wandrewkeech/SnakeOil-XY/README.md

Banner-logo

<a href="https://discord.gg/WZVP2HuAag" style="height: 40px !important;">Join us on Discord</a>

<a href='https://www.amazon.jp/hz/wishlist/ls/2AHXTCG01RYAZ?ref_=wl_share' target='_blank'>Buy Me a spool at amazon Japan</a>

# SnakeOil XY

Fully open source configurable high speed CoreXY 3D printer. Inspired by [HevORT](https://miragec79.github.io/HevORT/), [Voron](https://vorondesign.com/), [Annex Engineering](https://github.com/Annex-Engineering) and [EVA2](https://main.eva-3d.page/) design.

- Does not require any custom-machined parts or custom-cut panels.
- CoreXY, IDEX, and Extended-CoreXY kinematics.
- Designed to last, parts under stress are embedded with long bolts to handle the load.
- And our industry-leading SnakeOil technology :3 

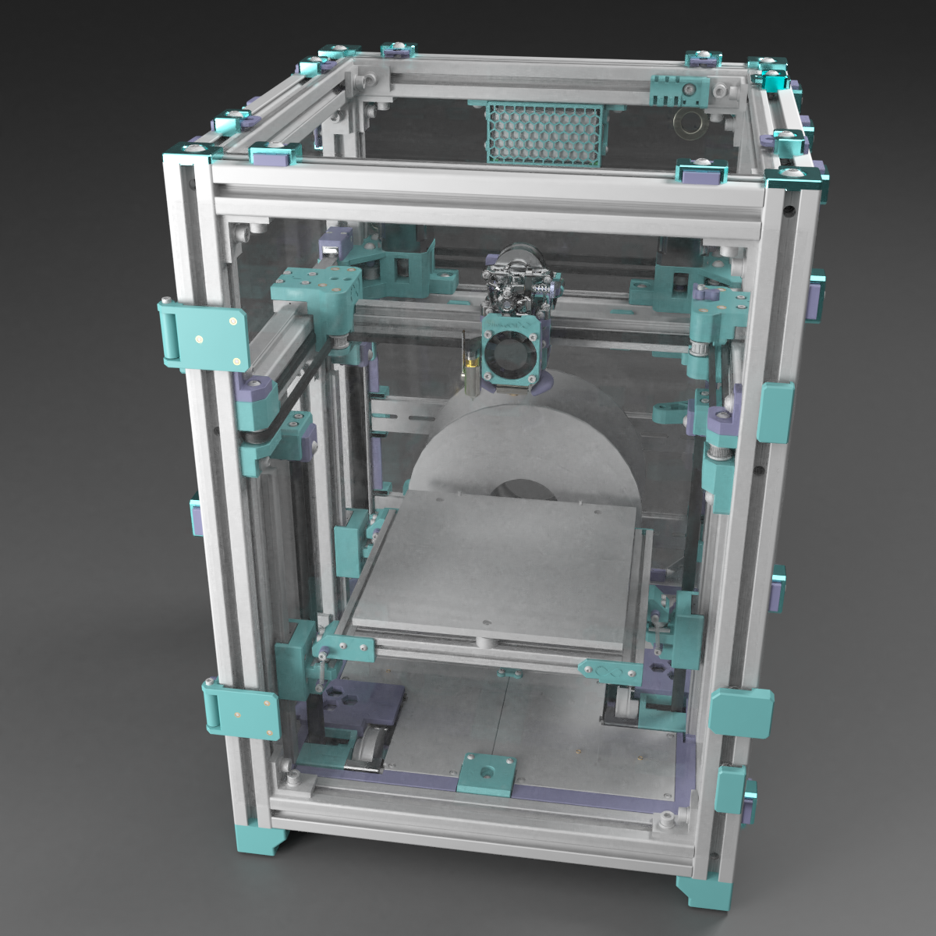
[picture p1: Doc/img/angle-render.png]
Render-angle


## Beta 3 release (2023-01-28)

- Add [IDEX variant](./BETA3_IDEX_Release_STL)(by Charles)
- Add [4PR variant](./BETA3_4PR_Release_STL) with new [Extended CoreXY kinematic](https://github.com/SnakeOilXY/klipper-extended-corexy-kinematic)
- Add klicky probe support(by Charles)
- New bed coupling kinematic using silicon spacers
- Add side-blower aux fan module
- Add EBB can toolhead board support
- Remove outdated components
- Merge toolhead design(1515 and 2020 gantry now use the same toolhead front/back/bottom design) and some small improvements on geometry

## Features

<table>
    <thead>
        <tr>
            <th>Feature</th>
            <th>Credit/Inspiration by/Description</th>
        </tr>
    </thead>
    <tbody>
        <tr>
            <td>Selectable kinematic : CoreXY, Hibryd-CoreXY </td>
            <td>Added on beta3 release</td>
        </tr>
        <tr>
            <td>Selectable single or dual toolhead </td>
            <td>Added on beta3 release</td>
        </tr>
        <tr>
            <td>3 Point auto bed tramming</td>
            <td>HevORT, Wobble ring</td>
        </tr>
        <tr>
            <td>Belted Z</td>
            <td>Lulz bot, Voron</td>
        </tr>
        <tr>
            <td>Din mounter</td>
            <td>Voron</td>
        </tr>
        <tr>
            <td>Cross belt corexy belt path</td>
            <td>HevORT</td>
        </tr>
        <tr>
            <td>Eva compatible toolhead</td>
            <td>EVA</td>
        </tr>
        <tr>
            <td>Filament spoll in side chamber</td>
            <td>-</td>
        </tr>
        <tr>
            <td>Quick release panels</td>
            <td>Added on beta2 release</td>
        </tr>
        <tr>
            <td>Built-in chamber air filter</td>
            <td>Added on beta1 release</td>
        </tr>
        <tr>
            <td>Auto build sheet detect and profile loader</td>
            <td>Work in progress</td>
        </tr>
        <tr>
            <td>AIO filament runout + jam detector + width sensor</td>
            <td>Work in progress</td>
        </tr>
        <tr>
            <td>Modular sensor add-on system</td>
            <td>Work in progress</td>
        </tr>
        <tr>
            <td>Probe(bed mesh) on print area only</td>
            <td>Added on beta2 using klipper macro</td>
        </tr>
        <tr>
            <td>Screwless belt mounter</td>
            <td>VzBot</td>
        </tr>
        <tr>
            <td>Bed fan</td>
            <td>Qholia</td>
        </tr>
    </tbody>
</table>

## Input shaper test result (beta2 1515 gantry with Sherpa mini extruder)

Shaper

## Layer pitch measure (beta2 1515 gantry with Sherpa mini extruder)

- Measure result provided by [株式会社グーテンベルク](https://gutenberg.co.jp/)
- PLA, 0.4mm nozzle, sliced with Cura 4.12.1 using "CoreXY FAST" profile.

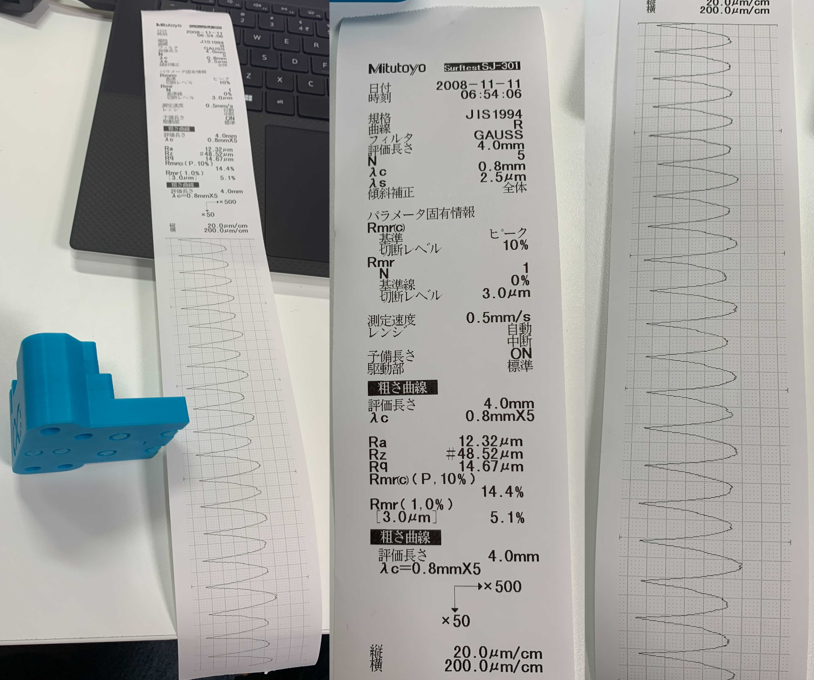
[picture p2: Doc/img/layer-measure.png]
Shaper


## Demo videos

<table>
    <thead>
        <tr>
            <th></th>
            <th align="center">Bed coupling</th>
            <th align="center">SpeedBoatRace</th>
            <th align="center">Slow benchy</th>
        </tr>
    </thead>
    <tbody>
        <tr>
            <td>Video</td>
            <td align="center"><a href="https://youtu.be/pQPhEykthEg" rel="nofollow">
            Bed coupling</a></td>
            <td align="center"><a href="https://youtu.be/tPoP6zmxsCY" rel="nofollow">
            Speed benchy</a></td>
            <td align="center"><a href="https://youtu.be/kLawpgAUUPE" rel="nofollow">
            Speed benchy</a></td>
        </tr>
        <tr>
            <td>Hardware version</td>
            <td align="center">beta1</td>
            <td align="center">beta2</td>
            <td align="center">beta2</td>
        </tr>
    </tbody>
</table>

## BOM

## **_SnakeOil-XY currently has 2 versions_**

<code>Both machines are practicaly identical, only difference is the build volume. </code>

### 180x180x180mm build volume (Standard)

- [180<sup>3</sup>mm BOM](./Doc/BOM/bom-180.md)

### 250x240x230mm build volume (Large)

- [250<sup>3</sup>mm BOM](./Doc/BOM/bom-250.md)

## Manual

[>>> Click here <<<](./Doc/Manual/README.md)

## Firmware

[>>> Click here <<<](./Firmware/README.md)

## Copyright Notice

- [Sherpa mini extruder](https://github.com/Annex-Engineering/Sherpa_Mini-Extruder) is an original work of [Annex Engineering](https://github.com/Annex-Engineering), modified parts using their source code/design files are re-released under [ANNEX Engineering License](https://github.com/Annex-Engineering/ANNEX-Engineering-License-Agreement/blob/main/LICENSE.md).
- [EVA2](https://github.com/EVA-3D/eva-main) is an original work of [EVA-3D](https://github.com/EVA-3D), modified parts using their source code/design files are re-released under [GNU General Public License v3.0](https://github.com/EVA-3D/eva-main/blob/main/LICENSE)
- This printer design(SnakeOil XY), it's document and software are released under [GNU General Public License v3.0](https://github.com/ChipCE/SnakeOil-XY/blob/master/LICENSE)
