wandrewkeech/SnakeOil-XY/BETA3_4PR_Release_STL/README.md

# BETA3 Release - 4PR variant

4PR(four paws runner) is an upgrade can add ontop of standard SnakeOilXY machines. This upgrade use our new kinematic called [Extended-corexy](https://github.com/SnakeOilXY/klipper-extended-corexy-kinematic).

## BOM

<table>
    <thead>
        <tr>
            <th>Item</th>
            <th>Quantity</th>
            <th>Description</th>
            <th>default link/affiliate link</th>
            <th>non-affiliate link</th>
        </tr>
    </thead>
    <tbody>
        <tr>
            <td>M3x4-HeatSet</td>
            <td>12</td>
            <td>M3 X D4.2 X L4.0</td>
            <td><a href="https://s.click.aliexpress.com/e/_Ad1n92" rel="nofollow">Aliexpress</a></td>
            <td><a href="https://www.Aliexpress.com/item/1005002526998853.html" rel="nofollow">Aliexpress</a></td>
        </tr>
        <tr>
            <td>M4 hex nut</td>
            <td>2</td>
            <td></td>
            <td></td>
            <td></td>
        </tr>
        <tr>
            <td>Socket head M3x10</td>
            <td>8</td>
            <td>button head also works</td>
            <td>-</td>
            <td>-</td>
        </tr>
        <tr>
            <td>Socket head M3x25</td>
            <td>4</td>
            <td>button head also works</td>
            <td>-</td>
            <td>-</td>
        </tr>
        <tr>
            <td>Button head M3x12</td>
            <td>8</td>
            <td>-</td>
            <td>-</td>
            <td>-</td>
        </tr>
        <tr>
            <td>Button head M3x30</td>
            <td>8</td>
            <td>-</td>
            <td>-</td>
            <td>-</td>
        </tr>
        <tr>
            <td>Button head M5x25</td>
            <td>4</td>
            <td>-</td>
            <td>-</td>
            <td>-</td>
        </tr>
        <tr>
            <td>Button head M6x14</td>
            <td>6</td>
            <td>-</td>
            <td>-</td>
            <td>-</td>
        </tr>
        <tr>
            <td>Grub screw M5x20</td>
            <td>2</td>
            <td>-</td>
            <td>-</td>
            <td>-</td>
        </tr>
        <tr>
            <td>Nema 17 motor</td>
            <td>2</td>
            <td>Use the same type as AB motors.max length 48mm</td>
            <td>-</td>
            <td>-</td>
        </tr>
        <tr>
            <td>20T 6mm Pulley (5mm bore)</td>
            <td>2</td>
            <td>-</td>
            <td>-</td>
            <td><a href="https://www.Aliexpress.com/item/33023279793.html" rel="nofollow">Aliexpress</a></td>
        </tr>
        <tr>
            <td>20T 6mm Smooth Idler (5mm bore)</td>
            <td>2</td>
            <td>-</td>
            <td>-</td>
            <td><a href="https://www.Aliexpress.com/item/33023133633.html" rel="nofollow">Aliexpress</a></td>
        </tr>
        <tr>
            <td>20T 6mm Tooth Idler (5mm bore)</td>
            <td>4</td>
            <td>-</td>
            <td>-</td>
            <td><a href="https://www.Aliexpress.com/item/33023133633.html" rel="nofollow">Aliexpress</a></td>
        </tr>
        <tr>
            <td>MR115 bearing</td>
            <td>2</td>
            <td>-</td>
            <td>-</td>
            <td>-</td>
        </tr>
    </tbody>
</table>

## Other info

- comming soon
