wandrewkeech/SnakeOil-XY/Mods/LCD_12864_RepRapDiscount/README.md

# RepRapDiscount Full Graphic Smart Controller (128x64 ST7920)

This type of LCD screen is often used in older Chinese 3D printers. This model would be useful for those who cannibalize old printers to build SnakeOil-XY. Silkscreen reads like: "RepRapDiscount Full Graphic Smart Controller www.bigtree-tech.com".

LCD controller: ST7920

[printer.cfg sample](sample-printer-cfg.cfg) - you can replace the latter part with the pin arrangement of your MCU.
