wandrewkeech/SnakeOil-XY/Mods/Nevermore_Filter/IDEX/README.md

# Nevermore mount for SnakeOil-XY IDEX **(UNTESTED)**

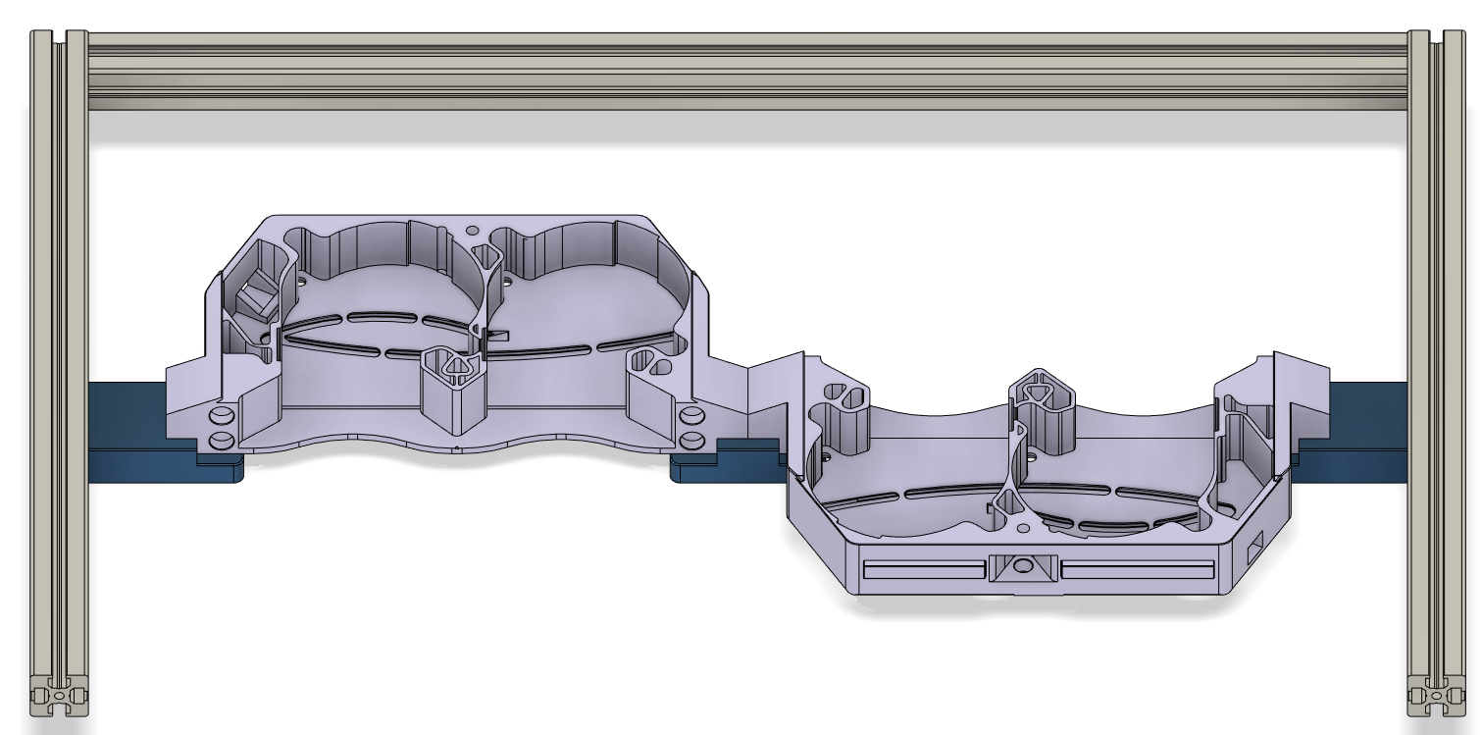
[picture p7: Doc/img/nevermore-idex.png]
nevermore-idex
