wandrewkeech/SnakeOil-XY/BETA3_IDEX_Release_STL/STLs/E-axis/README.md

# Toolhead, hotend and EVA2

Check [EVA compatible document for more info](https://github.com/SnakeOilXY/SnakeOil-XY/blob/master/Doc/Manual/eva2.md)
