wandrewkeech/SnakeOil-XY/BETA3_Standard_Release_STL/STLs/Add-on/AUX-fan/image.png

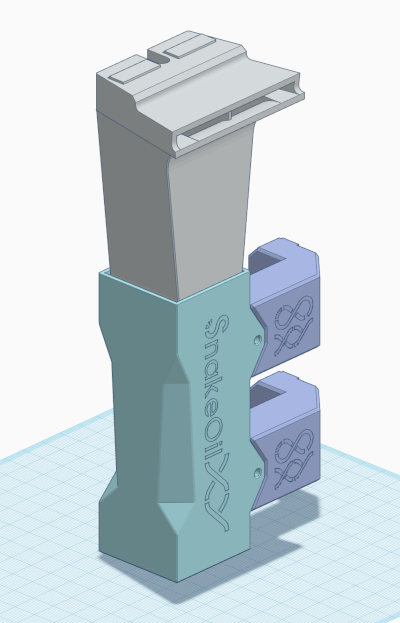
BETA3_Standard_Release_STL/STLs/Add-on/AUX-fan/image.png
