wandrewkeech/SnakeOil-XY/CAD/Render/v1-180_render.png

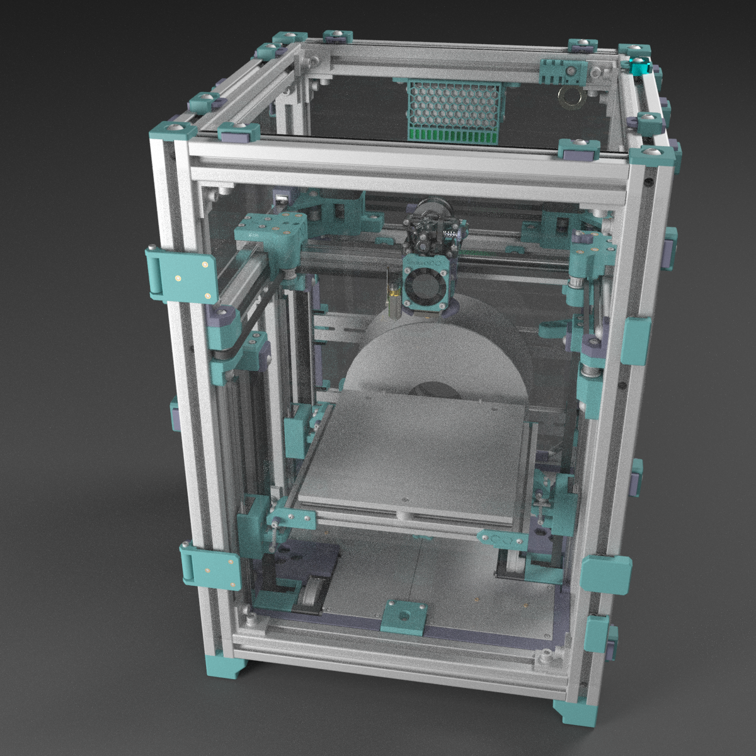
CAD/Render/v1-180_render.png
