wandrewkeech/SnakeOil-XY/Doc/img/all-bracket.png

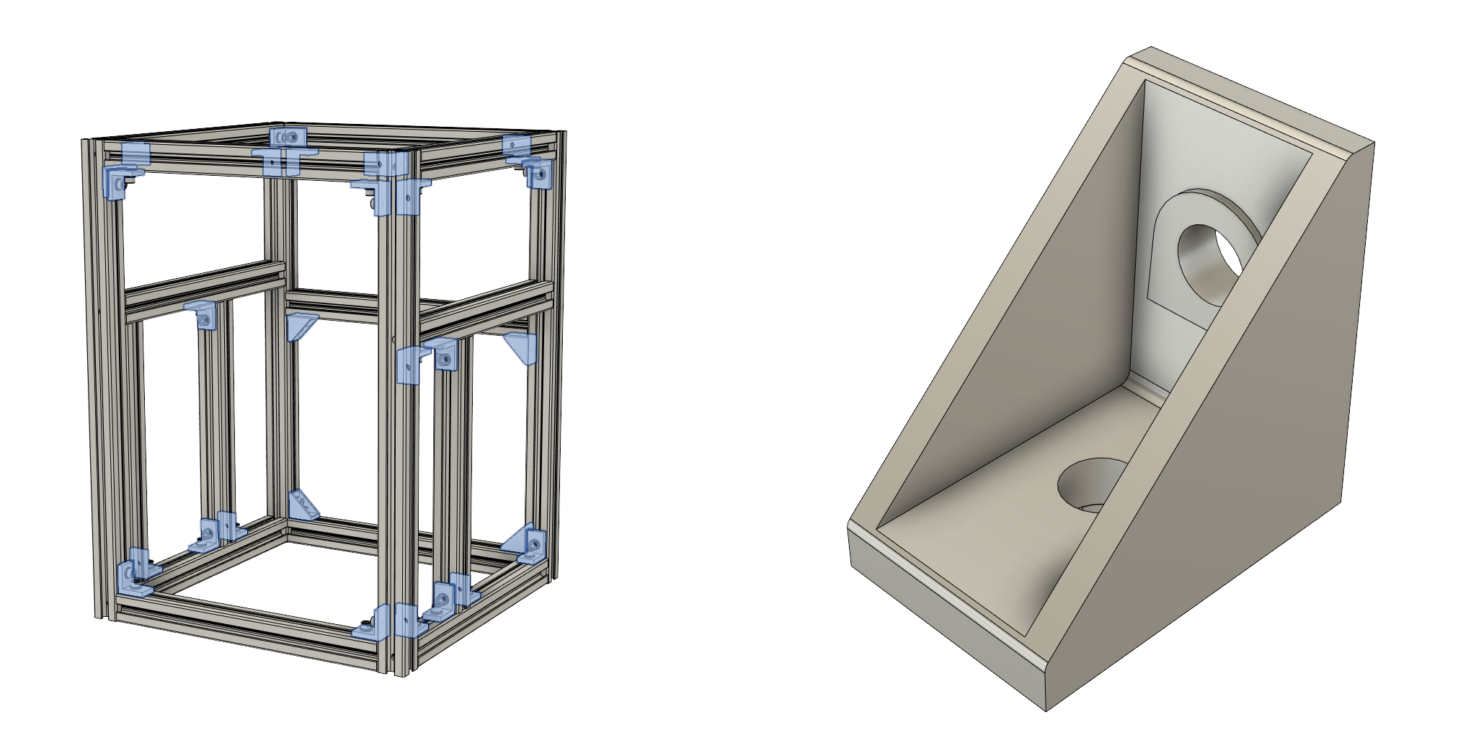
Doc/img/all-bracket.png
