wandrewkeech/SnakeOil-XY/Doc/img/close-render.png

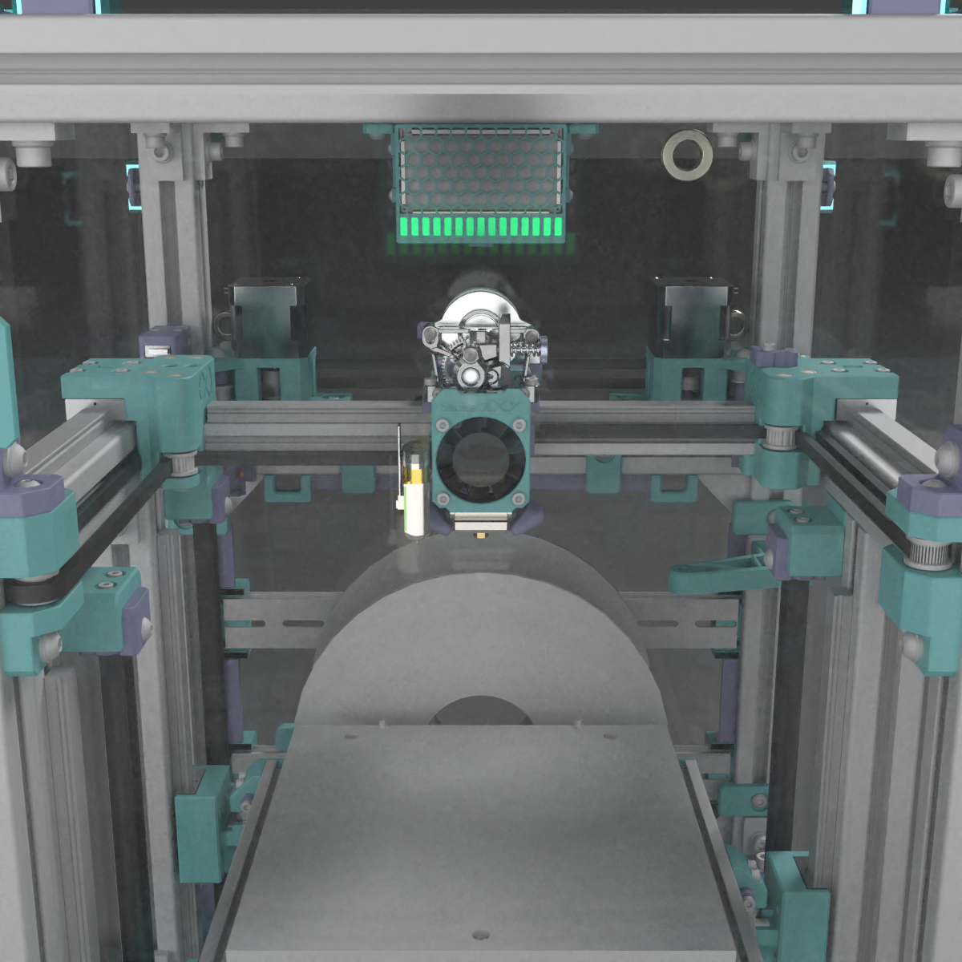
Doc/img/close-render.png
