wandrewkeech/SnakeOil-XY/Doc/img/front-render.png

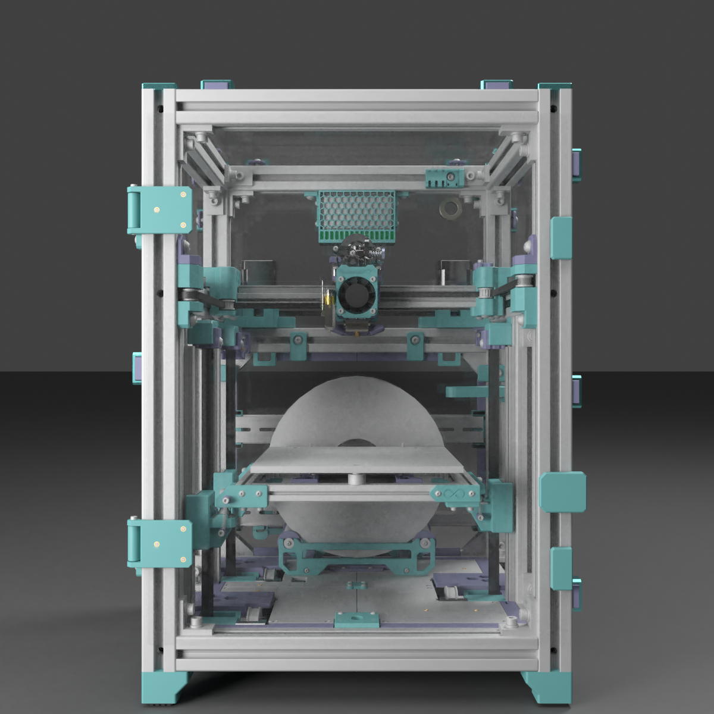
Doc/img/front-render.png
