wandrewkeech/SnakeOil-XY/Doc/img/normal-bracket.png

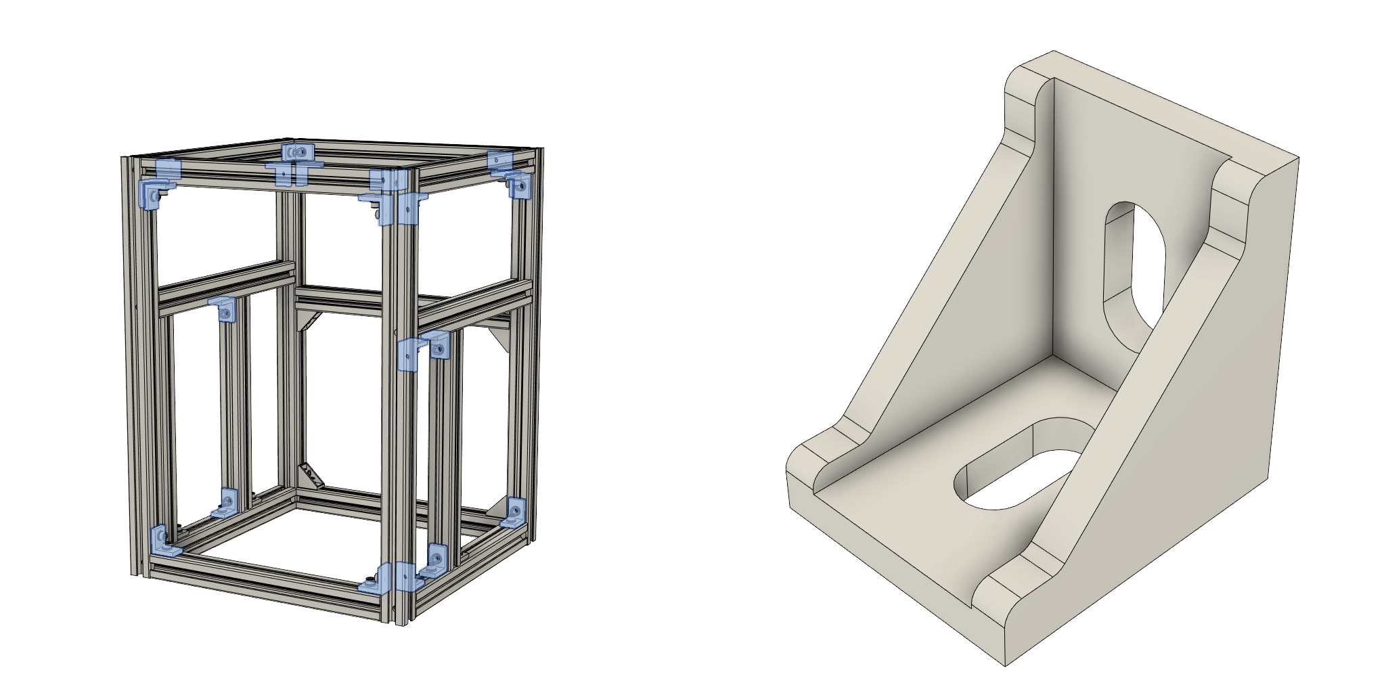
Doc/img/normal-bracket.png
