wandrewkeech/SnakeOil-XY/Slicer/Prusa/180_bed_texture.png

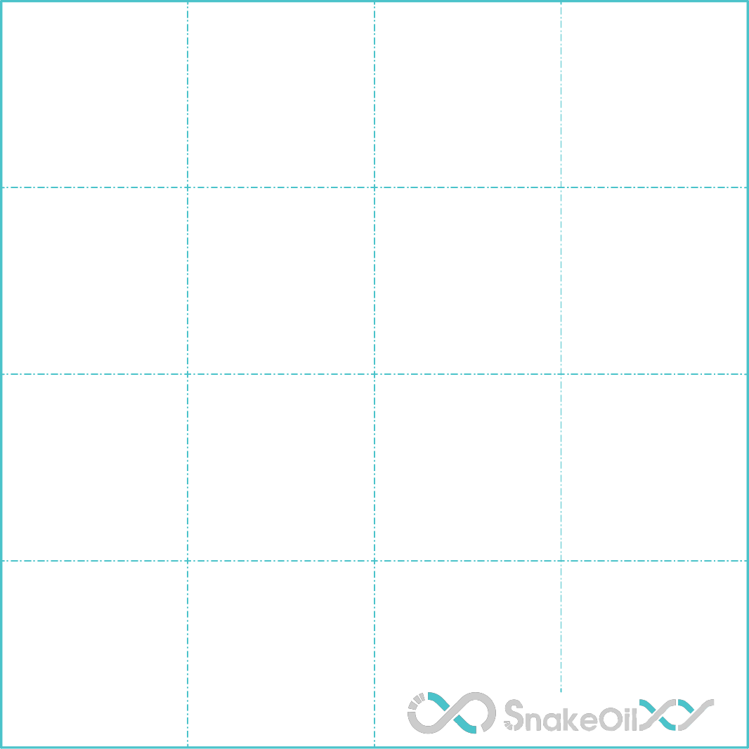
Slicer/Prusa/180_bed_texture.png
