wandrewkeech/SnakeOil-XY/Slicer/Prusa/250_bed_texture.png

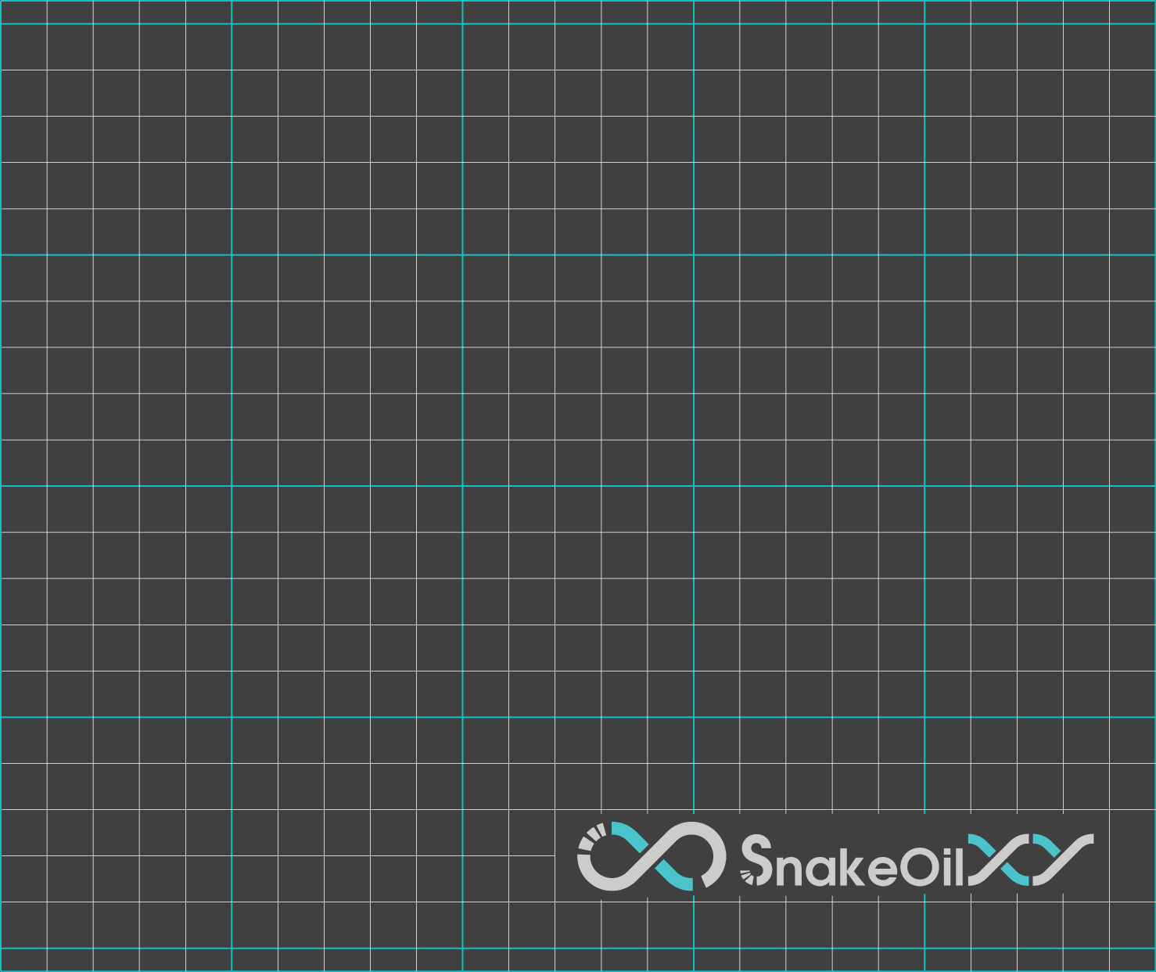
Slicer/Prusa/250_bed_texture.png
