wandrewkeech/SnakeOil-XY/Doc/BOM/bom-180.md

# BOM

<code>Status : work in progress</code>  
<code>Last updated : 2022-02-17</code>

<code> Fell free to [contact me](https://discord.gg/WZVP2HuAag) if you spot mistake or have question.</code>

## Read this first

## Table of contents

- [Kit](#0Kit)
- [Frame](#1Frame)
- [Fasteners](#2Fasteners)
- [Motion](#3Motion)
- [Electronics](#4Electronics)
- [Panels](#5Panels)
- [Other](#6Other)
- [Alternative bed coupling options](#7Alternative-bed-coupling-options)
- [Z counter weight](#8Z-counter-weight)

# 0.Kit

Some parts listed on the BOM can be purchased in kit format from below vendors

- [kb-3d.com store](https://kb-3d.com/store/81-snakeoilxy)
- [Mellow motion kit](https://s.click.aliexpress.com/e/_DDaa32j)

# 1.Frame

- [Main Frame](#main-frame)
- [Bed](#bed)
- [Gantry](#gantry)

## Main Frame

<table>
    <thead>
        <tr>
            <th>Item</th>
            <th>Quantity</th>
            <th>Misumi code</th>
        </tr>
    </thead>
	  <tbody>
        <tr>
            <td>3030 Extrusion 280mm</td>
            <td>3</td>
            <td>HFS6-3030-280</td>
        </tr>
        <tr>
            <td>3030 Extrusion 500mm</td>
            <td>4</td>
            <td>HFS6-3030-500</td>
        </tr>
        <tr>
            <td>3030 Extrusion 310mm</td>
            <td>11</td>
            <td>HFS6-3030-310</td>
        </tr>
        <tr>
            <td>3030, 30mm long, 20mm thick corner bracket<br>
            <a href="./corner-brackets.md" rel="nofollow">Check this if you don't have access to misumi brackets</a></td>
            <td>29</td>
            <td>HBLFSN6</td>
        </tr>
    </tbody>
</table>

<code>3030 extrusions are 8mm slot type, 2020 extrusions are 6mm slot type, 1515 extrusions are 3.4mm slot type
</code>

## Bed

### 1515 profile (recommended)

Instead of 1515 profile you can use [MakerBeamXL](https://www.makerbeam.com/makerbeamxl/), you just need to print a different version of the mountings.

<table>
    <thead>
        <tr>
            <th>Item</th>
            <th>Quantity</th>
            <th>Misumi code</th>
        </tr>
    </thead>
	  <tbody>
        <tr>
            <td>1515 Extrusion 190mm</td>
            <td>2</td>
            <td>HFS3-1515-190</td>
        </tr>
        <tr>
            <td>1515 Extrusion 185mm</td>
            <td>2</td>
            <td>HFS3-1515-185</td>
        </tr>
        <tr>
            <td>1515 Corner bracket</td>
            <td>4</td>
            <td>HBLTBS3</td>
        </tr>
    </tbody>
</table>

### 2020 profile

<table>
    <thead>
        <tr>
            <th>Item</th>
            <th>Quantity</th>
            <th>Misumi code</th>
        </tr>
    </thead>
	  <tbody>
        <tr>
            <td>2020 Extrusion 190mm</td>
            <td>2</td>
            <td>HFS5-2020-190</td>
        </tr>
        <tr>
            <td>2020 Extrusion 150mm</td>
            <td>2</td>
            <td>HFS5-2020-150</td>
        </tr>
        <tr>
            <td>2020 Corner bracket</td>
            <td>4</td>
            <td>HBLSS5</td>
        </tr>
    </tbody>
</table>

## Gantry

### 1515 profile (recommended)

Instead of 1515 profile you can use [MakerBeamXL](https://www.makerbeam.com/makerbeamxl/), you just need to print a different version of the mountings.

<table>
    <thead>
        <tr>
            <th>Item</th>
            <th>Quantity</th>
            <th>Misumi code</th>
        </tr>
    </thead>
	  <tbody>
        <tr>
            <td>1515 Extrusion 290mm</td>
            <td>1</td>
            <td>HFS3-1515-290</td>
        </tr>
    </tbody>
</table>

### 2020 profile

<table>
    <thead>
        <tr>
            <th>Item</th>
            <th>Quantity</th>
            <th>Misumi code</th>
        </tr>
    </thead>
	  <tbody>
        <tr>
            <td>2020 Extrusion 290mm</td>
            <td>1</td>
            <td>HFS5-2020-290</td>
        </tr>
    </tbody>
</table>

# 2.Fasteners

## Nuts and bolt

<table>
    <thead>
        <tr>
            <th>Item</th>
            <th>Quantity</th>
            <th>Description</th>
            <th>default link/affiliate link</th>
            <th>non-affiliate link</th>
        </tr>
    </thead>
    <tbody>
        <tr>
            <td>2020 M3 T-nut</td>
            <td>20</td>
            <td>for 2020 bed frame and gantry</td>
            <td><a href="https://s.click.aliexpress.com/e/_ASabWc" rel="nofollow">Aliexpress</a></td>
            <td><a href="https://www.aliexpress.com/item/4000293743251.html" rel="nofollow">Aliexpress</a></td>
        </tr>
        <tr>
            <td>2020 M5 T-nut</td>
            <td>15</td>
            <td> for 2020 bed frame and gantry</td>
            <td><a href="https://s.click.aliexpress.com/e/_ASabWc" rel="nofollow">Aliexpress</a></td>
            <td><a href="https://www.aliexpress.com/item/4000293743251.html" rel="nofollow">Aliexpress</a></td>
        </tr>
        <tr>
            <td>Square nut M3(hex nut also works)</td>
            <td>30</td>
            <td> for 1515 bed frame and gantry</td>
            <td></td>
            <td></td>
        </tr>
        <tr>
            <td>3030 M3 T-nut</td>
            <td>60</td>
            <td></td>
            <td><a href="https://s.click.aliexpress.com/e/_ASabWc" rel="nofollow">Aliexpress</a></td>
            <td><a href="https://www.aliexpress.com/item/4000293743251.html" rel="nofollow">Aliexpress</a></td>
        </tr>
        <tr>
            <td>3030 M5 T-nut</td>
            <td>10</td>
            <td></td>
            <td><a href="https://s.click.aliexpress.com/e/_ASabWc" rel="nofollow">Aliexpress</a></td>
            <td><a href="https://www.aliexpress.com/item/4000293743251.html" rel="nofollow">Aliexpress</a></td>
        </tr>
        <tr>
            <td>3030 M6 rotate T-nut</td>
            <td>101</td>
            <td></td>
            <td><a href="https://s.click.aliexpress.com/e/_ASabWc" rel="nofollow">Aliexpress</a></td>
            <td><a href="https://www.aliexpress.com/item/4000293743251.html" rel="nofollow">Aliexpress</a></td>
        </tr>
        <tr>
            <td>3030 M6 T-nut for frame bracket</td>
            <td>58</td>
            <td></td>
            <td><a href="https://s.click.aliexpress.com/e/_9vYq7gC" rel="nofollow">Aliexpress</a></td>
            <td><a href="https://www.aliexpress.com/item/33023772052.html" rel="nofollow">Aliexpress</a></td>
        </tr>
    </tbody>
</table>

<table>
    <thead>
        <tr>
            <th>Item</th>
            <th>Quantity</th>
            <th>Description</th>
            <th>default link/affiliate link</th>
            <th>non-affiliate link</th>
        </tr>
    </thead>
    <tbody>
        <tr>
            <td>M3x3-HeatSet</td>
            <td>50</td>
            <td>M3 X D4.2 X L3.0</td>
            <td><a href="https://s.click.aliexpress.com/e/_Ad1n92" rel="nofollow">Aliexpress</a></td>
            <td><a href="https://www.Aliexpress.com/item/1005002526998853.html" rel="nofollow">Aliexpress</a></td>
        </tr>
        <tr>
            <td>M3x4-HeatSet</td>
            <td>150</td>
            <td>M3 X D4.2 X L4.0</td>
            <td><a href="https://s.click.aliexpress.com/e/_Ad1n92" rel="nofollow">Aliexpress</a></td>
            <td><a href="https://www.Aliexpress.com/item/1005002526998853.html" rel="nofollow">Aliexpress</a></td>
        </tr>
        <tr>
            <td>M3x5x4-HeatSet</td>
            <td>5</td>
            <td>M3 X D5.0 X L4.0 (for sherpa mini)</td>
            <td><a href="https://s.click.aliexpress.com/e/_AcLT3I" rel="nofollow">Aliexpress</a></td>
            <td><a href="https://www.aliexpress.com/item/4000232858343.html" rel="nofollow">Aliexpress</a></td>
        </tr>
        <tr>
            <td>M4-HeatSet</td>
            <td>3</td>
            <td>M4 X D6.0 X L4.0 (for threaded ball bed coupler)</td>
            <td><a href="https://s.click.aliexpress.com/e/_A9WsSs" rel="nofollow">Aliexpress</a></td>
            <td><a href="https://www.Aliexpress.com/item/4000232925592.html" rel="nofollow">Aliexpress</a></td>
        </tr>
        <tr>
            <td>M5-HeatSet</td>
            <td>10</td>
            <td>M5 X D7.0 X L7.0</td>
            <td><a href="https://s.click.aliexpress.com/e/_AZBpZE" rel="nofollow">Aliexpress</a></td>
            <td><a href="https://www.aliexpress.com/item/4000232990523.html" rel="nofollow">Aliexpress</a></td>
        </tr>
    </tbody>
</table>

<table>
    <thead>
        <tr>
            <td>Item</td>
            <td>Quantity</td>
            <td>Description</td>
            <td>Norm</td>
        </tr>
    </thead>
    <tbody>
        <tr>
            <td>Button head M3x6</td>
            <td>75</td>
            <td></td>
            <td>ISO 7380 / DIN 7380</td>
        </tr>
        <tr>
            <td>Button head M3x8</td>
            <td>3</td>
            <td></td>
            <td>ISO 7380 / DIN 7380</td>
        </tr>
        <tr>
            <td>Button head M3x10</td>
            <td>14</td>
            <td></td>
            <td>ISO 7380 / DIN 7380</td>
        </tr>
        <tr>
            <td>Button head M3x12</td>
            <td>10</td>
            <td></td>
            <td>ISO 7380 / DIN 7380</td>
        </tr>
        <tr>
            <td>Button head M3x16</td>
            <td>5</td>
            <td></td>
            <td>ISO 7380 / DIN 7380</td>
        </tr>
        <tr>
            <td>Button head M3x20</td>
            <td>1</td>
            <td></td>
            <td>ISO 7380 / DIN 7380</td>
        </tr>
        <tr>
            <td>Button head M3x30</td>
            <td>4</td>
            <td></td>
            <td>ISO 7380 / DIN 7380</td>
        </tr>
        <tr>
            <td>Button head M3x35</td>
            <td>2</td>
            <td></td>
            <td>ISO 7380 / DIN 7380</td>
        </tr>
        <tr>
            <td>Button head M4x6</td>
            <td>4</td>
            <td></td>
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
            <td>Hex M4 nut</td>
            <td>2</td>
            <td></td>
            <td>DIN 934 / ISO 4032</td>
        </tr>
        <tr>
            <td>Hex M5 nut</td>
            <td>4</td>
            <td></td>
            <td>DIN 934 / ISO 4032</td>
        </tr>
    </tbody>
</table>

<table>
    <thead>
        <tr>
            <td>Item</td>
            <td>Quantity</td>
            <td>Description</td>
            <td>Norm</td>
        </tr>
    </thead>
    <tbody>
        <tr>
            <td>Small M3 washer</td>
            <td>71</td>
            <td></td>
            <td>ISO 7092 / DIN 433</td>
        </tr>
        <tr>
            <td>Small M5 washer</td>
            <td>2</td>
            <td></td>
            <td>ISO 7092 / DIN 433</td>
        </tr>
        <tr>
            <td>Normal M5 washer</td>
            <td>4*</td>
            <td>Check out a few lines below </td>
            <td>DIN 125 / ISO 7089</td>
        </tr>
        <tr>
            <td>Normal M6 washer</td>
            <td>91*</td>
            <td>Check out a few lines below </td>
            <td>DIN 125 / ISO 7089</td>
        </tr>
        <tr>
            <td>Wide M3 washer</td>
            <td>16</td>
            <td></td>
            <td>DIN 9021 / ISO 7093</td>
        </tr>
        <tr>
            <td>Spring M3 washer </td>
            <td>60</td>
            <td></td>
            <td>DIN 127 </td>
        </tr>
        <tr>
            <td>Normal M3 washer</td>
            <td>370</td>
            <td>We don't have a simple way to calculate the amount of washers you will need, if your budget can afford it buy as many as bolts </td>
            <td>DIN 125 / ISO 7089</td>
        </tr>
        <tr>
            <td>Normal M4 washer</td>
            <td>6</td>
            <td>We don't have a simple way to calculate the amount of washers you will need, if your budget can afford it buy as many as bolts </td>
            <td>DIN 125 / ISO 7089</td>
        </tr>
        <tr>
            <td>Normal M5 washer</td>
            <td>23</td>
            <td>We don't have a simple way to calculate the amount of washers you will need, if your budget can afford it buy as many as bolts </td>
            <td>DIN 125 / ISO 7089</td>
        </tr>
        <tr>
            <td>Normal M6 washer</td>
            <td>159</td>
            <td>We don't have a simple way to calculate the amount of washers you will need, if your budget can afford it buy as many as bolts </td>
            <td>DIN 125 / ISO 7089</td>
        </tr>
    </tbody>
</table>

# 3.Motion

<table>
    <thead>
        <tr>
            <th>Item</th>
            <th>Quantity</th>
            <th>Description</th>
            <th>default link/affiliate link</th>
            <th>non-affiliate link</th>
        </tr>
    </thead>
    <tbody>
        <tr>
            <td>MGN12H 250mm</td>
            <td>6</td>
            <td></td>
            <td></td>
            <td><a href="https://www.aliexpress.com/item/32829826159.html" rel="nofollow">Aliexpress</a></td>
        </tr>
        <tr>
            <td>20T 6mm Pulley (5mm bore)</td>
            <td>2</td>
            <td></td>
            <td></td>
            <td><a href="https://www.Aliexpress.com/item/33023279793.html" rel="nofollow">Aliexpress</a></td>
        </tr>
        <tr>
            <td>16T 6mm Pulley (5mm bore)</td>
            <td>3</td>
            <td></td>
            <td></td>
            <td><a href="https://www.Aliexpress.com/item/33002989677.html" rel="nofollow">Aliexpress</a></td>
        </tr>
        <tr>
            <td>80T 6mm Pulley (5mm bore)</td>
            <td>3</td>
            <td></td>
            <td></td>
            <td><a href="https://www.Aliexpress.com/item/1005001700640216.html" rel="nofollow">Aliexpress</a></td>
        </tr>
        <tr>
            <td>20T 9mm Pulley (5mm bore)</td>
            <td>3</td>
            <td></td>
            <td></td>
            <td><a href="https://www.Aliexpress.com/item/33023279793.html" rel="nofollow">Aliexpress</a></td>
        </tr>
        <tr>
            <td>20T 6mm Smooth Idler (5mm bore)</td>
            <td>10</td>
            <td></td>
            <td></td>
            <td><a href="https://www.Aliexpress.com/item/33023133633.html" rel="nofollow">Aliexpress</a></td>
        </tr>
        <tr>
            <td>20T 6mm Tooth Idler (5mm bore)</td>
            <td>2</td>
            <td></td>
            <td></td>
            <td><a href="https://www.Aliexpress.com/item/33023133633.html" rel="nofollow">Aliexpress</a></td>
        </tr>
        <tr>
            <td>20T 9mm Tooth idler (5mm bore)</td>
            <td>3</td>
            <td></td>
            <td></td>
            <td><a href="https://www.Aliexpress.com/item/33023133633.html" rel="nofollow">Aliexpress</a></td>
        </tr>
        <tr>
            <td>Close loop 188-2GT-6 RF belt</td>
            <td>3</td>
            <td></td>
            <td></td>
            <td><a href="https://www.Aliexpress.com/item/4000397043382.html" rel="nofollow">Aliexpress</a></td>
        </tr>
        <tr>
            <td>2GT 6mm belt</td>
            <td>~3m</td>
            <td>XY Gantry</td>
            <td></td>
            <td><a href="https://www.Aliexpress.com/item/32952396111.html" rel="nofollow">Aliexpress</a></td>
        </tr>
        <tr>
            <td>2GT 9mm belt</td>
            <td>~2m</td>
            <td>Belted Z</td>
            <td></td>
            <td><a href="https://www.Aliexpress.com/item/32952396111.html" rel="nofollow">Aliexpress</a></td>
        </tr>
        <tr>
            <td>MR115ZZ</td>
            <td>14</td>
            <td></td>
            <td></td>
            <td><a href="https://www.Aliexpress.com/item/32499551293.html" rel="nofollow">Aliexpress</a></td>
        </tr>
        <tr>
            <td>6mm x 16mm length shaft/dowel pin</td>
            <td>6</td>
            <td>Cut linear shafts, dowel pins or some good m3 spacers(outer dia 6mm) will also work.</td>
            <td><a href="https://s.click.aliexpress.com/e/_99m43S" rel="nofollow">Aliexpress</a></td>
            <td><a href="https://www.aliexpress.com/item/1005003326358562.html" rel="nofollow">Aliexpress</a></td>
        </tr>
        <tr>
            <td>Hook spring 0.5x4x20mm</td>
            <td>6</td>
            <td>Bed coupling</td>
            <td></td>
            <td><a href="https://www.Aliexpress.com/item/1005001491389608.html" rel="nofollow">Aliexpress</a></td>
        </tr>
        <tr>
            <td>Diameter 5mm x 65mm length shaft or dowel pin</td>
            <td>3</td>
            <td>Bed Coupling</td>
            <td></td>
            <td><a href="https://www.Aliexpress.com/item/1005003150582428.html" rel="nofollow">Aliexpress</a></td>
        </tr>
        <tr>
            <td>10mm M4 threaded ball</td>
            <td>3</td>
            <td>Ride on M5 dowels to ensure bed coupling</td>
            <td></td>
            <td><a href="https://www.Aliexpress.com/item/4001141631405.html" rel="nofollow">Aliexpress</a></td>
        </tr>
    </tbody>
</table>

# 4. Electronics

<table>
    <thead>
        <tr>
            <th>Item</th>
            <th>Quantity</th>
            <th>Description</th>
            <th>default link/affiliate link</th>
            <th>non-affiliate link</th>
        </tr>
    </thead>
    <tbody>
        <tr>
            <td>A/B stepper</td>
            <td>2</td>
            <td>MT-1704HSM168RE/E3D High Torque Motor (Body length: 48mm, shaft length:27mm). Other motor will work but the shaft might not long enough to reach the support bearing inside motor mounter</td>
            <td><a href="https://e3d-online.com/products/motors" rel="nofollow">E3D</a></td>
            <td></td>
        </tr>
        <tr>
            <td>Z stepper</td>
            <td>3</td>
            <td>MT-1703HSM168RE/E3D Compact But Powerful Motor (Body length: 40mm, shaft length:27mm). Other 40mm motor will work but the shaft might not long enough to reach the support bearing inside motor mounter</td>
            <td><a href="https://e3d-online.com/products/motors" rel="nofollow">E3D</a></td>
            <td></td>
        </tr>
        <tr>
            <td>Limit switch</td>
            <td>2</td>
            <td>You can choose pretty much any D2F switch from <a href="https://omronfs.omron.com/en_US/ecb/products/pdf/en-d2f.pdf" rel="nofollow">omron's catalog</a>, the best would be "Hinge lever" or "Simulated roller lever (R1.3)", for example: Omron D2F-L3-D3 or D2F-L-D3</td>
            <td><a href="https://www.digikey.com/en/products/detail/omron-electronics-inc-emc-div/D2F-L3-D3/6071977" rel="nofollow">Digikey</a></td>
            <td></td>
        </tr>
        <tr>
            <td>24V 200W PSU (mains powered heatbed)</td>
            <td>1</td>
            <td>Mean well LRS-200-24</td>
            <td><a href="https://www.digikey.com/en/products/detail/mean-well-usa-inc/LRS-200-24/7705026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" rel="nofollow">Digikey</a></td>
            <td></td>
        </tr>
        <tr>
            <td>SSR (for mains powered heatbed)</td>
            <td>1</td>
            <td>Omron G3NA-210B-DC5</td>
            <td><a href="https://www.grainger.com/product/OMRON-Solid-State-Relay-56LU49" rel="nofollow">Grainger</a> or <a href="https://www.digikey.com/en/products/detail/omron-automation-and-safety/G3NA-210B-UTU-DC5-24/634443?" rel="nofollow">Digikey</a> * Or any other SSR with the same dimension</td>
            <td></td>
        </tr>
        <tr>
            <td>24V 350W PSU (24V 180W heatbed)</td>
            <td>1</td>
            <td>Mean well LRS-350-24</td>
            <td><a href="https://www.digikey.com/en/products/detail/mean-well-usa-inc/LRS-350-24/7705034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" rel="nofollow">Digikey</a></td>
            <td></td>
        </tr>
        <tr>
            <td>5V PSU</td>
            <td>1</td>
            <td>Mean Well RS-25-5</td>
            <td><a href="https://www.digikey.com/en/products/detail/mean-well-usa-inc/RS-25-5/7706180" rel="nofollow">Digikey</a></td>
            <td></td>
        </tr>
        <tr>
            <td>Controller</td>
            <td>1</td>
            <td>Any board with 6 or more stepper driver (also check MCU for firmware compatibility)</td>
            <td><a href="https://s.click.aliexpress.com/e/_ArubHw" rel="nofollow">Fysetc Spider V1.1</a> OR <a href="https://s.click.aliexpress.com/e/_AKo4pI" rel="nofollow">BTT Octopus V1.1</a> OR <a href="https://s.click.aliexpress.com/e/_9heBrW" rel="nofollow">Mellow Super 8</a>(There are some reports of very slow respond endstop pin on the older version of the Super8 board. Check the vendor and make sure you buy the board with those problems fixed.) OR <a href="https://s.click.aliexpress.com/e/_AM3a6Y" rel="nofollow">BTT SKR Pro 1.2</a></td>
            <td><a href="https://www.aliexpress.com/item/1005002324070189.html" rel="nofollow">Fysetc Spider V1.1</a> OR <a href="https://www.aliexpress.com/item/1005002738104608.html" rel="nofollow">BTT Octopus V1.1</a> OR <a href="https://www.aliexpress.com/item/1005003235684044.html" rel="nofollow">Mellow Super 8</a>(There are some reports of very slow respond endstop pin on the older version of the Super8 board. Check the vendor and make sure you buy the board with those problems fixed.) OR <a href="https://www.aliexpress.com/item/33057570654.html" rel="nofollow">BTT SKR Pro 1.2</a></td>
        </tr>
        <tr>
            <td>Stepper Motor Drivers</td>
            <td>6</td>
            <td>You can usually get them bundled with your board. If not, we recommend TMC2209s</td>
            <td></td>
            <td></td>
        </tr>
        <tr>
            <td>Raspberry Pi</td>
            <td>1</td>
            <td>If you are planning on running Klipper you will need one of these.</td>
            <td><a href="https://www.digikey.com/en/products/detail/raspberry-pi/Raspberry-Pi-4B-4GB/10258781" rel="nofollow">Digikey</a></td>
            <td></td>
        </tr>
        <tr>
            <td>150x150mm silicon heater pad</td>
            <td>1</td>
            <td>150x150mm, 300W mains powered or 180W 24V</td>
            <td><a href="https://kb-3d.com/store/electronics/472-keenovo-silicone-heater-snakeoilxy-180mm-300w-110v-1642734498464.html" rel="nofollow">Keenovo custom size heater by kb-3d.com</a></td>
            <td><a href="https://keenovo.store/collections/standard-keenovo-silicone-heaters/products/keenovo-square-silicone-heater-3d-printer-build-plate-heatbed-heating-pad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" rel="nofollow">Keenovo</a></td>
        </tr>
        <tr>
            <td>Thermal Fuse</td>
            <td>1</td>
            <td>Get 125-130 deg C Fuse</td>
            <td></td>
            <td>Get 125-130 deg C Fuse <a href="https://www.aliexpress.com/item/32885492280.html" rel="nofollow">Aliexpress</a></td>
        </tr>
        <tr>
            <td>92mmx25mm Under bed fan</td>
            <td>1</td>
            <td>This fan does not need to be strong. Go with the slowest, most quiet fan you can get.</td>
            <td><a href="https://www.digikey.com/en/products/detail/sunon-fans/PF92251V3-1000U-F99/7927804" rel="nofollow">Digikey</a></td>
            <td></td>
        </tr>
        <tr>
            <td>Extruder</td>
            <td>1</td>
            <td>Check <a href="/SnakeOilXY/SnakeOil-XY/blob/master/Doc/Manual/eva2.md">EVA2 compatible</a>, we recommend using sherpa mini, it's possible to buy a kit with all the parts that you would need</td>
            <td><a href="https://www.aliexpress.com/item/1005002192629947.html?spm=a2g0o.cart.0.0.3f603c00KRzQK3&mp=1">Aliexpress</a></td>
            <td></td>
        </tr>
        <tr>
            <td>Hot End (Supported)</td>
            <td>1</td>
            <td></td>
            <td><a href="https://s.click.aliexpress.com/e/_Asn7xW" rel="nofollow">Dragon</a> OR <a href="https://www.sliceengineering.com/products/the-mosquito-hotend" rel="nofollow">Mosquitto</a> OR <a href="https://www.sliceengineering.com/products/copperhead-hotends" rel="nofollow">Copperhead</a> OR Mellow NF crazy</td>
            <td><a href="https://www.aliexpress.com/item/1005002629698126.html" rel="nofollow">Dragon</a> OR <a href="https://www.sliceengineering.com/products/the-mosquito-hotend" rel="nofollow">Mosquitto</a> OR <a href="https://www.sliceengineering.com/products/copperhead-hotends" rel="nofollow">Copperhead</a></td>
        </tr>
        <tr>
            <td>Heater Cartridge</td>
            <td>1</td>
            <td></td>
            <td>50W 24V <a href="https://s.click.aliexpress.com/e/_9Gv96G" rel="nofollow">Aliexpress</a> or 60W 24V <a href="https://s.click.aliexpress.com/e/_ADiKwC" rel="nofollow">Aliexpress</a></td>
            <td>50W 24V <a href="https://www.aliexpress.com/item/32960167491.html" rel="nofollow">Aliexpress</a> or 60W 24V <a href="https://www.aliexpress.com/item/4000974620358.html" rel="nofollow">Aliexpress</a></td>
        </tr>
        <tr>
            <td>Thermistor</td>
            <td>1</td>
            <td></td>
            <td>PT100 for under 280C <a href="https://s.click.aliexpress.com/e/_991uvQ" rel="nofollow">Aliexpress</a> T-D500 for high temp <a href="https://s.click.aliexpress.com/e/_9h0o5W" rel="nofollow">Aliexpress</a></td>
            <td>PT100 for under 280C <a href="https://www.aliexpress.com/item/33029709571.html" rel="nofollow">Aliexpress</a> T-D500 for high temp <a href="https://www.aliexpress.com/item/4000907614466.html" rel="nofollow">Aliexpress</a></td>
        </tr>
        <tr>
            <td>WAGO</td>
            <td>3x10pcs</td>
            <td>Buy some 221 series wagos, some of each sizes - 2, 3 and 5 conductors</td>
            <td></td>
            <td></td>
        </tr>
        <tr>
            <td>22AWG Wires</td>
            <td>50m</td>
            <td></td>
            <td></td>
            <td></td>
        </tr>
        <tr>
            <td>18AWG Wires</td>
            <td>3m</td>
            <td>for Heater Cartridge in hotend</td>
            <td></td>
            <td></td>
        </tr>
        <tr>
            <td>16AWG Wires</td>
            <td>10m</td>
            <td>for mains voltage -> power supplies, power supplies -> board IN, board bed -> heatbed</td>
            <td></td>
            <td></td>
        </tr>
        <tr>
            <td>HTU21D sensor</td>
            <td>1</td>
            <td>*Optional</td>
            <td></td>
            <td><a href="https://www.Aliexpress.com/item/32585920923.html" rel="nofollow">Aliexpress</a></td>
        </tr>
        <tr>
            <td>Camera</td>
            <td>1</td>
            <td>*Optional</td>
            <td></td>
            <td><a href="https://www.Aliexpress.com/item/4000929363815.html" rel="nofollow">Aliexpress</a></td>
        </tr>
        <tr>
            <td>Neopixel WS2812B</td>
            <td>0.5m</td>
            <td>*Optional</td>
            <td></td>
            <td><a href="https://www.Aliexpress.com/item/2036819167.html" rel="nofollow">Aliexpress</a></td>
        </tr>
        <tr>
            <td>Neopixel tray</td>
            <td>0.5m</td>
            <td>*Optional</td>
            <td><a href="https://s.click.aliexpress.com/e/_DkBqBCR" rel="nofollow">Aliexpress</a></td>
            <td><a href="https://www.aliexpress.com/item/32879628265.html" rel="nofollow">Aliexpress</a></td>
        </tr>
        <tr>
            <td>*Sonoff mini (wifi version)</td>
            <td>1</td>
            <td>*Optional. This can be use to control the printer power via Fluidd or Mainsail UI(Custom firmware required)</td>
            <td><a href="https://s.click.aliexpress.com/e/_9uzxay" rel="nofollow">Aliexpress</a></td>
            <td><a href="https://www.aliexpress.com/item/4000060915796.html" rel="nofollow">Aliexpress</a></td>
        </tr>
        <tr>
            <td>Mini 128x64 LCD</td>
            <td>1</td>
            <td>*Optional. Might require some simple modification to fit in to the retro LCD mount</td>
            <td><a href="https://s.click.aliexpress.com/e/_9fsIok" rel="nofollow">Aliexpress</a></td>
            <td><a href="https://www.aliexpress.com/item/1005001729369638.html" rel="nofollow">Aliexpress</a></td>
        </tr>
        <tr>
            <td>BLtouch or clone</td>
            <td>1</td>
            <td>Default option for bed probe</td>
            <td><a href="https://s.click.aliexpress.com/e/_9AlXQ9" rel="nofollow">Aliexpress</a></td>
            <td>-</td>
        </tr>
        <tr>
            <td>Panasonic GX-H8B</td>
            <td>1</td>
            <td>Other option for bed probe. Very good accuracy and low temp drift</td>
            <td>-</td>
            <td><a href="https://www.digikey.com/en/products/detail/panasonic-industrial-automation-sales/GX-H8B/3899483" rel="nofollow">Digikey</a></td>
        </tr>
        <tr>
            <td>Cherry MX switch or clone</td>
            <td>4</td>
            <td>*Optional. For button panel</td>
            <td><a href="https://s.click.aliexpress.com/e/_9vqP7A" rel="nofollow">Aliexpress</a></td>
            <td><a href="https://www.aliexpress.com/item/1005001681627152.html" rel="nofollow">Aliexpress</a></td>
        </tr>
    </tbody>
</table>

# 5.Panels

<table>
    <thead>
        <tr>
            <th>Item</th>
            <th>Quantity</th>
            <th>Description</th>
            <th>default link/affiliate link</th>
            <th>non-affiliate link(not affiliated)</th>
        </tr>
    </thead>
    <tbody>
        <tr>
            <td>Front-panel 360x454x3mm</td>
            <td>1</td>
            <td></td>
            <td></td>
            <td></td>
        </tr>
        <tr>
            <td>Side-panel 324x454x3mm</td>
            <td>2</td>
            <td></td>
            <td></td>
            <td></td>
        </tr>
        <tr>
            <td>Rear-top-panel 324x179x3mm</td>
            <td>1</td>
            <td></td>
            <td></td>
            <td></td>
        </tr>
        <tr>
            <td>Rear-bottom-panel 309x244x3mm</td>
            <td>1</td>
            <td></td>
            <td></td>
            <td></td>
        </tr>
        <tr>
            <td>Top-panel 324x324x3mm</td>
            <td>1</td>
            <td></td>
            <td></td>
            <td></td>
        </tr>
    </tbody>
</table>

# 6.Other

<table>
    <thead>
        <tr>
            <th>Item</th>
            <th>Quantity</th>
            <th>Description</th>
            <th>default link/affiliate link</th>
            <th>non-affiliate link(</th>
        </tr>
    </thead>
    <tbody>
        <tr>
            <td>Prusa mini spring steel PEI sheet</td>
            <td>1</td>
            <td></td>
            <td></td>
            <td></td>
        </tr>
        <tr>
            <td>Prusa mini magnet sheet</td>
            <td>1</td>
            <td></td>
            <td></td>
            <td></td>
        </tr>
        <tr>
            <td>190x193 aluminum plate</td>
            <td>1</td>
            <td></td>
            <td></td>
            <td></td>
        </tr>
        <tr>
            <td>DIN rail 282mm</td>
            <td>1</td>
            <td></td>
            <td></td>
            <td></td>
        </tr>
        <tr>
            <td>DIN rail 309mm</td>
            <td>2</td>
            <td></td>
            <td></td>
            <td></td>
        </tr>
        <tr>
            <td>6x3mmm round(disk) magnet</td>
            <td>8</td>
            <td></td>
            <td><a href="https://s.click.aliexpress.com/e/_9wFag8" rel="nofollow">Aliexpress</a></td>
            <td><a href="https://www.aliexpress.com/item/1005001614044682.html" rel="nofollow">Aliexpress</a></td>
        </tr>
        <tr>
            <td>19x5x1.5mm Block magnet</td>
            <td>3</td>
            <td>Smaller magnet also works</td>
            <td><a href="https://www.Aliexpress.com/item/4000955510987.html" rel="nofollow">Aliexpress</a></td>
            <td><a href="https://www.Aliexpress.com/item/4000955510987.html" rel="nofollow">Aliexpress</a></td>
        </tr>
        <tr>
            <td>Spacer for bed plate mount</td>
            <td>3</td>
            <td>You can use yellow springs or silicone spacers, you just need to cut them to a length of about 10mm</td>
            <td><a href="https://www.Aliexpress.com/item/1005001391148294.html" rel="nofollow">Aliexpress</a></td>
            <td><a href="https://www.Aliexpress.com/item/1005001391148294.html" rel="nofollow">Aliexpress</a></td>
        </tr>
        <tr>
            <td>Foam tape 5mmx1mm</td>
            <td>7m</td>
            <td></td>
            <td></td>
            <td></td>
        </tr>
        <tr>
            <td>F623 bearing</td>
            <td>4</td>
            <td>For spool holder</td>
            <td><a href="https://s.click.aliexpress.com/e/_9wTkxi" rel="nofollow">Aliexpress</a></td>
            <td></td>
        </tr>
        <tr>
            <td>E3D 1.75mm collet</td>
            <td>2</td>
            <td>For sherpa mini and filament guide arm</td>
            <td><a href="https://e3d-online.com/products/embedded-bowden-collet-for-metal-1-75mm?_pos=2&amp;_sid=bda6a9f42&amp;_ss=r" rel="nofollow">E3D online</a></td>
            <td></td>
        </tr>
    </tbody>
</table>

# 7.Alternative bed coupling options

There are many options for bed coupling. Some of them are from old beta design, some are mods from community.
You can choose the option you like, but please note that the one in assembly CAD is threaded ball method(default option).
For other coupling option please check [Alternative bed coupling options document](./bed-coupling.md)

# 8.Z counter weight

<code>2022-03-25 update : Coil spring 6701ZZ bearing and U624ZZ are now included in the [Mellow motion kit](https://www.aliexpress.com/item/1005003678647655.html?spm=5261.ProductManageOnline.0.0.7dde4edftj4RDj) </code>

<table>
    <thead>
        <tr>
            <th>Item (main frame)</th>
            <th>Quantity</th>
            <th>Description</th>
            <th>default link/affiliate link</th>
            <th>non-affiliate link</th>
        </tr>
    </thead>
    <tbody>
        <tr>
            <td>Coil spring</td>
            <td>1</td>
            <td>0.3x7x800mm</td>
            <td><a href="https://s.click.aliexpress.com/e/_AV76zu" rel="nofollow">Aliexpress</a></td>
            <td><a href="https://www.aliexpress.com/item/1005001268326005.html" rel="nofollow">Aliexpress</a></td>
        </tr>
        <tr>
            <td>6701ZZ bearing</td>
            <td>3</td>
            <td></td>
            <td><a href="https://s.click.aliexpress.com/e/_AqxLHc" rel="nofollow">Aliexpress</a></td>
            <td><a href="https://www.aliexpress.com/item/32862440553.html" rel="nofollow">Aliexpress</a></td>
        </tr>
        <tr>
            <td>U624ZZ bearing</td>
            <td>1</td>
            <td></td>
            <td><a href="https://s.click.aliexpress.com/e/_9wmu5C" rel="nofollow">Aliexpress</a></td>
            <td><a href="https://www.aliexpress.com/item/33026418058.html" rel="nofollow">Aliexpress</a></td>
        </tr>
        <tr>
            <td>Cable/Wire for pulley</td>
            <td>1</td>
            <td>Most ~0.5mm diameter wire will work. PE fishing line is a great option</td>
            <td></td>
            <td></td>
        </tr>
        <tr>
            <td>M6 washer</td>
            <td>3</td>
            <td></td>
            <td></td>
            <td></td>
        </tr>
        <tr>
            <td>Button head M6x14 screw</td>
            <td>5</td>
            <td></td>
            <td></td>
            <td></td>
        </tr>
        <tr>
            <td>Button head M3x6 screw</td>
            <td>1</td>
            <td></td>
            <td></td>
            <td></td>
        </tr>
        <tr>
            <td>Socket head M3x14 screw</td>
            <td>2</td>
            <td></td>
            <td></td>
            <td></td>
        </tr>
        <tr>
            <td>Socket head M3x20 screw</td>
            <td>3</td>
            <td></td>
            <td></td>
            <td></td>
        </tr>
        <tr>
            <td>Socket head M3x30 screw</td>
            <td>3</td>
            <td></td>
            <td></td>
            <td></td>
        </tr>
        <tr>
            <td>Socket head M3x45 screw</td>
            <td>2</td>
            <td></td>
            <td></td>
            <td></td>
        </tr>
        <tr>
            <td>Button head M4x40 screw</td>
            <td>1</td>
            <td></td>
            <td></td>
            <td></td>
        </tr>
        <tr>
            <td>M3x4-HeatSet</td>
            <td>8</td>
            <td>M3 X D4.2 X L4.0</td>
            <td><a href="https://s.click.aliexpress.com/e/_Ad1n92" rel="nofollow">Aliexpress</a></td>
            <td><a href="https://www.aliexpress.com/item/4000761483243.html" rel="nofollow">Aliexpress</a> or <a href="https://www.Aliexpress.com/item/4000955759713.html" rel="nofollow">Aliexpress</a> or <a href="https://www.Aliexpress.com/item/1005002526998853.html" rel="nofollow">Aliexpress</a></td>
        </tr>
        <tr>
            <td>M4-HeatSet</td>
            <td>1</td>
            <td>M4 X D6.0 X L4.0</td>
            <td><a href="https://s.click.aliexpress.com/e/_A9WsSs" rel="nofollow">Aliexpress</a></td>
            <td><a href="https://www.Aliexpress.com/item/4000232925592.html" rel="nofollow">Aliexpress</a></td>
        </tr>
    </tbody>
</table>
