wandrewkeech/SnakeOil-XY/Doc/BOM/bom-250.md

# BOM

<code>Status : work in progress</code>  
<code>Last updated : 2022-02-17</code>

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

## Read this first

## Table of contents

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

# 0.Kit

Some parts listed on the BOM can be purchased in kit format from below vendors

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

# 1.Frame

- [Main Frame](#main-frame)
- [Bed](#bed)
- [Gantry](#gantry)

## Main Frame

<table>
    <thead>
        <tr>
            <th>Item</th>
            <th>Quantity</th>
            <th>Misumi code</th>
        </tr>
    </thead>
	  <tbody>
        <tr>
            <td>3030 Extrusion 330mm</td>
            <td>3</td>
            <td>HFS6-3030-330</td>
        </tr>
        <tr>
            <td>3030 Extrusion 550mm</td>
            <td>4</td>
            <td>HFS6-3030-550</td>
        </tr>
        <tr>
            <td>3030 Extrusion 380mm</td>
            <td>5</td>
            <td>HFS6-3030-380</td>
        </tr>
        <tr>
            <td>3030 Extrusion 360mm</td>
            <td>6</td>
            <td>HFS6-3030-360</td>
        </tr>
        <tr>
            <td>3030, 30mm long, 20mm thick corner bracket<br>
            <a href="./corner-brackets.md" rel="nofollow">Check this if you don't have access to misumi brackets</a></td>
            <td>29</td>
            <td>HBLFSN6</td>
        </tr>
    </tbody>
</table>

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

## Bed

### 1515 profile (recommended)

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

<table>
    <thead>
        <tr>
            <th>Item</th>
            <th>Quantity</th>
            <th>Misumi code</th>
        </tr>
    </thead>
	  <tbody>
        <tr>
            <td>1515 Extrusion 260mm</td>
            <td>2</td>
            <td>HFS3-1515-260</td>
        </tr>
        <tr>
            <td>1515 Extrusion 235mm</td>
            <td>2</td>
            <td>HFS3-1515-235</td>
        </tr>
        <tr>
            <td>1515 Corner bracket</td>
            <td>4</td>
            <td>HBLTBS3</td>
        </tr>
    </tbody>
</table>

### 2020 profile

<table>
    <thead>
        <tr>
            <th>Item</th>
            <th>Quantity</th>
            <th>Misumi code</th>
        </tr>
    </thead>
	  <tbody>
        <tr>
            <td>2020 Extrusion 240mm</td>
            <td>2</td>
            <td>HFS5-2020-240</td>
        </tr>
        <tr>
            <td>2020 Extrusion 220mm</td>
            <td>2</td>
            <td>HFS5-2020-220</td>
        </tr>
        <tr>
            <td>2020 Corner bracket</td>
            <td>4</td>
            <td>HBLSS5</td>
        </tr>
    </tbody>
</table>

## Gantry

### 1515 profile (recommended)

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

<table>
    <thead>
        <tr>
            <th>Item</th>
            <th>Quantity</th>
            <th>Misumi code</th>
        </tr>
    </thead>
	  <tbody>
        <tr>
            <td>1515 Extrusion 360mm</td>
            <td>1</td>
            <td>HFS3-1515-360</td>
        </tr>
    </tbody>
</table>

### 2020 profile

<table>
    <thead>
        <tr>
            <th>Item</th>
            <th>Quantity</th>
            <th>Misumi code</th>
        </tr>
    </thead>
	  <tbody>
        <tr>
            <td>2020 Extrusion 360mm</td>
            <td>1</td>
            <td>HFS5-2020-360</td>
        </tr>
    </tbody>
</table>

# 2.Fasteners

## Nuts and bolt

<table>
    <thead>
        <tr>
            <th>Item</th>
            <th>Quantity</th>
            <th>Description</th>
            <th>default link/affiliate link</th>
            <th>non-affiliate link</th>
        </tr>
    </thead>
    <tbody>
        <tr>
            <td>2020 M3 T-nut</td>
            <td>20</td>
            <td>for 2020 bed frame and gantry</td>
            <td><a href="https://s.click.aliexpress.com/e/_ASabWc" rel="nofollow">Aliexpress</a></td>
            <td><a href="https://www.aliexpress.com/item/4000293743251.html" rel="nofollow">Aliexpress</a></td>
        </tr>
        <tr>
            <td>2020 M5 T-nut</td>
            <td>15</td>
            <td> for 2020 bed frame and gantry</td>
            <td><a href="https://s.click.aliexpress.com/e/_ASabWc" rel="nofollow">Aliexpress</a></td>
            <td><a href="https://www.aliexpress.com/item/4000293743251.html" rel="nofollow">Aliexpress</a></td>
        </tr>
        <tr>
            <td>Square nut M3(hex nut also works)</td>
            <td>30</td>
            <td> for 1515 bed frame and gantry</td>
            <td></td>
            <td></td>
        </tr>
        <tr>
            <td>3030 M3 T-nut</td>
            <td>60</td>
            <td></td>
            <td><a href="https://s.click.aliexpress.com/e/_ASabWc" rel="nofollow">Aliexpress</a></td>
            <td><a href="https://www.aliexpress.com/item/4000293743251.html" rel="nofollow">Aliexpress</a></td>
        </tr>
        <tr>
            <td>3030 M5 T-nut</td>
            <td>10</td>
            <td></td>
            <td><a href="https://s.click.aliexpress.com/e/_ASabWc" rel="nofollow">Aliexpress</a></td>
            <td><a href="https://www.aliexpress.com/item/4000293743251.html" rel="nofollow">Aliexpress</a></td>
        </tr>
        <tr>
            <td>3030 M6 T-nut</td>
            <td>160</td>
            <td></td>
            <td><a href="https://s.click.aliexpress.com/e/_ASabWc" rel="nofollow">Aliexpress</a></td>
            <td><a href="https://www.aliexpress.com/item/4000293743251.html" rel="nofollow">Aliexpress</a></td>
        </tr>
    </tbody>
</table>

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

# 3.Motion

<table>
    <thead>
        <tr>
            <th>Item</th>
            <th>Quantity</th>
            <th>Description</th>
            <th>default link/affiliate link</th>
            <th>non-affiliate link</th>
        </tr>
    </thead>
    <tbody>
        <tr>
            <td>MGN12H 300mm</td>
            <td>5</td>
            <td></td>
            <td></td>
            <td><a href="https://www.aliexpress.com/item/32829826159.html" rel="nofollow">Aliexpress</a></td>
        </tr>
        <tr>
            <td>MGN12H 320mm</td>
            <td>1</td>
            <td></td>
            <td></td>
            <td><a href="https://www.aliexpress.com/item/32829826159.html" rel="nofollow">Aliexpress</a></td>
        </tr>
        <tr>
            <td>20T 6mm Pulley (5mm bore)</td>
            <td>2</td>
            <td></td>
            <td></td>
            <td><a href="https://www.Aliexpress.com/item/33023279793.html" rel="nofollow">Aliexpress</a></td>
        </tr>
        <tr>
            <td>16T 6mm Pulley (5mm bore)</td>
            <td>3</td>
            <td></td>
            <td></td>
            <td><a href="https://www.Aliexpress.com/item/33002989677.html" rel="nofollow">Aliexpress</a></td>
        </tr>
        <tr>
            <td>80T 6mm Pulley (5mm bore)</td>
            <td>3</td>
            <td></td>
            <td></td>
            <td><a href="https://www.Aliexpress.com/item/1005001700640216.html" rel="nofollow">Aliexpress</a></td>
        </tr>
        <tr>
            <td>20T 9mm Pulley (5mm bore)</td>
            <td>3</td>
            <td></td>
            <td></td>
            <td><a href="https://www.Aliexpress.com/item/33023279793.html" rel="nofollow">Aliexpress</a></td>
        </tr>
        <tr>
            <td>20T 6mm Smooth Idler (5mm bore)</td>
            <td>10</td>
            <td></td>
            <td></td>
            <td><a href="https://www.Aliexpress.com/item/33023133633.html" rel="nofollow">Aliexpress</a></td>
        </tr>
        <tr>
            <td>20T 6mm Tooth Idler (5mm bore)</td>
            <td>2</td>
            <td></td>
            <td></td>
            <td><a href="https://www.Aliexpress.com/item/33023133633.html" rel="nofollow">Aliexpress</a></td>
        </tr>
        <tr>
            <td>20T 9mm Tooth idler (5mm bore)</td>
            <td>3</td>
            <td></td>
            <td></td>
            <td><a href="https://www.Aliexpress.com/item/33023133633.html" rel="nofollow">Aliexpress</a></td>
        </tr>
        <tr>
            <td>Close loop 188-2GT-6 RF belt</td>
            <td>3</td>
            <td></td>
            <td></td>
            <td><a href="https://www.Aliexpress.com/item/4000397043382.html" rel="nofollow">Aliexpress</a></td>
        </tr>
        <tr>
            <td>2GT 6mm belt</td>
            <td>~4m</td>
            <td>XY Gantry</td>
            <td></td>
            <td><a href="https://www.Aliexpress.com/item/32952396111.html" rel="nofollow">Aliexpress</a></td>
        </tr>
        <tr>
            <td>2GT 9mm belt</td>
            <td>~3m</td>
            <td>Belted Z</td>
            <td></td>
            <td><a href="https://www.Aliexpress.com/item/32952396111.html" rel="nofollow">Aliexpress</a></td>
        </tr>
        <tr>
            <td>MR115ZZ</td>
            <td>14</td>
            <td></td>
            <td></td>
            <td><a href="https://www.Aliexpress.com/item/32499551293.html" rel="nofollow">Aliexpress</a></td>
        </tr>
        <tr>
            <td>6mm x 16mm length shaft/dowel pin</td>
            <td>6</td>
            <td>Cut linear shafts, dowel pins or some good m3 spacers(outer dia 6mm) will also work.</td>
            <td><a href="https://s.click.aliexpress.com/e/_99m43S" rel="nofollow">Aliexpress</a></td>
            <td><a href="https://www.aliexpress.com/item/1005003326358562.html" rel="nofollow">Aliexpress</a></td>
        </tr>
        <tr>
            <td>Hook spring 0.5x4x20mm</td>
            <td>6</td>
            <td>Bed coupling</td>
            <td></td>
            <td><a href="https://www.Aliexpress.com/item/1005001491389608.html" rel="nofollow">Aliexpress</a></td>
        </tr>
        <tr>
            <td>Diameter 5mm x 65mm length shaft or dowel pin</td>
            <td>3</td>
            <td>Bed Coupling</td>
            <td></td>
            <td><a href="https://www.Aliexpress.com/item/1005003150582428.html" rel="nofollow">Aliexpress</a></td>
        </tr>
        <tr>
            <td>10mm M4 threaded ball</td>
            <td>3</td>
            <td>Ride on M5 dowels to ensure bed coupling</td>
            <td></td>
            <td><a href="https://www.Aliexpress.com/item/4001141631405.html" rel="nofollow">Aliexpress</a></td>
        </tr>
    </tbody>
</table>

# 4. Electronics

<table>
    <thead>
        <tr>
            <th>Item</th>
            <th>Quantity</th>
            <th>Description</th>
            <th>default link/affiliate link</th>
            <th>non-affiliate link</th>
        </tr>
    </thead>
    <tbody>
        <tr>
            <td>A/B stepper</td>
            <td>2</td>
            <td>MT-1704HSM168RE/E3D High Torque Motor (Body length: 48mm, shaft length:27mm). Other motor will work but the shaft might not long enough to reach the support bearing inside motor mounter</td>
            <td><a href="https://e3d-online.com/products/motors" rel="nofollow">E3D</a></td>
            <td></td>
        </tr>
        <tr>
            <td>Z stepper</td>
            <td>3</td>
            <td>MT-1703HSM168RE/E3D Compact But Powerful Motor (Body length: 40mm, shaft length:27mm). Other 40mm motor will work but the shaft might not long enough to reach the support bearing inside motor mounter</td>
            <td><a href="https://e3d-online.com/products/motors" rel="nofollow">E3D</a></td>
            <td></td>
        </tr>
        <tr>
            <td>Limit switch</td>
            <td>2</td>
            <td>You can choose pretty much any D2F switch from <a href="https://omronfs.omron.com/en_US/ecb/products/pdf/en-d2f.pdf" rel="nofollow">omron's catalog</a>, the best would be "Hinge lever" or "Simulated roller lever (R1.3)", for example: Omron D2F-L3-D3 or D2F-L-D3</td>
            <td><a href="https://www.digikey.com/en/products/detail/omron-electronics-inc-emc-div/D2F-L3-D3/6071977" rel="nofollow">Digikey</a></td>
            <td></td>
        </tr>
        <tr>
            <td>24V 200W PSU</td>
            <td>1</td>
            <td>Mean well LRS-200-24</td>
            <td><a href="https://www.digikey.com/en/products/detail/mean-well-usa-inc/LRS-200-24/7705026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" rel="nofollow">Digikey</a></td>
            <td></td>
        </tr>
        <tr>
            <td>SSR</td>
            <td>1</td>
            <td>for mains powered heatbed, Omron G3NA-210B-DC5</td>
            <td><a href="https://www.grainger.com/product/OMRON-Solid-State-Relay-56LU49" rel="nofollow">Grainger</a> or <a href="https://www.digikey.com/en/products/detail/omron-automation-and-safety/G3NA-210B-UTU-DC5-24/634443?" rel="nofollow">Digikey</a> * Or any other SSR with the same dimension</td>
            <td></td>
        </tr>
        <tr>
            <td>5V PSU</td>
            <td>1</td>
            <td>Mean Well RS-25-5</td>
            <td><a href="https://www.digikey.com/en/products/detail/mean-well-usa-inc/RS-25-5/7706180" rel="nofollow">Digikey</a></td>
            <td></td>
        </tr>
        <tr>
            <td>Controller</td>
            <td>1</td>
            <td>Any board with 6 or more stepper driver (also check MCU for firmware compatibility)</td>
            <td><a href="https://s.click.aliexpress.com/e/_ArubHw" rel="nofollow">Fysetc Spider V1.1</a> OR <a href="https://s.click.aliexpress.com/e/_AKo4pI" rel="nofollow">BTT Octopus V1.1</a> OR <a href="https://s.click.aliexpress.com/e/_9heBrW" rel="nofollow">Mellow Super 8</a>(There are some reports of very slow respond endstop pin on the older version of the Super8 board. Check the vendor and make sure you buy the board with those problems fixed.) OR <a href="https://s.click.aliexpress.com/e/_AM3a6Y" rel="nofollow">BTT SKR Pro 1.2</a></td>
            <td><a href="https://www.aliexpress.com/item/1005002324070189.html" rel="nofollow">Fysetc Spider V1.1</a> OR <a href="https://www.aliexpress.com/item/1005002738104608.html" rel="nofollow">BTT Octopus V1.1</a> OR <a href="https://www.aliexpress.com/item/1005003235684044.html" rel="nofollow">Mellow Super 8</a>(There are some reports of very slow respond endstop pin on the older version of the Super8 board. Check the vendor and make sure you buy the board with those problems fixed.) OR <a href="https://www.aliexpress.com/item/33057570654.html" rel="nofollow">BTT SKR Pro 1.2</a></td>
        </tr>
        <tr>
            <td>Stepper Motor Drivers</td>
            <td>6</td>
            <td>You can usually get them bundled with your board. If not, we recommend TMC2209s</td>
            <td></td>
            <td></td>
        </tr>
        <tr>
            <td>Raspberry Pi</td>
            <td>1</td>
            <td>If you are planning on running Klipper you will need one of these.</td>
            <td><a href="https://www.digikey.com/en/products/detail/raspberry-pi/Raspberry-Pi-4B-4GB/10258781" rel="nofollow">Digikey</a></td>
            <td></td>
        </tr>
        <tr>
            <td>200x200mm silicon heater pad</td>
            <td>1</td>
            <td></td>
            <td><a href="https://kb-3d.com/store/electronics/469-keenovo-silicone-heater-snakeoilxy-250mm-500w-110v-1642734498464.html" rel="nofollow">Keenovo custom size heater by kb-3d.com</a></td>
            <td><a href="https://keenovo.store/collections/standard-keenovo-silicone-heaters/products/keenovo-square-silicone-heater-3d-printer-build-plate-heatbed-heating-pad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" rel="nofollow">Keenovo</a></td>
        </tr>
        <tr>
            <td>Thermal Fuse</td>
            <td>1</td>
            <td>Get 125-130 deg C Fuse</td>
            <td></td>
            <td>Get 125-130 deg C Fuse <a href="https://www.aliexpress.com/item/32885492280.html" rel="nofollow">Aliexpress</a></td>
        </tr>
        <tr>
            <td>92mmx25mm Under bed fan</td>
            <td>1</td>
            <td>This fan does not need to be strong. Go with the slowest, most quiet fan you can get.</td>
            <td><a href="https://www.digikey.com/en/products/detail/sunon-fans/PF92251V3-1000U-F99/7927804" rel="nofollow">Digikey</a></td>
            <td></td>
        </tr>
        <tr>
            <td>Extruder</td>
            <td>1</td>
            <td>Check <a href="/SnakeOilXY/SnakeOil-XY/blob/master/Doc/Manual/eva2.md">EVA2 compatible</a>, we recommend using sherpa mini, it's possible to buy a kit with all the parts that you would need</td>
            <td><a href="https://www.aliexpress.com/item/1005002192629947.html?spm=a2g0o.cart.0.0.3f603c00KRzQK3&mp=1">Aliexpress</a></td>
            <td></td>
        </tr>
        <tr>
            <td>Hot End (Supported)</td>
            <td>1</td>
            <td></td>
            <td><a href="https://s.click.aliexpress.com/e/_Asn7xW" rel="nofollow">Dragon</a> OR <a href="https://www.sliceengineering.com/products/the-mosquito-hotend" rel="nofollow">Mosquitto</a> OR <a href="https://www.sliceengineering.com/products/copperhead-hotends" rel="nofollow">Copperhead</a> OR Mellow NF crazy</td>
            <td><a href="https://www.aliexpress.com/item/1005002629698126.html" rel="nofollow">Dragon</a> OR <a href="https://www.sliceengineering.com/products/the-mosquito-hotend" rel="nofollow">Mosquitto</a> OR <a href="https://www.sliceengineering.com/products/copperhead-hotends" rel="nofollow">Copperhead</a></td>
        </tr>
        <tr>
            <td>Heater Cartridge</td>
            <td>1</td>
            <td></td>
            <td>50W 24V <a href="https://s.click.aliexpress.com/e/_9Gv96G" rel="nofollow">Aliexpress</a> or 60W 24V <a href="https://s.click.aliexpress.com/e/_ADiKwC" rel="nofollow">Aliexpress</a></td>
            <td>50W 24V <a href="https://www.aliexpress.com/item/32960167491.html" rel="nofollow">Aliexpress</a> or 60W 24V <a href="https://www.aliexpress.com/item/4000974620358.html" rel="nofollow">Aliexpress</a></td>
        </tr>
        <tr>
            <td>Thermistor</td>
            <td>1</td>
            <td></td>
            <td>PT100 for under 280C <a href="https://s.click.aliexpress.com/e/_991uvQ" rel="nofollow">Aliexpress</a> T-D500 for high temp <a href="https://s.click.aliexpress.com/e/_9h0o5W" rel="nofollow">Aliexpress</a></td>
            <td>PT100 for under 280C <a href="https://www.aliexpress.com/item/33029709571.html" rel="nofollow">Aliexpress</a> T-D500 for high temp <a href="https://www.aliexpress.com/item/4000907614466.html" rel="nofollow">Aliexpress</a></td>
        </tr>
        <tr>
            <td>WAGO</td>
            <td>3x10pcs</td>
            <td>Buy some 221 series wagos, some of each sizes - 2, 3 and 5 conductors</td>
            <td></td>
            <td></td>
        </tr>
        <tr>
            <td>22AWG Wires</td>
            <td>50m</td>
            <td></td>
            <td></td>
            <td></td>
        </tr>
        <tr>
            <td>18AWG Wires</td>
            <td>3m</td>
            <td>for Heater Cartridge in hotend</td>
            <td></td>
            <td></td>
        </tr>
        <tr>
            <td>16AWG Wires</td>
            <td>10m</td>
            <td>for mains voltage -> power supplies, power supplies -> board IN, board bed -> heatbed</td>
            <td></td>
            <td></td>
        </tr>
        <tr>
            <td>HTU21D sensor</td>
            <td>1</td>
            <td>*Optional</td>
            <td></td>
            <td><a href="https://www.Aliexpress.com/item/32585920923.html" rel="nofollow">Aliexpress</a></td>
        </tr>
        <tr>
            <td>Camera</td>
            <td>1</td>
            <td>*Optional</td>
            <td></td>
            <td><a href="https://www.Aliexpress.com/item/4000929363815.html" rel="nofollow">Aliexpress</a></td>
        </tr>
        <tr>
            <td>Neopixel WS2812B</td>
            <td>0.5m</td>
            <td>*Optional</td>
            <td></td>
            <td><a href="https://www.Aliexpress.com/item/2036819167.html" rel="nofollow">Aliexpress</a></td>
        </tr>
        <tr>
            <td>Neopixel tray</td>
            <td>0.5m</td>
            <td>*Optional</td>
            <td><a href="https://s.click.aliexpress.com/e/_DkBqBCR" rel="nofollow">Aliexpress</a></td>
            <td><a href="https://www.aliexpress.com/item/32879628265.html" rel="nofollow">Aliexpress</a></td>
        </tr>
        <tr>
            <td>*Sonoff mini (wifi version)</td>
            <td>1</td>
            <td>*Optional. This can be use to control the printer power via Fluidd or Mainsail UI(Custom firmware required)</td>
            <td><a href="https://s.click.aliexpress.com/e/_9uzxay" rel="nofollow">Aliexpress</a></td>
            <td><a href="https://www.aliexpress.com/item/4000060915796.html" rel="nofollow">Aliexpress</a></td>
        </tr>
        <tr>
            <td>Mini 128x64 LCD</td>
            <td>1</td>
            <td>*Optional. Might require some simple modification to fit in to the retro LCD mount</td>
            <td><a href="https://s.click.aliexpress.com/e/_9fsIok" rel="nofollow">Aliexpress</a></td>
            <td><a href="https://www.aliexpress.com/item/1005001729369638.html" rel="nofollow">Aliexpress</a></td>
        </tr>
        <tr>
            <td>BLtouch or clone</td>
            <td>1</td>
            <td>Default option for bed probe</td>
            <td><a href="https://s.click.aliexpress.com/e/_9AlXQ9" rel="nofollow">Aliexpress</a></td>
            <td>-</td>
        </tr>
        <tr>
            <td>Panasonic GX-H8B</td>
            <td>1</td>
            <td>Other option for bed probe. Very good accuracy and low temp drift</td>
            <td>-</td>
            <td><a href="https://www.digikey.com/en/products/detail/panasonic-industrial-automation-sales/GX-H8B/3899483" rel="nofollow">Digikey</a></td>
        </tr>
        <tr>
            <td>Cherry MX switch or clone</td>
            <td>4</td>
            <td>*Optional. For button panel</td>
            <td><a href="https://s.click.aliexpress.com/e/_9vqP7A" rel="nofollow">Aliexpress</a></td>
            <td><a href="https://www.aliexpress.com/item/1005001681627152.html" rel="nofollow">Aliexpress</a></td>
        </tr>
    </tbody>
</table>

# 5.Panels

<table>
    <thead>
        <tr>
            <th>Item</th>
            <th>Quantity</th>
            <th>Description</th>
            <th>default link/affiliate link</th>
            <th>non-affiliate link(not affiliated)</th>
        </tr>
    </thead>
    <tbody>
        <tr>
            <td>Front-panel 430x504x3mm</td>
            <td>1</td>
            <td></td>
            <td></td>
            <td></td>
        </tr>
        <tr>
            <td>Side-panel 374x504x3mm</td>
            <td>2</td>
            <td></td>
            <td></td>
            <td></td>
        </tr>
        <tr>
            <td>Rear-top-panel 394x179x3mm</td>
            <td>1</td>
            <td></td>
            <td></td>
            <td></td>
        </tr>
        <tr>
            <td>Rear-bottom-panel 379x294x3mm</td>
            <td>1</td>
            <td></td>
            <td></td>
            <td></td>
        </tr>
        <tr>
            <td>Top-panel 394x374x3mm</td>
            <td>1</td>
            <td></td>
            <td></td>
            <td></td>
        </tr>
    </tbody>
</table>

# 6.Other

<table>
    <thead>
        <tr>
            <th>Item</th>
            <th>Quantity</th>
            <th>Description</th>
            <th>default link/affiliate link</th>
            <th>non-affiliate link(</th>
        </tr>
    </thead>
    <tbody>
        <tr>
            <td>Prusa MK3 spring steel PEI sheet</td>
            <td>1</td>
            <td></td>
            <td></td>
            <td></td>
        </tr>
        <tr>
            <td>Prusa MK3 magnet sheet</td>
            <td>1</td>
            <td></td>
            <td></td>
            <td></td>
        </tr>
        <tr>
            <td>254x242 aluminum plate</td>
            <td>1</td>
            <td>6mm thick (Tooling plate is recommended for its flatness)</td>
            <td></td>
            <td></td>
        </tr>
        <tr>
            <td>DIN rail 332mm</td>
            <td>2</td>
            <td></td>
            <td></td>
            <td></td>
        </tr>
        <tr>
            <td>DIN rail 379mm</td>
            <td>2</td>
            <td></td>
            <td></td>
            <td></td>
        </tr>
        <tr>
            <td>6x3mmm round(disk) magnet</td>
            <td>8</td>
            <td></td>
            <td><a href="https://s.click.aliexpress.com/e/_9wFag8" rel="nofollow">Aliexpress</a></td>
            <td><a href="https://www.aliexpress.com/item/1005001614044682.html" rel="nofollow">Aliexpress</a></td>
        </tr>
        <tr>
            <td>19x5x1.5mm Block magnet</td>
            <td>3</td>
            <td>Smaller magnet also works</td>
            <td><a href="https://www.Aliexpress.com/item/4000955510987.html" rel="nofollow">Aliexpress</a></td>
            <td><a href="https://www.Aliexpress.com/item/4000955510987.html" rel="nofollow">Aliexpress</a></td>
        </tr>
        <tr>
            <td>Spacer for bed plate mount</td>
            <td>3</td>
            <td>You can use yellow springs or silicone spacers, you just need to cut them to a length of about 10mm</td>
            <td><a href="https://www.Aliexpress.com/item/1005001391148294.html" rel="nofollow">Aliexpress</a></td>
            <td><a href="https://www.Aliexpress.com/item/1005001391148294.html" rel="nofollow">Aliexpress</a></td>
        </tr>
        <tr>
            <td>Foam tape 5mmx1mm</td>
            <td>7m</td>
            <td></td>
            <td></td>
            <td></td>
        </tr>
        <tr>
            <td>F623 bearing</td>
            <td>4</td>
            <td>For spool holder</td>
            <td><a href="https://s.click.aliexpress.com/e/_9wTkxi" rel="nofollow">Aliexpress</a></td>
            <td></td>
        </tr>
        <tr>
            <td>E3D 1.75mm collet</td>
            <td>2</td>
            <td>For sherpa mini and filament guide arm</td>
            <td><a href="https://e3d-online.com/products/embedded-bowden-collet-for-metal-1-75mm?_pos=2&amp;_sid=bda6a9f42&amp;_ss=r" rel="nofollow">E3D online</a></td>
            <td></td>
        </tr>
    </tbody>
</table>

# 7.Alternative bed coupling options

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

# 8.Z counter weight

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
