wandrewkeech/SnakeOil-XY/Doc/logo/SnakeOilXY_Full_Logo2.dxf

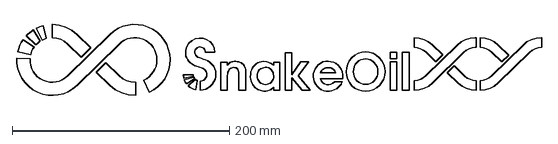
[picture p16: CAD file, 2022-03-22]
Doc/logo/SnakeOilXY_Full_Logo2.dxf
483.8 x 70.5 mm
