wandrewkeech/SnakeOil-XY/WIP/component-assembly/toolhead-sherpa-pcb-1515-assembly.FCStd

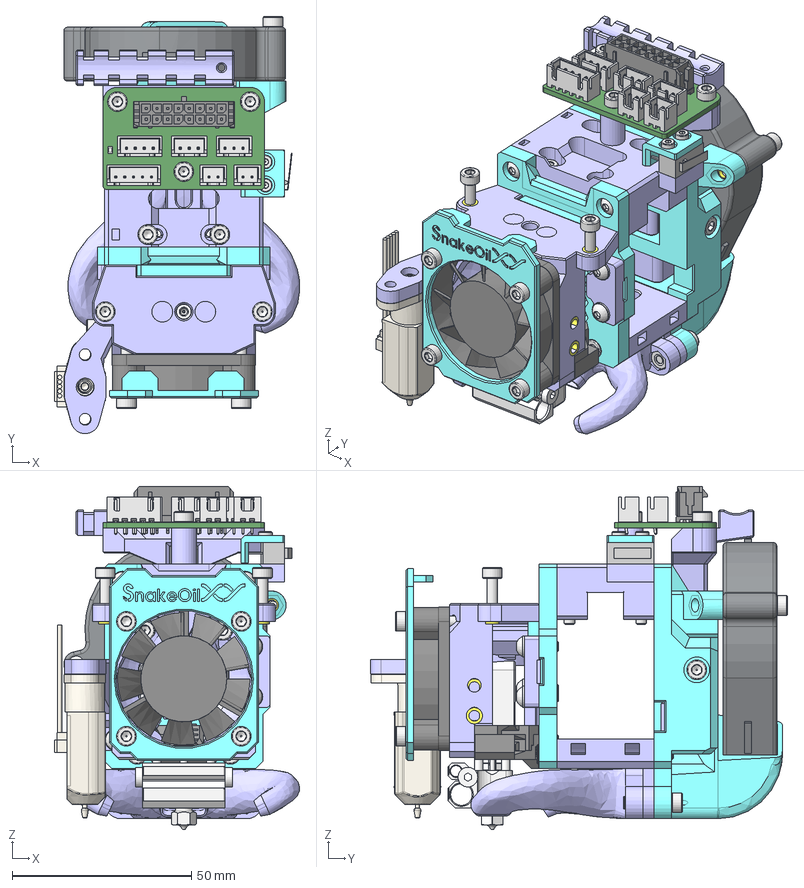
[picture p17: CAD file, 2023-05-15]
WIP/component-assembly/toolhead-sherpa-pcb-1515-assembly.FCStd
68.4 x 116.3 x 95.6 mm
mosquito-hotend
mosquito_support
5015 fan
4010-fan
BL-touch v3.x002
M3x10-Screw189
M3-Nut027
M3-Nut030
M3-Nut009
M3x40-Screw001
M3x40-Screw
M3-Nut026
M3x35-Screw003
M3x35-Screw004
M3x20-Screw
M3x12-Screw
M3x10-Screw186
M3x10-Screw
M3x12-Screw066
M3x10-Screw187
M3x10-Screw188
M3x10-Screw199
M2.5x12-Screw
M2.5x12-Screw001
M3x25-Screw030
M3x25-Screw
M3x20-Screw024
M3x25-Screw029
M3x25-Screw004
M3x20-Screw023
M3x35-Screw
M3x35-Screw005
dragon_support
face-plate
dragon-mount-mod
mosquito-mount-mod
extruder-belt-tesioner
extruder-belt-tesioner001
endstop-switch
endstop-cap
M2x10-Screw
M2x10-Screw001
M3x4-HeatSet
M3x4-HeatSet001
M3x4-HeatSet003
M3x4-HeatSet004
M3x4-HeatSet009
M3x4-HeatSet010
M3x4-HeatSet012
M3x4-HeatSet013
M3x4-HeatSet017
M3x4-HeatSet018
duct-tri-horn
M3-Nut032
M3-Nut033
M3x12-Screw074
M3x12-Screw075
M3-HeatSet
M3x4-HeatSet019
bltouch-mount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
