wandrewkeech/SnakeOil-XY/WIP/component-assembly/top-lid-assembly.FCStd

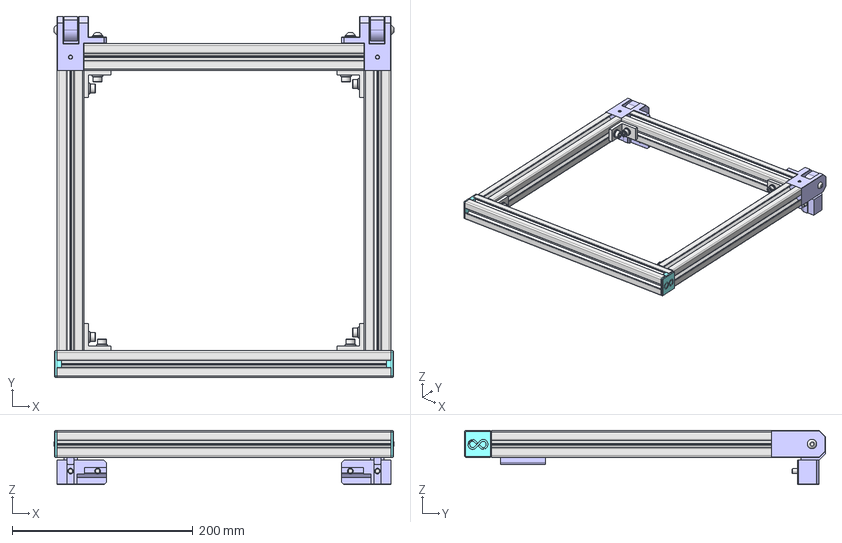
[picture p18: CAD file, 2023-05-15]
WIP/component-assembly/top-lid-assembly.FCStd
376.6 x 400.0 x 60.0 mm
3030-370mm-top-lid-001
3030-310mm-top-lid-001
3030-310mm-top-lid-002
3030-310mm-top-lid-003
M6-Washer005
M6x12-Screw113
M6x20-Screw001
lid-left-bottom-hinge
M8x30-Screw001
M6-Washer001
M6x14-Screw
M6-Nut
M6x10-Screw120
lid-left-top-hinge
M8x30-Screw
M6-Washer156
M6x14-Screw001
M6-Nut001
M6x10-Screw001
lid-right-top-hinge
M6-Washer004
M6x12-Screw112
M6x20-Screw
lid-right-bottom-hinge
M6-Washer011
M6-Washer010
M6x14-Screw009
M6x14-Screw010
L-corner-bracket028
M6x14-Screw011
M6-Washer012
M6-Washer013
M6x14-Screw012
L-corner-bracket029
M6-Washer006
M6-Washer157
M6x14-Screw013
M6x14-Screw014
L-corner-bracket030
M6-Washer159
M6-Washer158
M6x14-Screw015
M6x14-Screw016
L-corner-bracket010
lid-end-cap001
lid-end-cap002
