wandrewkeech/SnakeOil-XY/WIP/component-assembly/4PR-assembly.FCStd

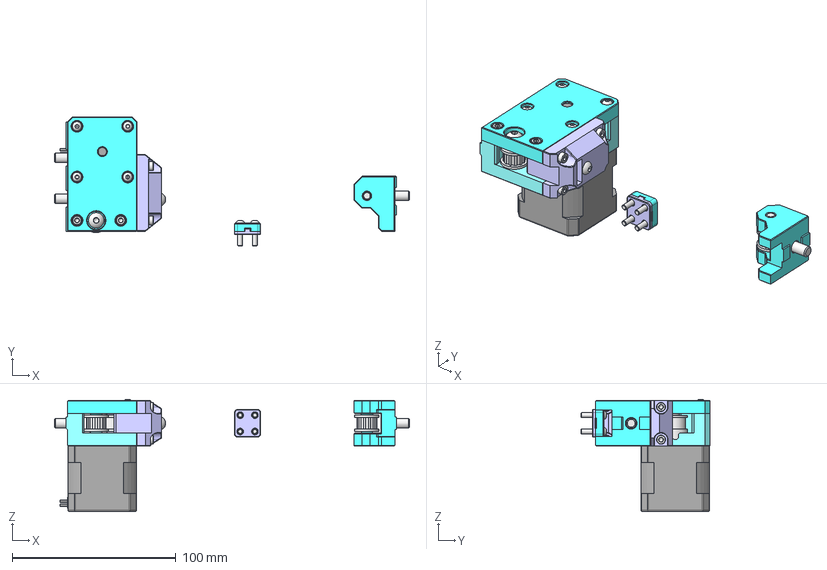
[picture p19: CAD file, 2023-05-15]
WIP/component-assembly/4PR-assembly.FCStd
217.0 x 79.0 x 68.7 mm
motor
20t-pulley-6mm
MR115ZZ
smooth-idler-6mm
tooth-idler-6mm
c-motor-mount-inner-plate
c-idler-housing
c-tesioner-cap-nut
M3-HeatSet
M3-HeatSet001
M3-HeatSet002
M3-HeatSet003
M3-HeatSet004
M3-HeatSet005
M3x25-Screw
M3x25-Screw001
M3x30-Screw
M3x30-Screw007
M3x30-Screw008
M3x30-Screw009
M6x14-Screw001
M6x14-Screw002
M5x25-Screw001
M3x10-Screw
M3x10-Screw004
M3x10-Screw005
M3x10-Screw006
M4x20-Screw
M4-HeatSet
M5x20-ThreadedRod
M4-Nut
c-motor-mount-outer-plate
c-motor-shaft-spacer
c-belt-mounter-top
c-belt-mounter-bottom
M3x14-Screw
M3x14-Screw001
M3x14-Screw002
M3x14-Screw003
c-idler-mount
tooth-idler-6mm001
M5x25-Screw
M6x14-Screw
