wandrewkeech/SnakeOil-XY/WIP/component-assembly/side-blower-4028-assembly.FCStd

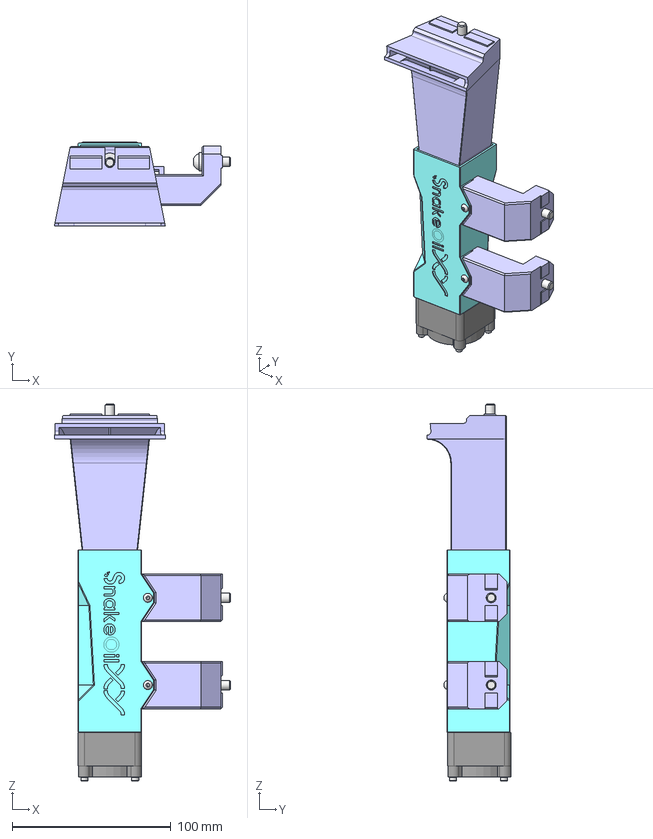
[picture p20: CAD file, 2023-02-25]
WIP/component-assembly/side-blower-4028-assembly.FCStd
111.2 x 53.0 x 237.7 mm
180-duct-angled
fan-mounter
mounter-arm
mounter-arm001
M3-HeatSet
M3-HeatSet001
M2.5-HeatSet
M2.5-HeatSet001
M2.5-HeatSet002
M2.5-HeatSet003
M6-Washer
M6-Washer001
M6x20-Screw
M6x20-Screw001
M6-Washer002
M6x16-Screw
M3x20-Screw
M3x20-Screw001
M2.5x30-Screw
M2.5x30-Screw001
M2.5x30-Screw002
M2.5x30-Screw003
4028-fan
