wandrewkeech/SnakeOil-XY/WIP/component-assembly/silicon-arm-assembly-tmp.FCStd

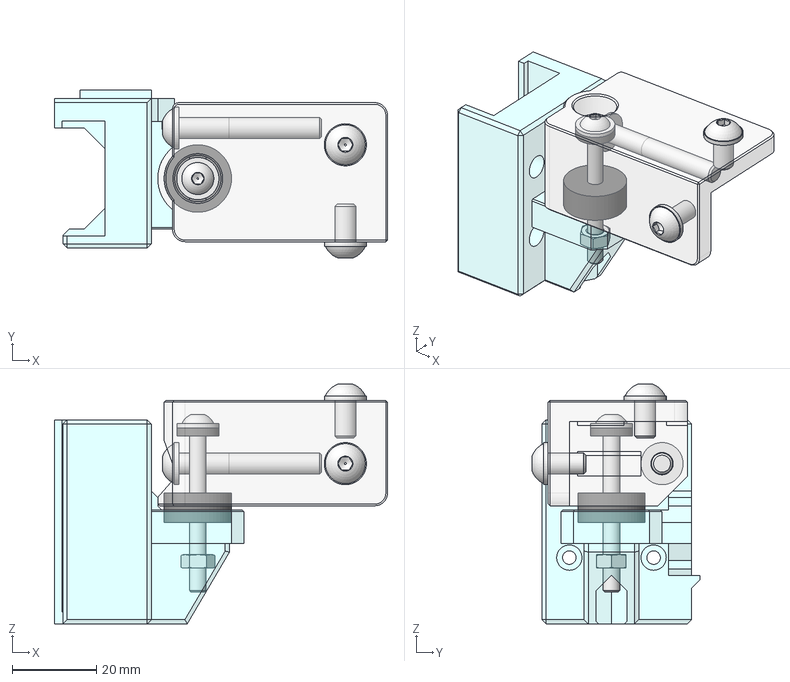
[picture p21: CAD file, 2023-02-25]
WIP/component-assembly/silicon-arm-assembly-tmp.FCStd
79.0 x 39.9 x 56.9 mm
rail-arm-fdm002
silicon-spacer-9mm-height001
M4-Nut001
silicon-spacer-10x4x003
m4x10x1-washer001
M4x40-Screw001
M5-Washer
M5x10-Screw
M5-Washer003
M5-Washer004
M5x10-Screw001
M5x35-Screw
