wandrewkeech/SnakeOil-XY/WIP/testing/4056-mackerel-compressor-assembly.FCStd

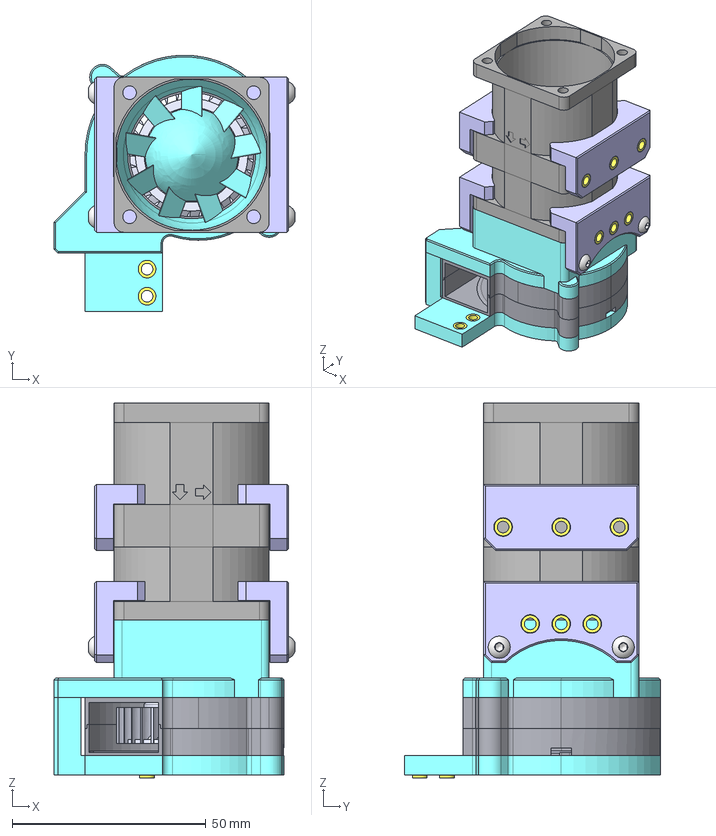
[picture p22: CAD file, 2021-12-27]
WIP/testing/4056-mackerel-compressor-assembly.FCStd
62.2 x 66.2 x 96.7 mm
fan-clamp001
fan-clamp
compressor-back-plate
turbine
top
bottom
bottom001
M3-HeatSet
M3-HeatSet001
M3-HeatSet002
M3-HeatSet003
M3-HeatSet004
M3-HeatSet005
M3-HeatSet006
M3-HeatSet007
M3-HeatSet008
M3-HeatSet009
M3-HeatSet010
M3-HeatSet011
M3x8-Screw
M3x8-Screw001
M3x8-Screw002
M3x8-Screw003
GDSTIME-top-plate
delta-4056-GFM0412SS
top-clamp
top-clamp001
M3-HeatSet012
M3-HeatSet013
M3-HeatSet014
M3-HeatSet015
M3-HeatSet016
M3-HeatSet017
