wandrewkeech/SnakeOil-XY/WIP/component-assembly/right-panel-assembly.FCStd

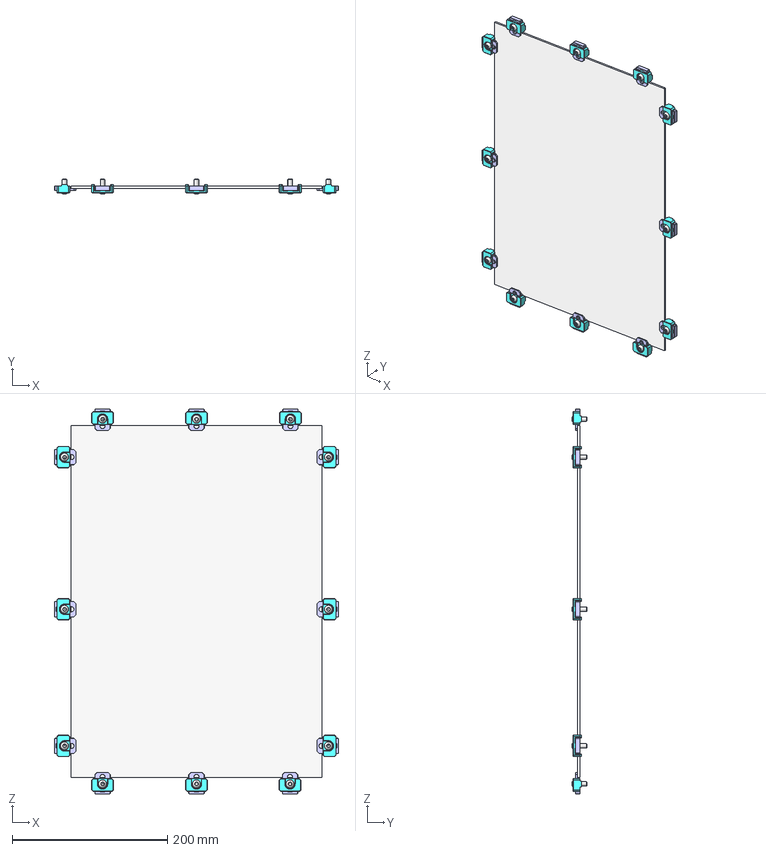
[picture p23: CAD file, 2023-02-25]
WIP/component-assembly/right-panel-assembly.FCStd
366.0 x 19.3 x 496.0 mm
panel-324x454x3mm
mounter-inner
mounter-outer011
M6x16-Screw007
mounter-inner001
mounter-outer010
M6x16-Screw001
mounter-inner002
mounter-outer009
M6x16-Screw002
mounter-inner003
mounter-outer008
M6x16-Screw003
mounter-inner004
mounter-outer007
M6x16-Screw008
mounter-inner005
mounter-outer006
M6x16-Screw009
mounter-inner006
mounter-outer005
M6x16-Screw010
mounter-inner007
mounter-outer004
M6x16-Screw011
mounter-inner008
mounter-outer003
M6x16-Screw012
mounter-inner009
mounter-outer002
M6x16-Screw013
mounter-inner010
mounter-outer001
M6x16-Screw014
mounter-inner011
mounter-outer
M6x16-Screw015
