wandrewkeech/SnakeOil-XY/BETA3_Standard_Release_STL/STLs/Panels/Back-panel/Bottom/OPTIONAL_1x_raspberry-full-size-din-mounter.stl

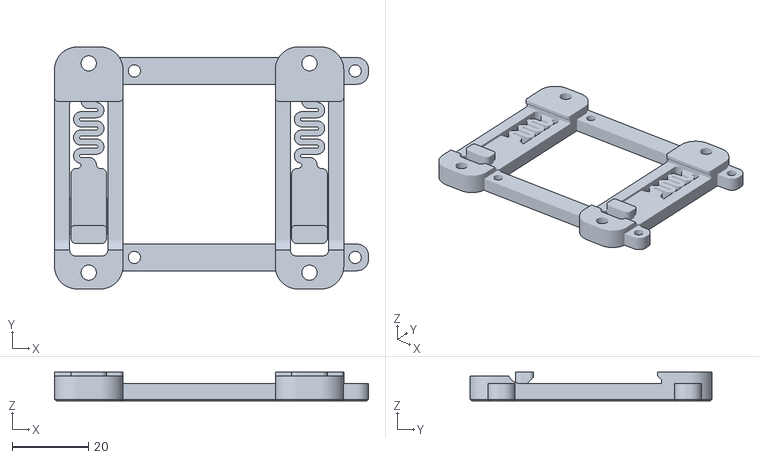
[picture p24: CAD file, 2023-02-25]
BETA3_Standard_Release_STL/STLs/Panels/Back-panel/Bottom/OPTIONAL_1x_raspberry-full-size-din-mounter.stl
82.5 x 63.6 x 7.60
