wandrewkeech/SnakeOil-XY/WIP/component-assembly/z-block-mount-left-assembly.FCStd

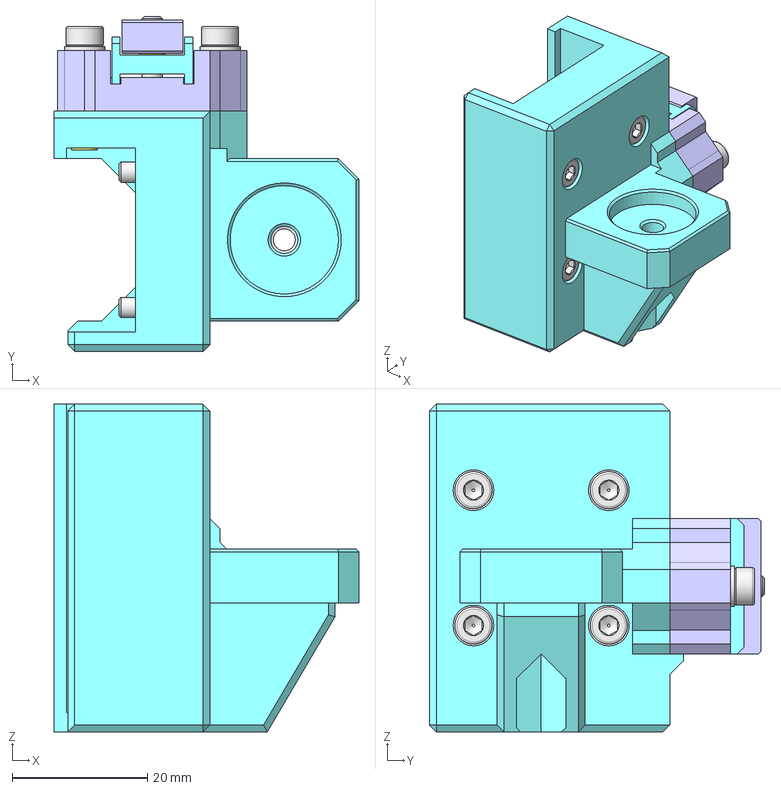
[picture p25: CAD file, 2023-02-25]
WIP/component-assembly/z-block-mount-left-assembly.FCStd
45.0 x 49.5 x 48.4 mm
z-belt-mounter-clamp-nut
z-belt-block-mount
z-belt-mounter-middle
M3-Washer
M3-Washer008
M3-Washer009
M3-Washer010
M3x10-Screw003
M3x10-Screw004
M3x10-Screw005
M3x10-Screw
M3x4-HeatSet
M3x4-HeatSet001
M3x4-HeatSet002
M3-Washer006
M3-Washer007
M3x14-Screw
M3x14-Screw001
M3x12-Screw
z-rail-block-mount-left
M3x25-Screw
M3x25-Screw001
M4-Nut
