wandrewkeech/SnakeOil-XY/WIP/component-assembly/front-panel-assembly.FCStd

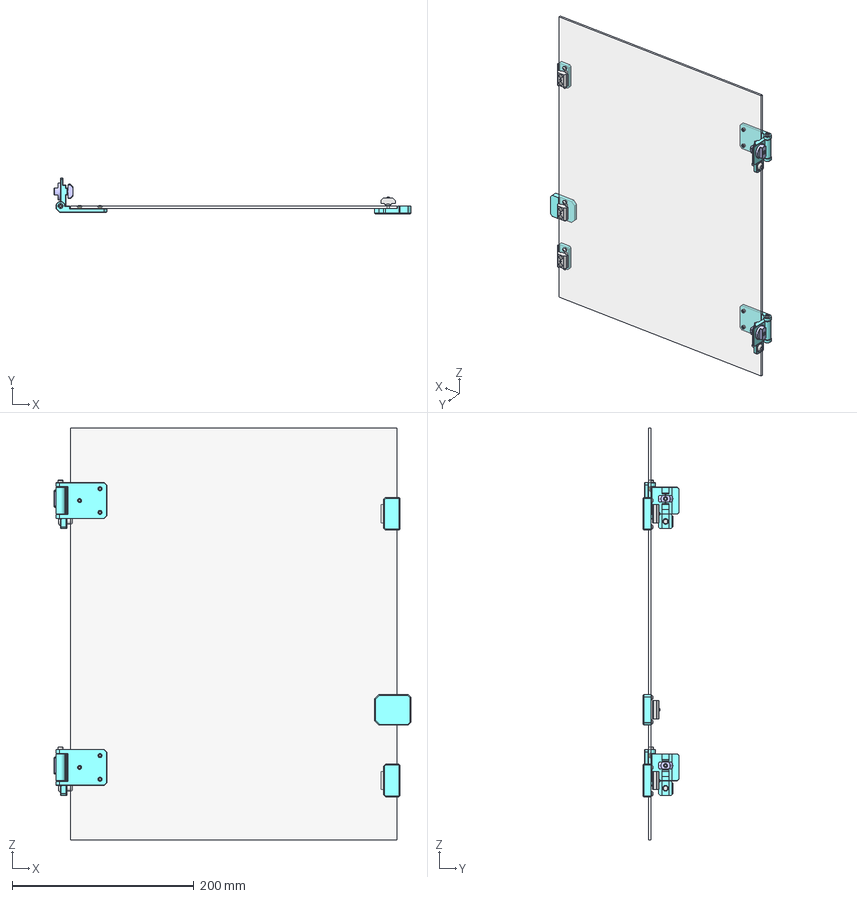
[picture p26: CAD file, 2023-02-25]
WIP/component-assembly/front-panel-assembly.FCStd
393.0 x 40.0 x 454.0 mm
frame-magnet-mount002
frame-magnet-mount
frame-magnet-mount001
door-magnet-mount-large
door-magnet-mount-small
door-magnet-mount-small001
M3-Washer022
M3-Washer
M3-Washer030
M3-Washer029
M3-Washer031
M3-Washer032
M3x6-Screw
M3x6-Screw026
M3x6-Screw035
M3x6-Screw036
M3x6-Screw034
M3x6-Screw033
M3x3-HeatSet003
M3x3-HeatSet004
M3x3-HeatSet005
M3x3-HeatSet006
M3x3-HeatSet007
M3x3-HeatSet008
6x3-magnet
6x3-magnet001
6x3-magnet002
6x3-magnet003
6x3-magnet004
6x3-magnet005
19x5x1p5m-magnet
19x5x1p5m-magnet001
19x5x1p5m-magnet002
M3x8-Screw044
M3x8-Screw
M3x8-Screw045
panel-360x454x3mm
side-hinge001
M3x16-Screw001
knob001
M6x12-Screw001
M3x6-Screw024
M3x6-Screw023
M3x6-Screw025
M3x40-Screw001
front-hinge001
nut
hinge-support
M3x4-HeatSet002
M3x4-HeatSet003
M3x4-HeatSet004
M3x4-HeatSet005
M3x4-HeatSet006
side-hinge
M3x16-Screw
knob
M6x12-Screw
M3x6-Screw004
M3x6-Screw003
M3x6-Screw022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
