wandrewkeech/SnakeOil-XY/WIP/component-assembly/y-carrier-right-2020-assembly.FCStd

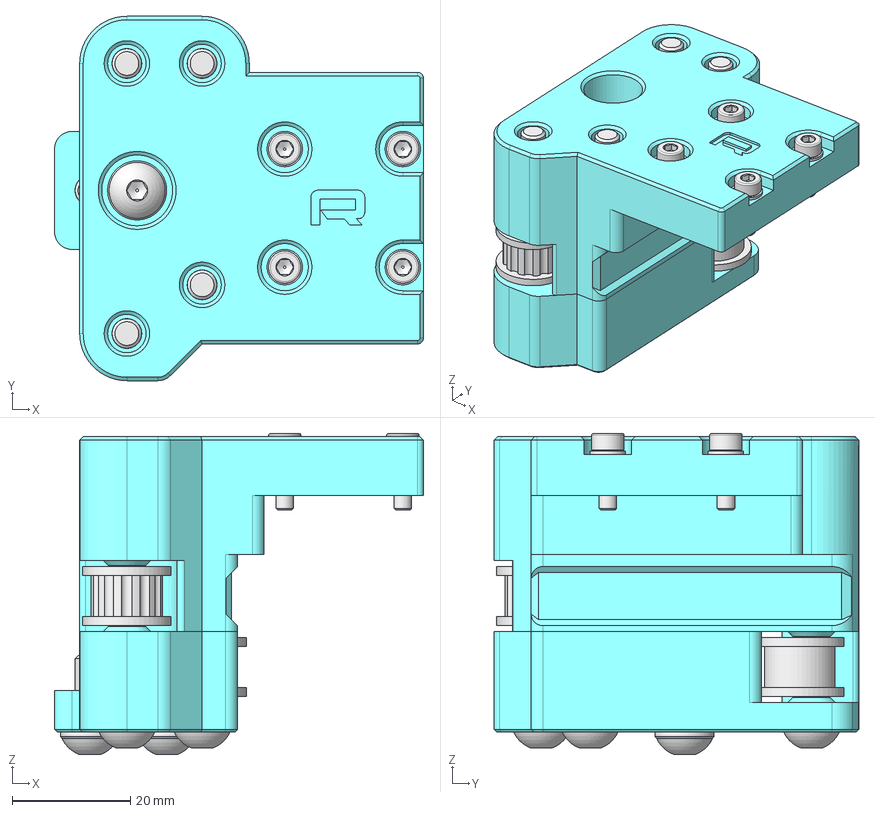
[picture p27: CAD file, 2023-02-25]
WIP/component-assembly/y-carrier-right-2020-assembly.FCStd
62.5 x 61.7 x 54.4 mm
20t-idler
smooth-idler
M5-Washer001
M5x14-Screw
M5x12-Screw
M5-Washer
M5x50-Screw001
M5x50-Screw002
M5x50-Screw003
M5x50-Screw
M3x10-Screw
M3x10-Screw003
M3x10-Screw002
M3x10-Screw001
M3-Washer006
M3-Washer005
M3-Washer004
M3-Washer
M5x16-Screw
M5-Washer002
