wandrewkeech/SnakeOil-XY/WIP/component-assembly/z-block-mount-right-counter-weight-assembly.FCStd

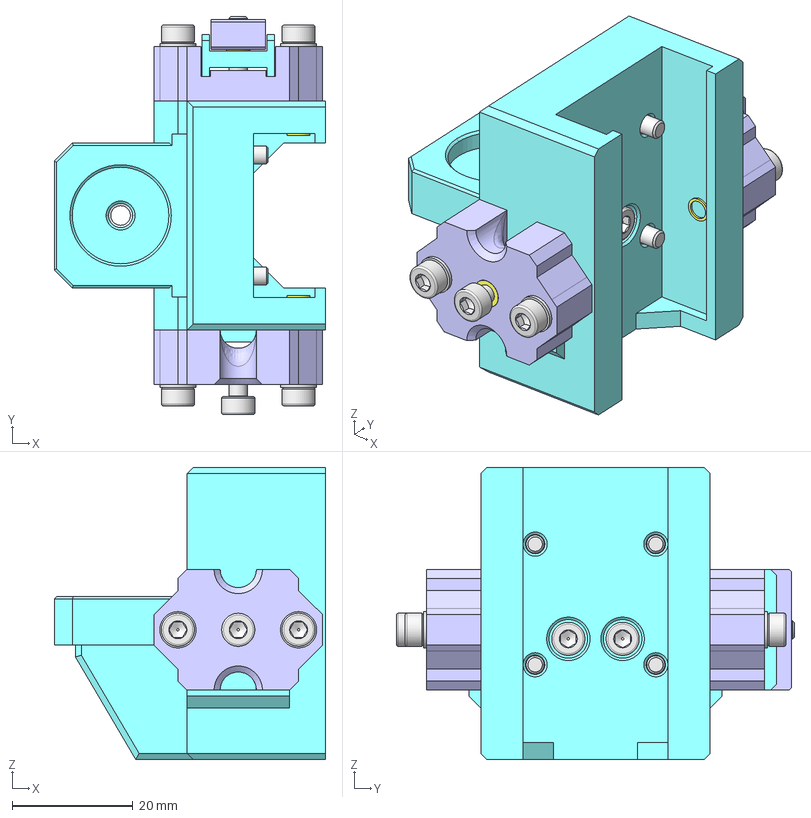
[picture p28: CAD file, 2023-02-25]
WIP/component-assembly/z-block-mount-right-counter-weight-assembly.FCStd
45.0 x 66.0 x 48.4 mm
z-belt-mounter-clamp-nut001
z-belt-mounter-middle001
z-belt-block-mount001
M3-Washer
M3-Washer020
M3-Washer021
M3-Washer022
M3x10-Screw
M3x10-Screw004
M3x10-Screw005
M3x10-Screw006
M3x4-HeatSet006
M3x4-HeatSet007
M3x4-HeatSet010
M3x12-Screw001
M3-Washer018
M3-Washer019
M3x14-Screw002
M3x14-Screw003
M3x4-HeatSet
M3x4-HeatSet001
wire-mounter002
M3-Washer025
M3-Washer026
M3x14-Screw
M3x14-Screw004
M3-HeatSet
M3x8-Screw
z-rail-block-mount-right-counter-weight
M3x25-Screw
M3x25-Screw001
M4-Nut
