wandrewkeech/SnakeOil-XY/WIP/component-assembly/x-endstop-flag-assembly.FCStd

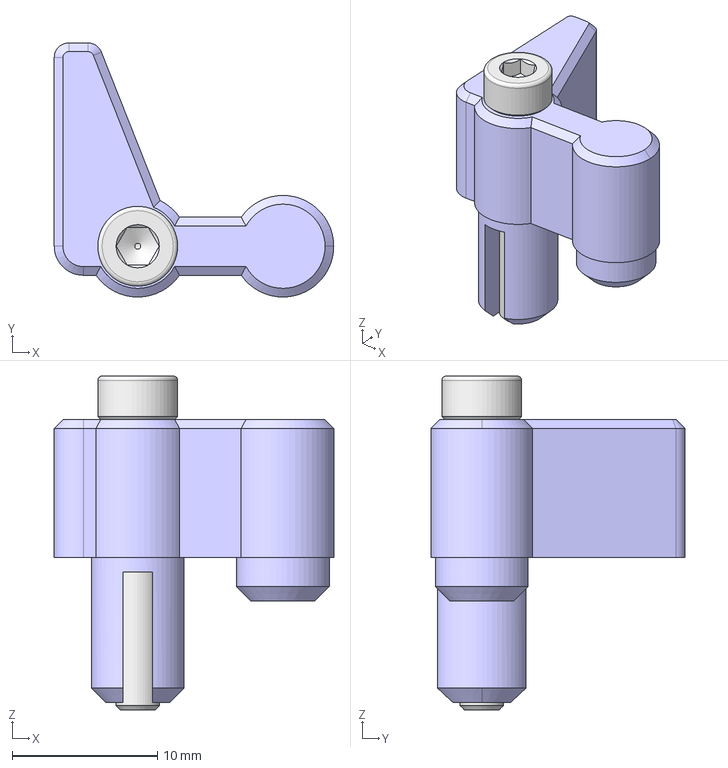
[picture p29: CAD file, 2023-02-25]
WIP/component-assembly/x-endstop-flag-assembly.FCStd
19.2 x 17.5 x 23.0 mm
1x_x-endstop-flag-1515
M3x20-Screw
