wandrewkeech/SnakeOil-XY/WIP/component-assembly/bed-assembly.FCStd

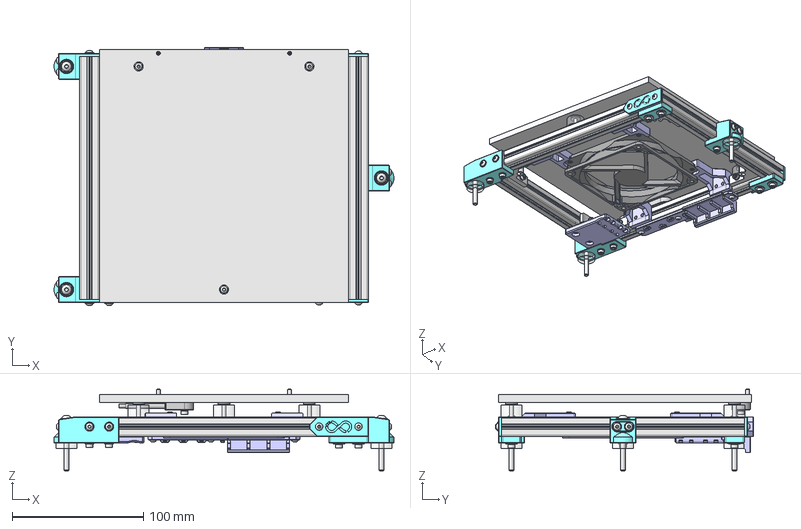
[picture p30: CAD file, 2023-02-25]
WIP/component-assembly/bed-assembly.FCStd
259.0 x 196.7 x 62.1 mm
front-left-arm
O-ring-10ODx4IDx2H001
silicon-spacer-16ODx4UDx9H001
M3-Washer
M3-Washer038
M3x10-Screw021
M3x10-Screw
M3-Washer044
M3-Washer045
M3x8-Screw004
M3x8-Screw005
M4-OD10-Washer-001
M4x40-Screw
M3-Washer052
M3-Washer053
M3x20-Screw
M3x20-Screw001
back-left-arm
silicon-spacer-16ODx4UDx9H002
O-ring-10ODx4IDx2H002
M3-Washer042
M3-Washer043
M3x10-Screw023
M3x10-Screw022
M3-Washer048
M3-Washer049
M3x8-Screw007
M3x8-Screw006
M4-OD10-Washer
M4x40-Screw001
M3-Washer055
M3-Washer054
M3x20-Screw003
M3x20-Screw002
middle-right-arm
silicon-spacer-16ODx4UDx9H003
O-ring-10ODx4IDx2H003
M3-Washer041
M3x10-Screw024
M4-OD10-Washer001
M4x40-Screw002
M3-Washer057
M3-Washer058
M3x20-Screw004
M3x20-Screw005
1515-185mm001
1515-190mm001
1515-185mm003
1515-190mm003
HBLTBS008
HBLTBS007
HBLTBS010
HBLTBS009
extrusion-connector
extrusion-connector001
M3-Washer018
M3-Washer019
M3-Washer022
M3-Washer021
M3-Washer023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
