wandrewkeech/SnakeOil-XY/WIP/component-assembly/ab-x-motor-assembly.FCStd

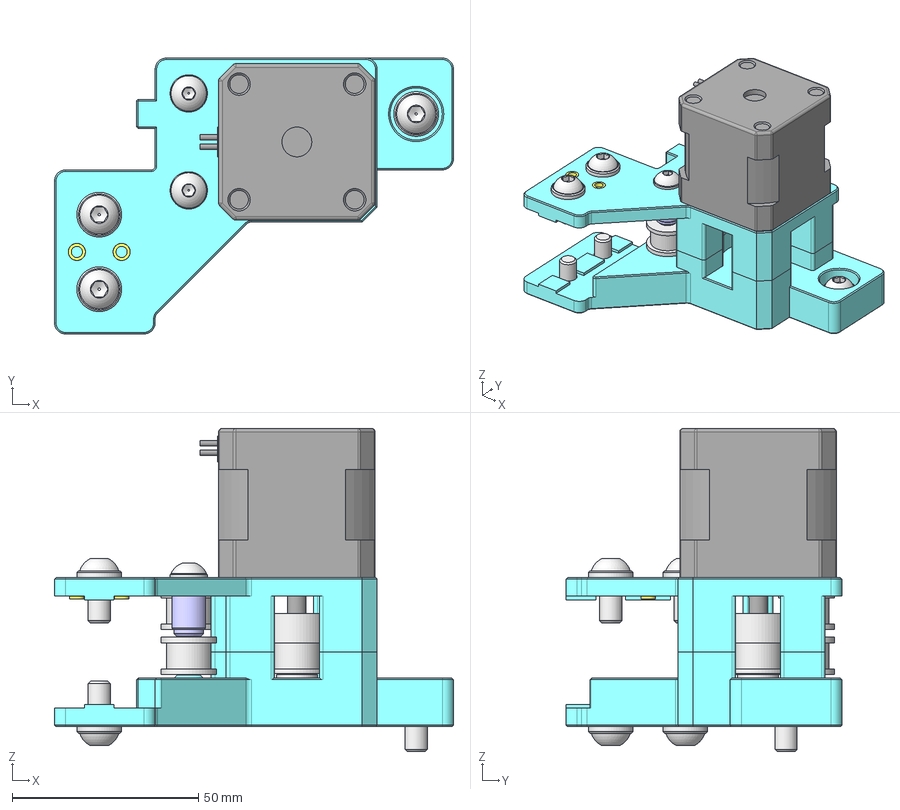
[picture p31: CAD file, 2023-02-25]
WIP/component-assembly/ab-x-motor-assembly.FCStd
107.0 x 74.0 x 86.7 mm
ab-motor-idler-spacer
smooth-idler-6mm
smooth-idler-6mm006
smooth-idler-6mm004
motor-40mm
20t-pulley001
MR115ZZ
motor-mount-stack-idler-spacer
M3x40-Screw006
M6-Washer010
M6-Washer
M6-Washer008
M6-Washer007
M6-Washer009
M6x14-Screw003
M6x14-Screw002
M6x14-Screw001
M6x14-Screw
M6x16-Screw
M3x40-Screw008
M3x40-Screw007
M3x40-Screw
M5-Nut001
M5-Nut
M3x4-HeatSet
M3x4-HeatSet001
M3x4-HeatSet002
M3x4-HeatSet003
M5-Washer
M5-Washer001
M5x40-Screw
M5x40-Screw001
ab-motor-top-left
ab-motor-bottom-left
