wandrewkeech/SnakeOil-XY/WIP/component-assembly/top-panel-assembly.FCStd

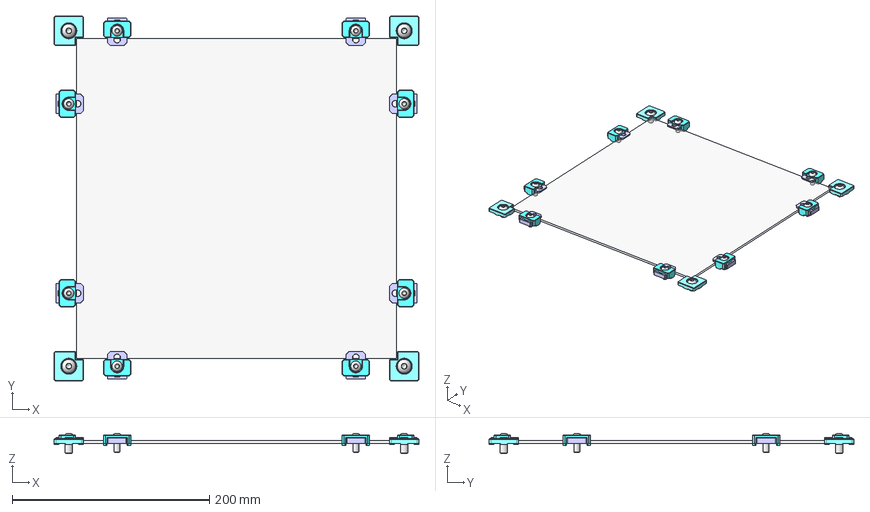
[picture p32: CAD file, 2023-02-25]
WIP/component-assembly/top-panel-assembly.FCStd
370.0 x 370.0 x 20.3 mm
panel-324x234x3mm
mounter-inner028
mounter-outer021
M6x16-Screw033
mounter-inner027
mounter-outer022
M6x16-Screw028
mounter-inner026
mounter-outer023
M6x16-Screw034
mounter-inner025
mounter-outer024
M6x16-Screw027
mounter-inner024
mounter-outer025
M6x16-Screw029
mounter-inner023
mounter-outer026
M6x16-Screw031
mounter-inner022
mounter-outer027
M6x16-Screw030
mounter-inner021
mounter-outer028
M6x16-Screw032
corner-endcap
M8x12-Screw
corner-endcap001
M8x12-Screw001
corner-endcap002
M8x12-Screw002
corner-endcap003
M8x12-Screw003
