wandrewkeech/SnakeOil-XY/WIP/component-assembly/counter-weight-spring-box-assembly.FCStd

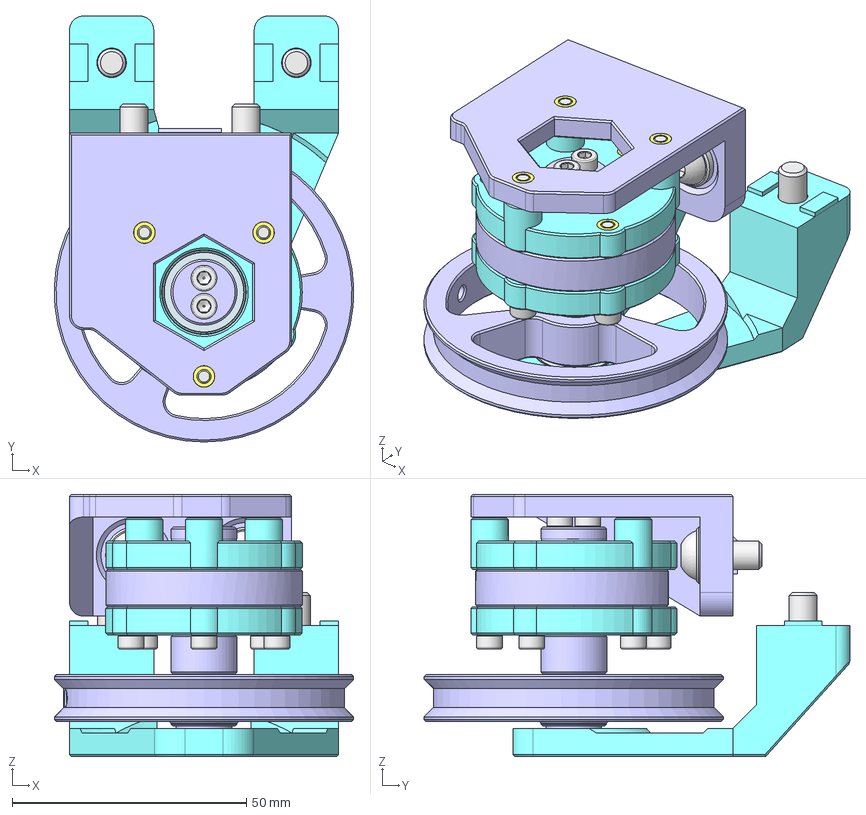
[picture p33: CAD file, 2023-02-25]
WIP/component-assembly/counter-weight-spring-box-assembly.FCStd
64.0 x 91.0 x 56.0 mm
cw-pulley-r30
bearing-6701ZZ1
cw-mid-plate
cw-axis
cw-front-plate
cw-back-plate
bearing-6701ZZ2
cw-spacer
bearing-6701ZZ
cw-front-mounter
cw-back-mounter
M3x4-HeatSet
M3x4-HeatSet001
M3x4-HeatSet002
M3x4-HeatSet003
M3x4-HeatSet004
M3x4-HeatSet005
M3x4-HeatSet006
M3x4-HeatSet007
M3x20-Screw
M3x20-Screw003
M3x20-Screw004
M3x30-Screw
M3x30-Screw003
M3x30-Screw004
M3x45-Screw
M3x45-Screw001
M6-Washer
M6-Washer001
M6x14-Screw
M6x14-Screw001
M6x14-Screw002
M6x14-Screw003
