wandrewkeech/SnakeOil-XY/WIP/component-assembly/toolhead-pcb-assembly.FCStd

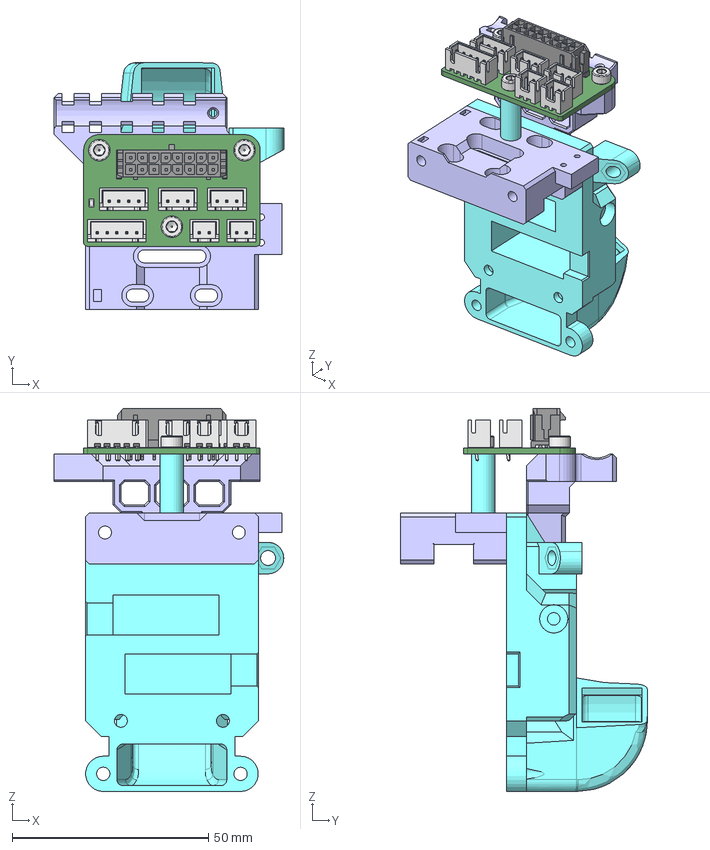
[picture p34: CAD file, 2023-02-25]
WIP/component-assembly/toolhead-pcb-assembly.FCStd
58.5 x 62.9 x 97.6 mm
extruder-back-plate
top-plate-with-endstop
pcb-mounter-cable-guide
pcb-spacer
M3x6-Screw
M3x6-Screw001
M3x20-Screw
M3x12-Screw
