wandrewkeech/SnakeOil-XY/WIP/component-assembly/rear-top-panel-assembly.FCStd

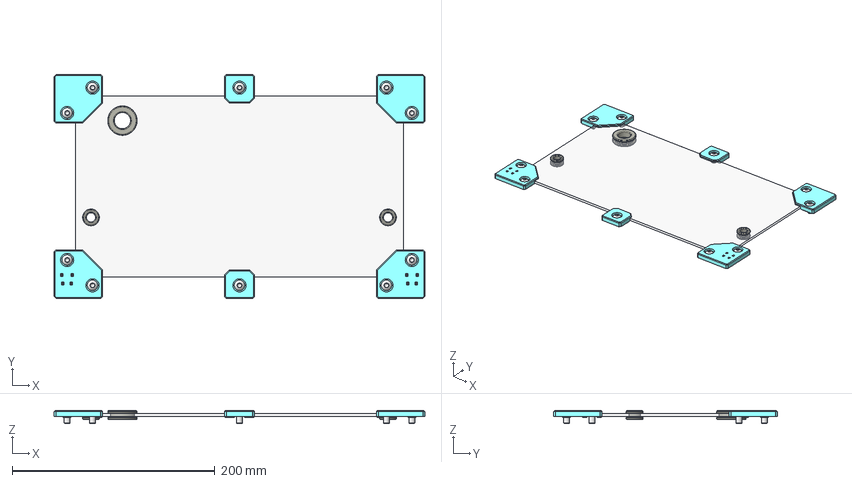
[picture p35: CAD file, 2022-03-22]
WIP/component-assembly/rear-top-panel-assembly.FCStd
366.0 x 221.0 x 13.3 mm
M6x10-Screw023
M6x10-Screw024
M6x10-Screw020
M6x10-Screw021
M6x10-Screw022
M6x10-Screw032
M6x10-Screw031
M6x10-Screw029
M6x10-Screw
M6x10-Screw030
cable-grommet-small001
cable-grommet-small002
cable-grommet-big001
top-corner-mount001
top-corner-mount002
side-mount001
side-mount002
bottom-left-corner-mount
bottom-right-corner-mount
panel-324x179x3mm
