wandrewkeech/SnakeOil-XY/WIP/component-assembly/toolhead-carrier-sherpa-1515-assembly.FCStd

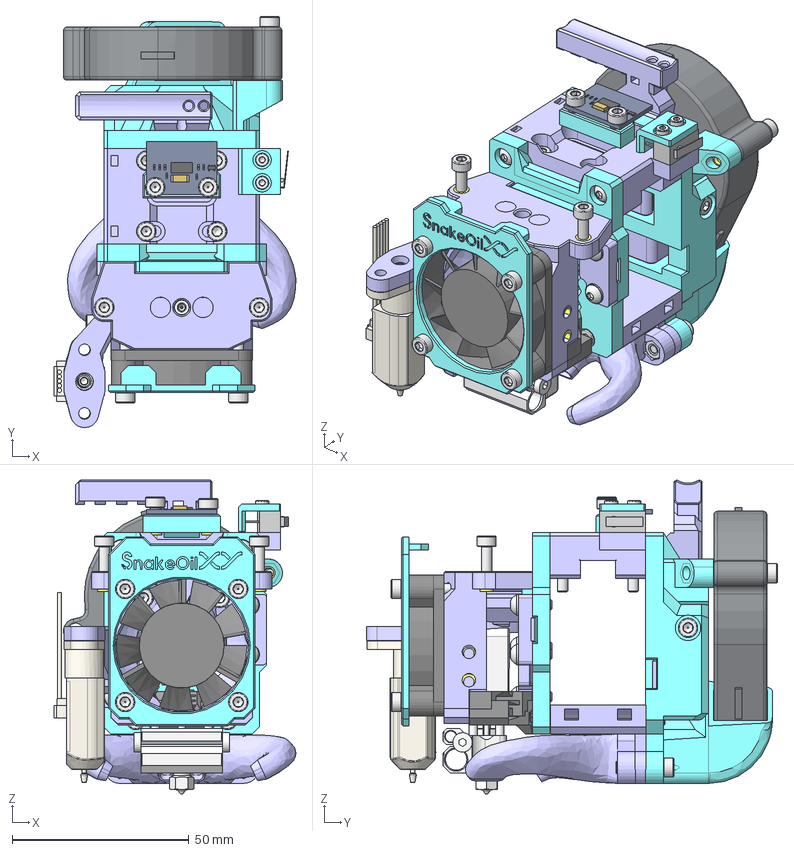
[picture p36: CAD file, 2022-03-22]
WIP/component-assembly/toolhead-carrier-sherpa-1515-assembly.FCStd
68.4 x 116.3 x 88.8 mm
mosquito-hotend
mosquito_support
5015 fan
4010-fan
BL-touch v3.x002
M3x10-Screw189
M3-Nut027
M3-Nut030
M3-Nut009
M3x40-Screw001
M3x40-Screw
M3-Nut026
M3x35-Screw003
M3x35-Screw004
M3x20-Screw
M3x12-Screw
M3x10-Screw186
M3x10-Screw
M3x12-Screw066
M3x10-Screw187
M3x10-Screw188
M3x8-Screw128
M2.5x12-Screw
M2.5x12-Screw001
M3x25-Screw030
M3x25-Screw
M3x20-Screw024
M3x25-Screw029
M3x25-Screw004
M3x20-Screw023
adxl345 v3
adxl345 v004
adxl345 v005
adxl345 v006
adxl345 v007
adxl345 v008
adxl345 v009
adxl345 v010
adxl345 v011
adxl345 v012
adxl345 v013
adxl345 v014
adxl345 v015
adxl345 v016
adxl345 v017
adxl345 v018
adxl345 v019
adxl345 v020
adxl345 v021
adxl345 v022
adxl345 v023
adxl345 v024
adxl345 v025
adxl345 v026
adxl345 v027
adxl345 v028
adxl345 v029
adxl345 v030
adxl345 v031
adxl345 v032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
