wandrewkeech/SnakeOil-XY/WIP/component-assembly/front-right-idler-assembly.FCStd

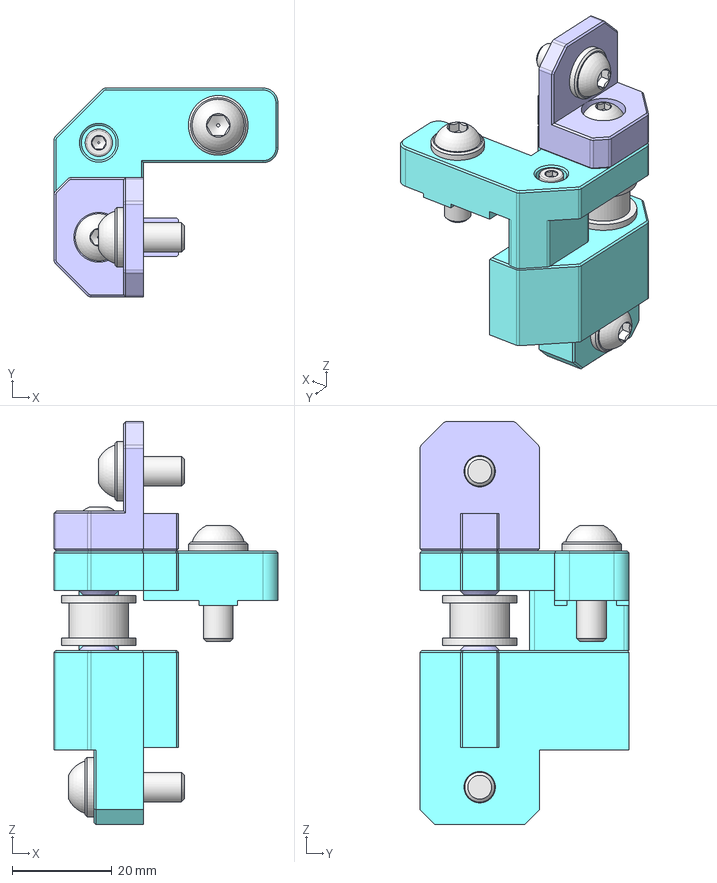
[picture p37: CAD file, 2022-03-22]
WIP/component-assembly/front-right-idler-assembly.FCStd
45.0 x 42.0 x 81.0 mm
smooth-idler-6mm
front-idler-spacer003
front-idler-spacer002
M6-Washer
M6x20-Screw
M3x25-Screw
M6x20-Screw001
M6-Washer009
M5-Washer
M6x14-Screw
M6-Washer010
M3x4-HeatSet001
M5x40-Screw
right-idler-bottom
right-idler-mid
right-idler-top
