wandrewkeech/SnakeOil-XY/WIP/component-assembly/z-idler-right-assembly.FCStd

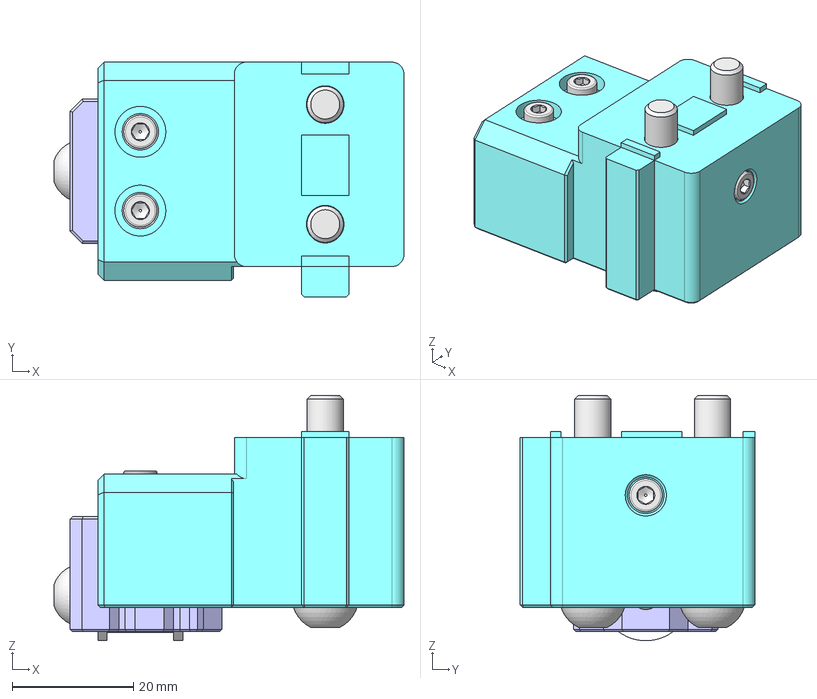
[picture p38: CAD file, 2022-03-22]
WIP/component-assembly/z-idler-right-assembly.FCStd
57.8 x 38.7 x 40.5 mm
20t-9mm-idler
M3x45-Screw001
M6x35-Screw002
M6x35-Screw003
M3x12-Screw
M3x12-Screw006
M3-Washer008
M3-Washer007
M5x25-Screw001
z-idler-housing-right
M3x4-HeatSet002
M3x4-HeatSet003
z-idler-mounter-right
