wandrewkeech/SnakeOil-XY/WIP/component-assembly/z-motor-left-assembly.FCStd

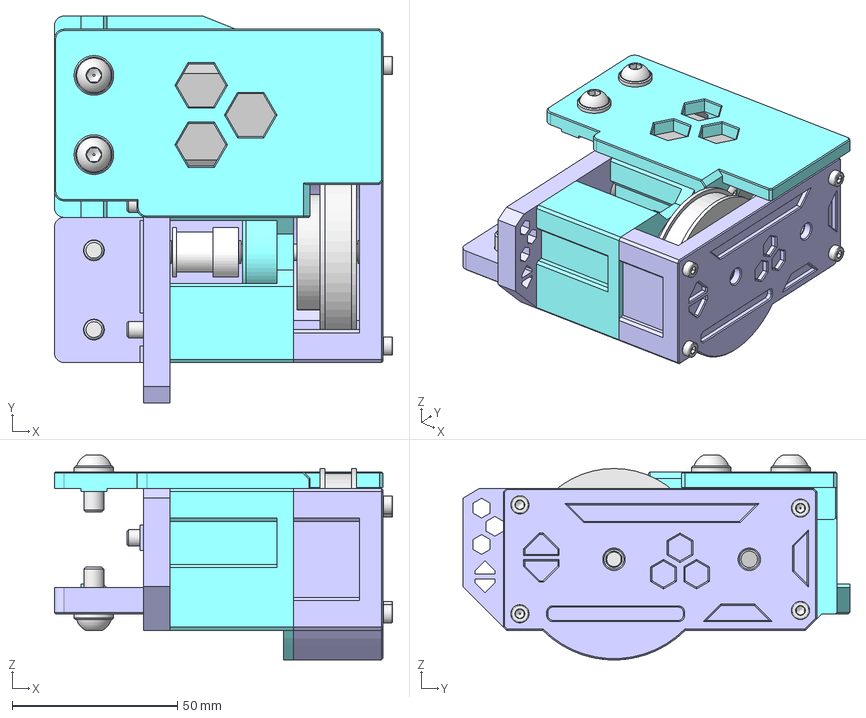
[picture p39: CAD file, 2022-03-22]
WIP/component-assembly/z-motor-left-assembly.FCStd
102.5 x 117.2 x 62.1 mm
motor-spacer
MR115ZZ006
20t-9mm-pulley001
MR115ZZ005
motor-spacer001
MR115ZZ007
motor-40mm001
motor-spacer002
motor-spacer003
16t-pulley001
M3x35-Screw
M3x70-Screw001
M3x35-Screw001
M3x70-Screw
M6-Washer008
M6-Washer009
M6x14-Screw
M6x14-Screw001
M3x12-Screw
M6-Washer006
M6-Washer007
M6x16-Screw
M6x16-Screw001
M3x8-Screw
M6-Washer
M5x10-Screw001
M6-Washer010
M6x16-Screw004
M6x16-Screw005
M5x10-Screw
M3x40-Screw
80t-idler
5x65-shaft
MR115ZZ008
M3x4-HeatSet
M3x4-HeatSet001
M3x4-HeatSet002
M3x3-HeatSet
M3x3-HeatSet001
M3x6-Screw
M3x6-Screw001
z-motor-front-plate-left
bottom-left-cover
z-motor-back-plate-left
z-motor-body-left
z-motor-top-plate-left
