wandrewkeech/SnakeOil-XY/WIP/component-assembly/add-on-ptfe-tube-guide-assembly.FCStd

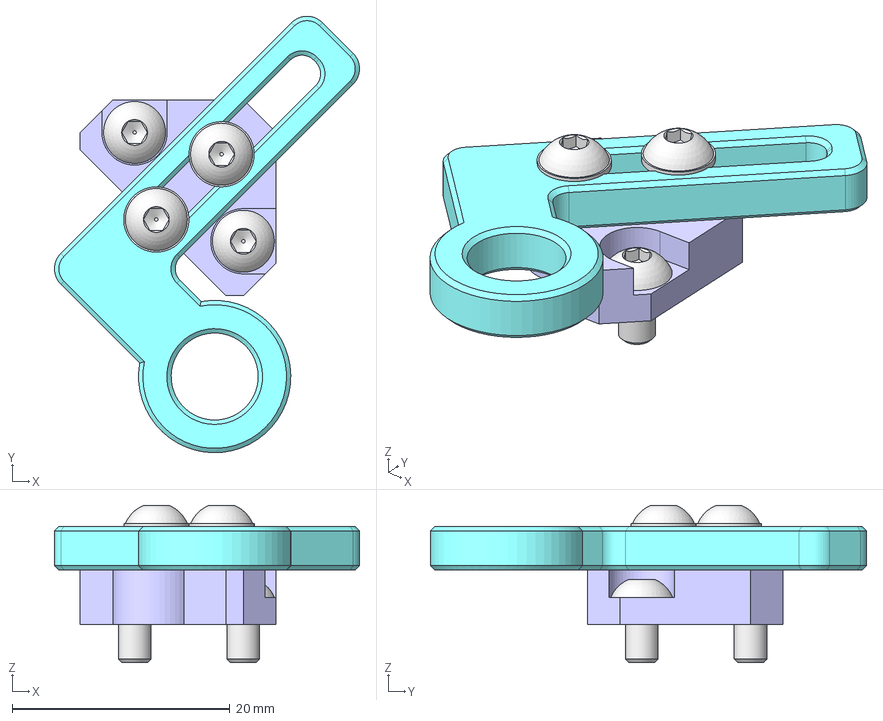
[picture p40: CAD file, 2022-03-22]
WIP/component-assembly/add-on-ptfe-tube-guide-assembly.FCStd
28.0 x 40.1 x 14.4 mm
M3x4-HeatSet
M3x6-Screw
M3x6-Screw001
ptfe-guide-base
M3-Washer
M3x8-Screw
M3-HeatSet
M3-Washer001
M3x8-Screw001
ptfe-guide-arm-angle
