wandrewkeech/SnakeOil-XY/WIP/component-assembly/rear-bottom-panel-assembly.FCStd

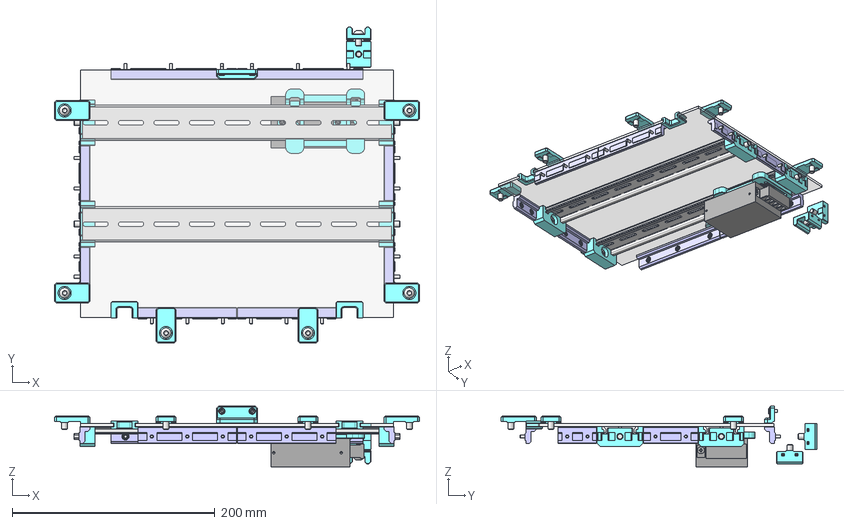
[picture p41: CAD file, 2022-03-22]
WIP/component-assembly/rear-bottom-panel-assembly.FCStd
360.0 x 312.0 x 60.0 mm
panel-support-bottom
cable-hole-cover
cable-hole-cover001
M6x10-Screw
M6x10-Screw011
M6x10-Screw012
M6x10-Screw013
M6x10-Screw014
M6x10-Screw015
M3x6-Screw001
M3x6-Screw
panel-support001
panel-support002
panel-support003
panel-support004
panel-support005
panel-support006
M3x8-Screw
M3x8-Screw058
M3x8-Screw059
M3x8-Screw052
M3x8-Screw053
M3x8-Screw054
M3x8-Screw060
M3x8-Screw061
M3x8-Screw062
M3x8-Screw055
M3x8-Screw056
M3x8-Screw057
M3x8-Screw044
M3x8-Screw045
M3x8-Screw046
M3x8-Screw047
M3x8-Screw038
M3x8-Screw039
M3x8-Screw040
M3x8-Screw032
M3x8-Screw033
M3x8-Screw034
M3x8-Screw041
M3x8-Screw042
M3x8-Screw043
M3x8-Screw035
M3x8-Screw036
M3x8-Screw037
M3x8-Screw048
M3x8-Screw049
M3x8-Screw050
M3x8-Screw051
gasket-side-short002
gasket-side-long002
gasket-bottom002
gasket-top002
gasket-side-short003
gasket-side-long003
gasket-bottom003
gasket-top003
din-309mm
din-309mm001
M6x16-Screw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
