wandrewkeech/SnakeOil-XY/WIP/component-assembly/frame-assembly.FCStd

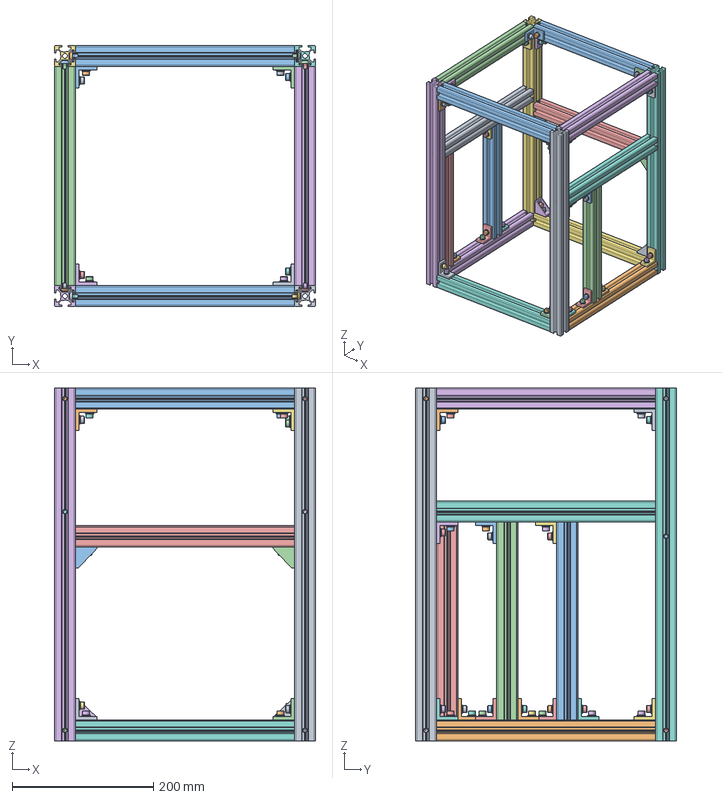
[picture p42: CAD file, 2022-03-22]
WIP/component-assembly/frame-assembly.FCStd
370.0 x 370.0 x 500.0 mm
HCJ_Joint001
HCJ_Joint002
HCJ_Joint003
HCJ_Joint004
HCJ_Joint005
HCJ_Joint006
HCJ_Joint007
HCJ_Joint008
HCJ_Joint009
HCJ_Joint010
HCJ_Joint011
HCJ_Joint012
HCJ_Joint013
HCJ_Joint014
HCJ_Joint015
HCJ_Joint016
HCJ_Joint017
HCJ_Joint018
HCJ_Joint019
HCJ_Joint020
HCJ_Joint021
HCJ_Joint022
M6-Washer119
M6x14-Screw
M6x14-Screw080
L-corner-bracket002
M6-Washer
M6x14-Screw074
M6x14-Screw075
M6-Washer113
L-corner-bracket003
M6-Washer114
M6x14-Screw004
M6x14-Screw005
M6-Washer012
L-corner-bracket004
M6-Washer011
M6x14-Screw006
M6x14-Screw007
M6-Washer014
L-corner-bracket001
M6-Washer013
M6x14-Screw008
M6-Washer028
M6x14-Screw009
L-corner-bracket015
M6-Washer027
M6-Washer030
M6x14-Screw010
M6x14-Screw011
L-corner-bracket016
M6-Washer029
M6x14-Screw012
M6x14-Screw013
M6-Washer032
L-corner-bracket011
M6-Washer031
M6-Washer034
M6x14-Screw014
M6x14-Screw015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
