wandrewkeech/SnakeOil-XY/WIP/component-assembly/neo-pixel-assembly.FCStd

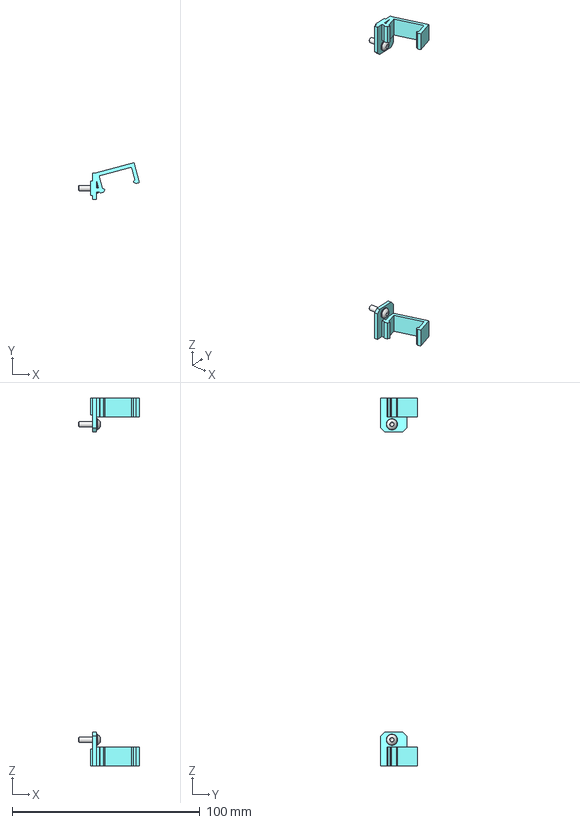
[picture p43: CAD file, 2022-03-22]
WIP/component-assembly/neo-pixel-assembly.FCStd
32.4 x 19.6 x 196.0 mm
M3-Washer
M3-Washer001
M3x10-Screw
M3x10-Screw001
neo-pixel-arm
neo-pixel-arm-rev
