wandrewkeech/SnakeOil-XY/WIP/component-assembly/z-counter-weight-assembly.FCStd

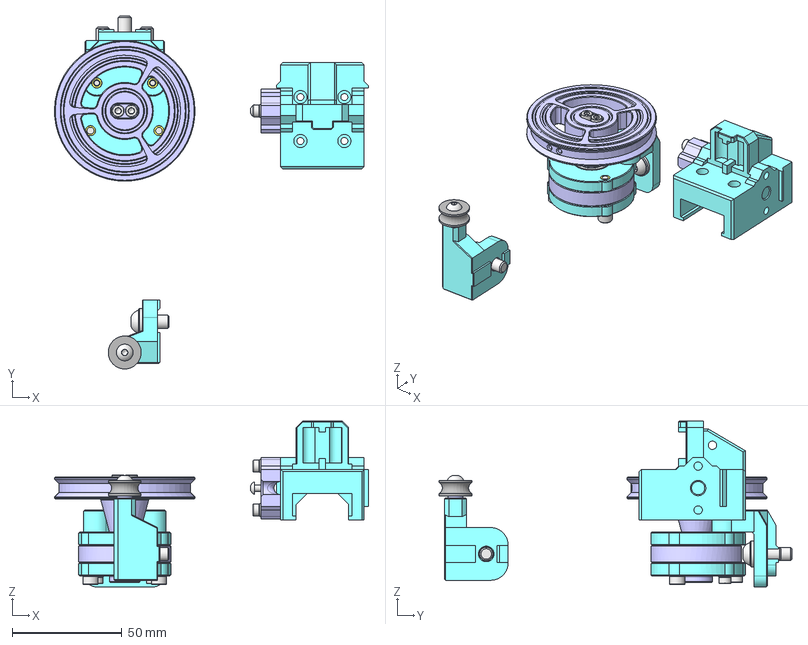
[picture p44: CAD file, 2022-01-15]
WIP/component-assembly/z-counter-weight-assembly.FCStd
143.0 x 160.7 x 75.5 mm
bearing-6701ZZ1
bearing-6701ZZ2
housing-middle
housing-front
housing-back
pylley-25mm
pulley-30mm
250-mounter
180-mounter
axis
M6x14-Screw
M6-Washer002
M3x20-Screw
M4x20-Screw001
M4x20-Screw002
M3-Washer
M3-Washer001
M3x30-Screw
M3x30-Screw001
M3-HeatSet
M3-HeatSet001
M3-HeatSet002
M3-HeatSet003
M3-HeatSet004
M3-HeatSet005
M3-HeatSet006
M3x45-Screw
M3x45-Screw001
M6-Washer
M6-Washer001
M6x14-Screw003
M6x14-Screw004
U624ZZ-bearing
top-bearing-arm
spacer
M6-Washer003
M6x14-Screw005
M4x40-Screw
M4-HeatSet
wire-mounter
M3-Washer004
M3-Washer005
M3x14-Screw
M3x14-Screw001
M3-HeatSet007
M3x6-Screw
z-rail-block-mount-right-with-limiter-dual
