wandrewkeech/SnakeOil-XY/WIP/component-assembly/bottom-panel-assembly.FCStd

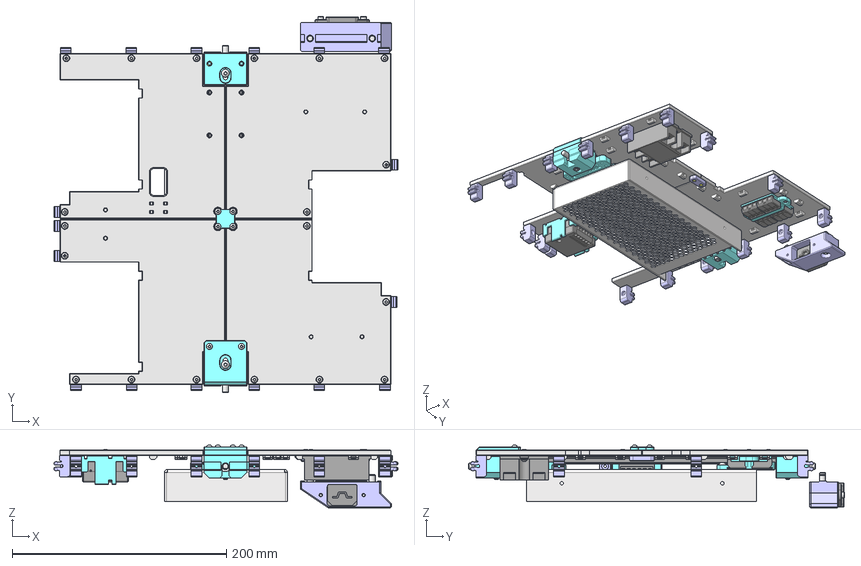
[picture p45: CAD file, 2022-01-15]
WIP/component-assembly/bottom-panel-assembly.FCStd
321.0 x 351.0 x 58.7 mm
center-panel-connector
M3x6-Screw
M3x6-Screw014
M3x6-Screw015
M3x6-Screw016
panel-FR
panel-BR
panel-FL
panel-BL
M3x4-HeatSet
M3x4-HeatSet034
M3x4-HeatSet035
M3x4-HeatSet036
M3x4-HeatSet037
M3x4-HeatSet038
M3x4-HeatSet039
M3x4-HeatSet040
M3x4-HeatSet041
M3x4-HeatSet042
M3x3-HeatSet
M3x3-HeatSet001
M3x3-HeatSet002
M3x3-HeatSet003
M3x3-HeatSet004
M3x3-HeatSet005
panel-side-connector
M3x4-HeatSet043
M3x4-HeatSet001
M3x6-Screw028
M3x6-Screw029
M3x6-Screw030
M3x6-Screw031
M3x6-Screw032
M3x6-Screw033
M3x6-Screw034
M3x6-Screw035
M3x6-Screw036
M3x6-Screw037
M3x6-Screw038
M3x6-Screw039
M3x6-Screw040
M3x6-Screw041
M3x6-Screw042
M3x6-Screw027
M3x6-Screw043
M3x6-Screw044
M3x6-Screw045
front-din-cap
bottom-din-holder
back-din-cap
bottom-din-holder001
din-282mm001
M4-Nut001
M4-Nut
M3x4-HeatSet026
M3x4-HeatSet027
M3x6-Screw019
M3x6-Screw020
M6x12-Screw
M6x12-Screw001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
