wandrewkeech/SnakeOil-XY/WIP/component-assembly/air-filter-assembly.FCStd

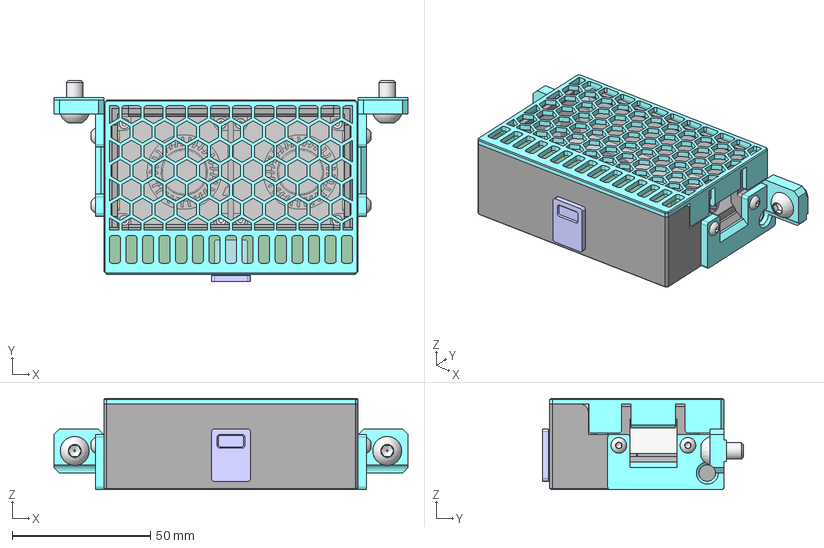
[picture p46: CAD file, 2022-01-15]
WIP/component-assembly/air-filter-assembly.FCStd
128.0 x 72.5 x 33.0 mm
active-carbon-foam
hepa-filter
M3x6-Screw
M6x12-Screw
M3x6-Screw004
air-filter-mounter-left
M6x12-Screw001
M3x6-Screw002
M3x6-Screw003
air-filter-mounter-right
air-filter-front-cover
air-filter-body
air-filter-eject-level
4010-fan001
4010-fan002
M3x3-HeatSet
M3x3-HeatSet001
M3x3-HeatSet002
M3x3-HeatSet003
M2x6-self-tapping-Screw
M2x6-self-tapping-Screw001
M2x6-self-tapping-Screw002
M2x6-self-tapping-Screw003
M2x6-self-tapping-Screw004
M2x6-self-tapping-Screw005
M2x6-self-tapping-Screw006
M2x6-self-tapping-Screw007
