wandrewkeech/SnakeOil-XY/WIP/component-assembly/addon-filament-guide-arm-assembly.FCStd

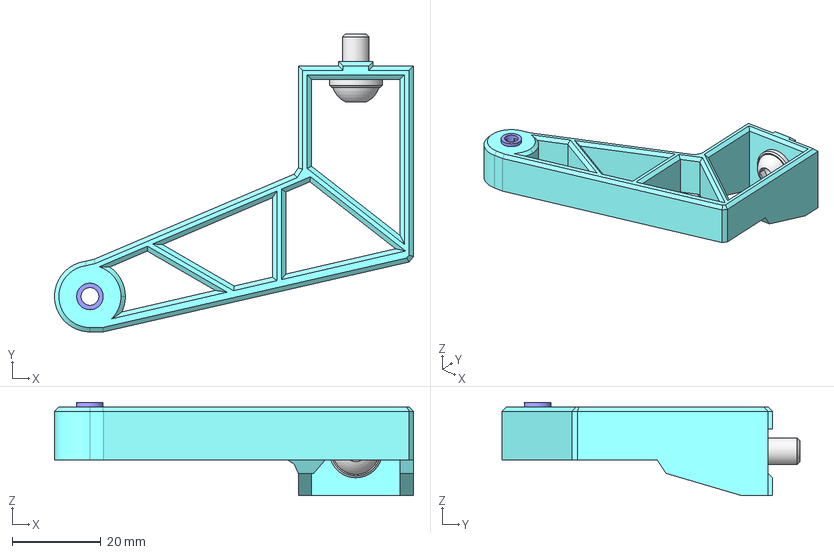
[picture p47: CAD file, 2022-01-15]
WIP/component-assembly/addon-filament-guide-arm-assembly.FCStd
81.0 x 67.2 x 21.0 mm
M6-Washer
M6x12-Screw
filament-guide-e3d-collet
E3D-bowden-collet
