wandrewkeech/SnakeOil-XY/WIP/component-assembly/cherrymz-button-assembly.FCStd

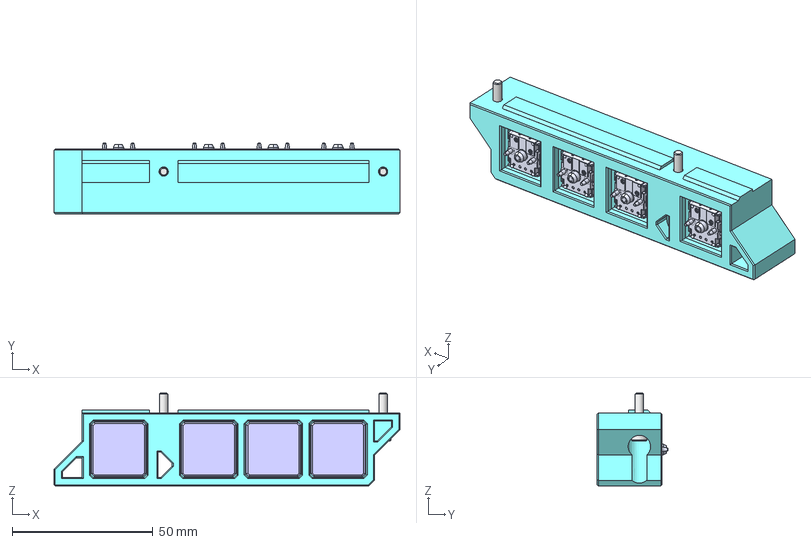
[picture p48: CAD file, 2022-01-15]
WIP/component-assembly/cherrymz-button-assembly.FCStd
123.0 x 25.1 x 33.0 mm
cherrymx
button-cap
cherrymx001
cherrymx002
cherrymx003
button-cap001
button-cap002
button-cap003
M3x14-Screw
M3x14-Screw001
M3-Washer
M3-Washer001
cherrymx_mounter
