wandrewkeech/SnakeOil-XY/WIP/component-assembly/z-block-mount-right-assembly.FCStd

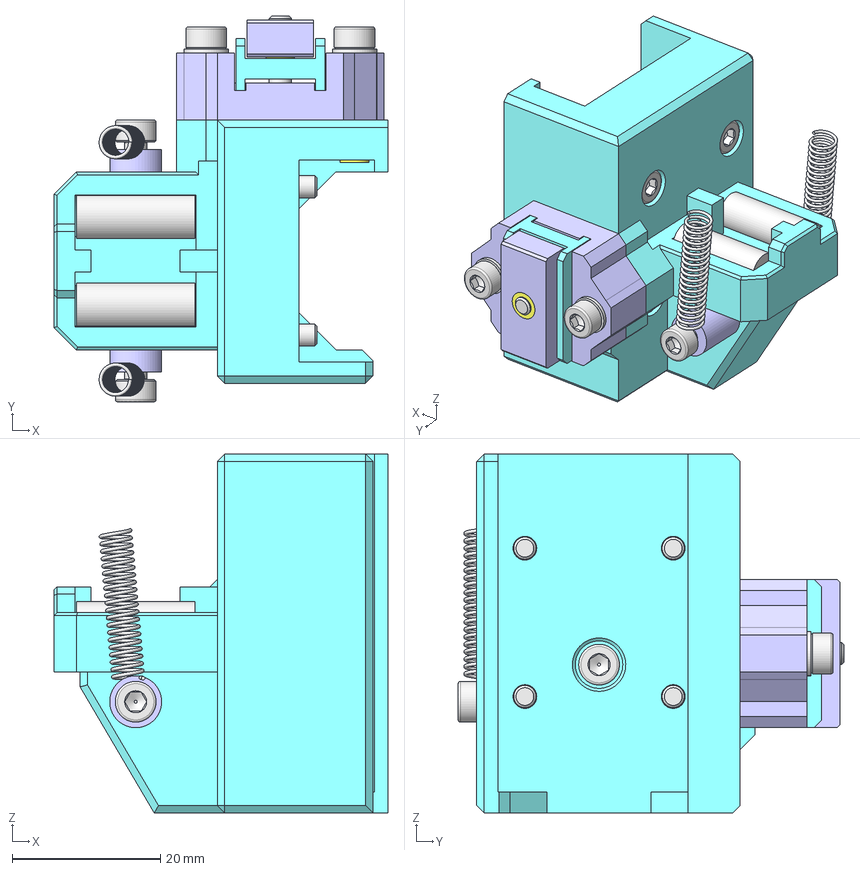
[picture p49: CAD file, 2022-01-15]
WIP/component-assembly/z-block-mount-right-assembly.FCStd
45.0 x 52.0 x 48.4 mm
6x16-dowel-pin002
6x16-dowel-pin003
z-belt-mounter-clamp-nut001
z-belt-mounter-middle001
z-belt-block-mount001
bed-spring-bottom-spacer003
bed-spring-bottom-spacer002
hook-spring-005
hook-spring-006
M3-Washer
M3-Washer020
M3-Washer021
M3-Washer022
M3x10-Screw
M3x10-Screw004
M3x10-Screw005
M3x10-Screw006
M3x4-HeatSet005
M3x4-HeatSet006
M3x4-HeatSet007
M3x4-HeatSet008
M3x4-HeatSet009
M3x4-HeatSet010
M3x12-Screw001
M3-Washer018
M3-Washer019
M3x14-Screw002
M3x14-Screw003
M3x16-Screw005
M3x16-Screw006
M3x25-Screw
z-rail-block-mount-right-with-limiter
