wandrewkeech/SnakeOil-XY/WIP/component-assembly/y-carrier-2010-assembly.FCStd

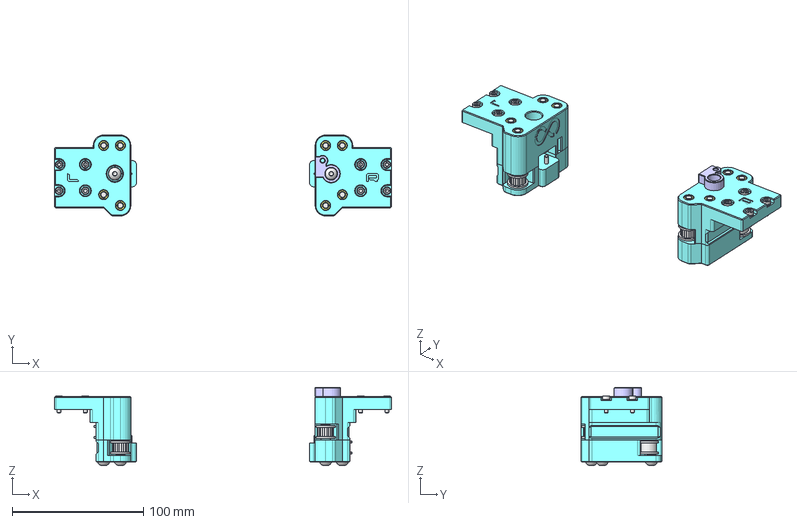
[picture p50: CAD file, 2021-12-27]
WIP/component-assembly/y-carrier-2010-assembly.FCStd
257.0 x 61.7 x 59.8 mm
M3-Washer
M3-Washer016
M3-Washer017
M3-Washer018
M3x10-Screw
M3x10-Screw012
M3x10-Screw013
M3x10-Screw014
M5-HeatSet
M5-HeatSet001
M5-HeatSet002
M5-HeatSet003
M3x4-HeatSet001
M5x50-Screw
M5x50-Screw008
M5x50-Screw009
M5x50-Screw010
M3-Washer023
M3-Washer024
M3-Washer025
M3-Washer026
M3x10-Screw019
M3x16-Screw
smooth-idler-6mm
20t-idler
bottom-left-r003
top-left-r003
M5-Washer
M5x20-Screw
M3x4-HeatSet003
M5-HeatSet004
M5-HeatSet005
M5-HeatSet006
M5-HeatSet007
M3-Washer019
M3-Washer020
M3-Washer021
M3-Washer022
M3x10-Screw015
M3x10-Screw016
M3x10-Screw017
M3x10-Screw018
M5x50-Screw011
M5x50-Screw012
M5x50-Screw013
M5x50-Screw014
M3-Washer027
M3-Washer028
M3-Washer029
M3-Washer030
M3x10-Screw021
M3x16-Screw001
20t-idler001
smooth-idler-6mm001
bottom-right-r003
endstop-flag001
M5-Washer001
M5x8-Screw
M3-HeatSet
