wandrewkeech/SnakeOil-XY/WIP/component-assembly/180-glass-bed-assembly.FCStd

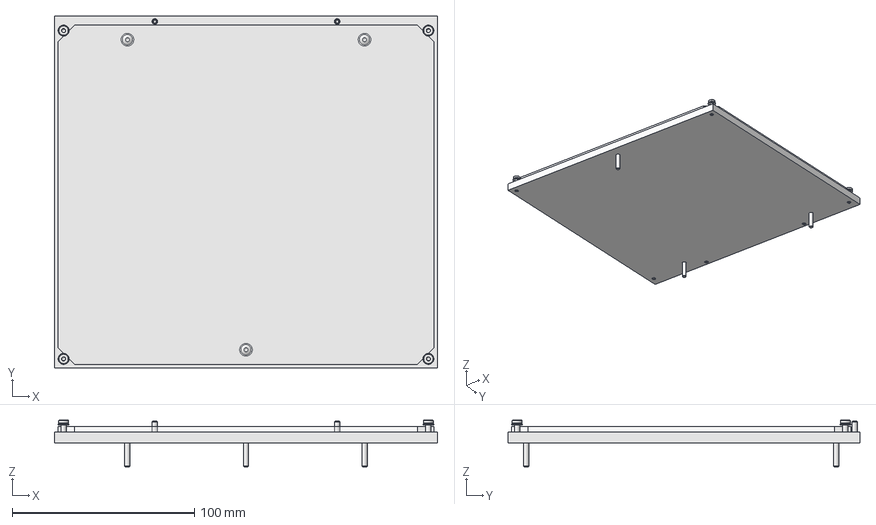
[picture p51: CAD file, 2021-12-27]
WIP/component-assembly/180-glass-bed-assembly.FCStd
210.0 x 193.0 x 25.6 mm
180-glass-plate
180-aluminum-plate
M3x16-Screw
M3x16-Screw001
M3x16-Screw002
M3x12-Screw
M3x12-Screw001
M3-Silicon-Washer
M3-Silicon-Washer001
M3-Silicon-Washer002
M3-Silicon-Washer003
M3x10-low-head Screw
M3x10-low-head Screw001
M3x10-low-head Screw002
M3x10-low-head Screw003
