wandrewkeech/SnakeOil-XY/WIP/component-assembly/250-glass-bed-assembly.FCStd

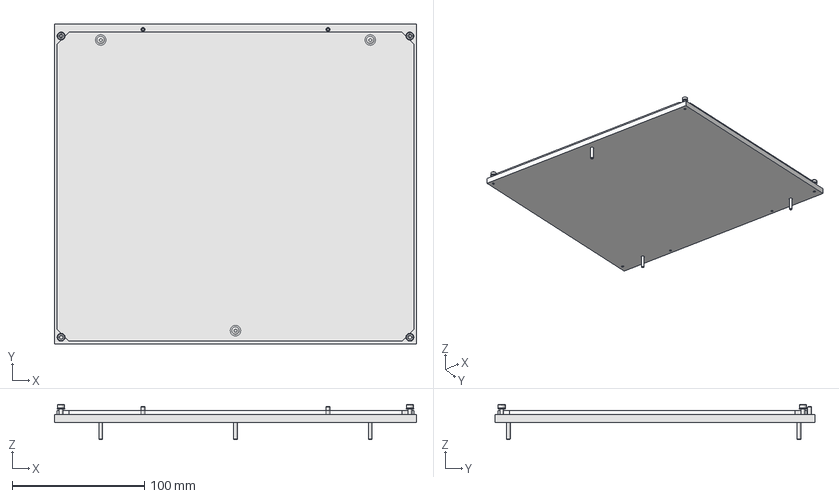
[picture p52: CAD file, 2021-12-27]
WIP/component-assembly/250-glass-bed-assembly.FCStd
274.0 x 242.0 x 26.6 mm
250-glass-plate
250-aluminum-plate
M3x16-Screw
M3x16-Screw001
M3x16-Screw002
M3x12-Screw
M3x12-Screw001
M3-silicon-Washer
M3-silicon-Washer001
M3-silicon-Washer002
M3-silicon-Washer003
M3x10-low-head-Screw
M3x10-low-head-Screw001
M3x10-low-head-Screw002
M3x10-low-head-Screw003
