wandrewkeech/SnakeOil-XY/WIP/component-assembly/left-panel-assembly.FCStd

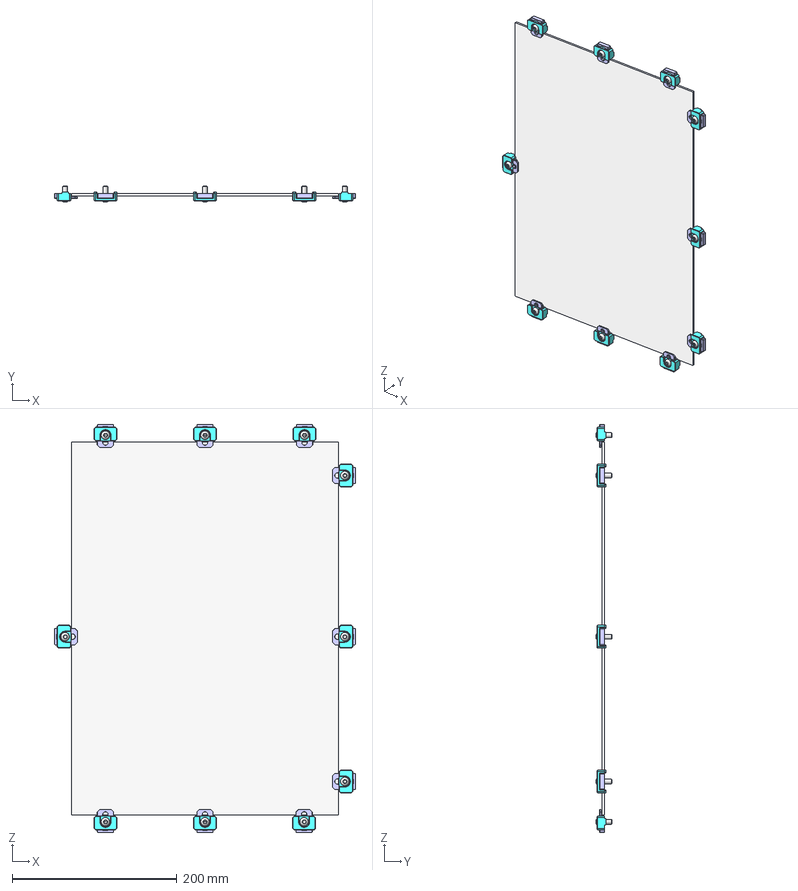
[picture p53: CAD file, 2021-12-01]
WIP/component-assembly/left-panel-assembly.FCStd
366.0 x 19.3 x 496.0 mm
panel-324x454x3mm001
mounter-inner012
mounter-outer020
M6x16-Screw016
mounter-inner013
mounter-outer019
M6x16-Screw017
mounter-inner014
mounter-outer018
M6x16-Screw018
mounter-inner015
mounter-outer017
M6x16-Screw019
mounter-inner016
mounter-outer016
M6x16-Screw020
mounter-inner017
mounter-outer015
M6x16-Screw021
mounter-inner018
mounter-outer014
M6x16-Screw022
mounter-inner019
mounter-outer013
M6x16-Screw023
mounter-inner020
mounter-outer012
M6x16-Screw025
M6x16-Screw026
