wandrewkeech/SnakeOil-XY/WIP/component-assembly/air-filter-assembly-A4.FCStd

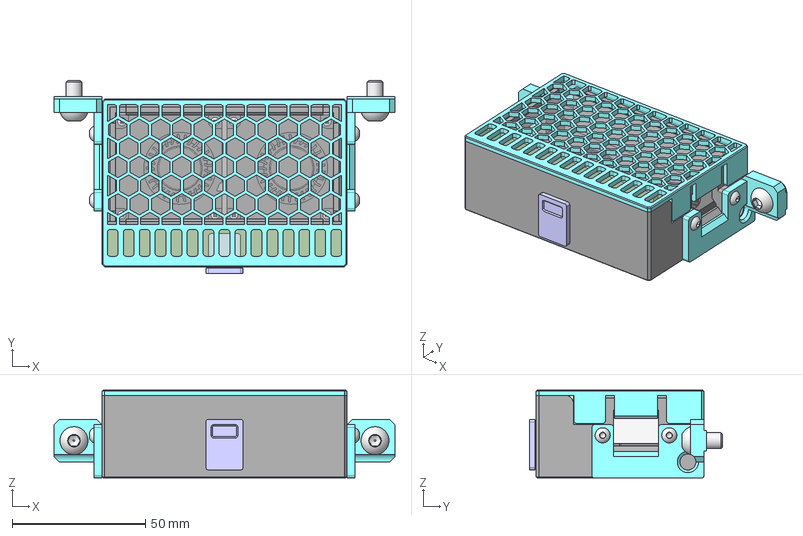
[picture p54: CAD file, 2021-12-01]
WIP/component-assembly/air-filter-assembly-A4.FCStd
128.0 x 72.5 x 33.0 mm
AirFilterHousing
HepaFilter
ActiveCarbonFoamCartridge
M3x6-Screw002
M6x12-Screw001
M3x6-Screw003
4010Fan x 2
M1.6x6-Screw x 2
M1.6x6-Screw001 x 2
M1.6x6-Screw002 x 2
M1.6x6-Screw003 x 2
Chamfer010015011016001 (Mirror #1)002
M3x6-Screw004
M6x12-Screw
M3x6-Screw
level002
