wandrewkeech/SnakeOil-XY/WIP/component-assembly/y-carrier-right-1515-assembly.FCStd

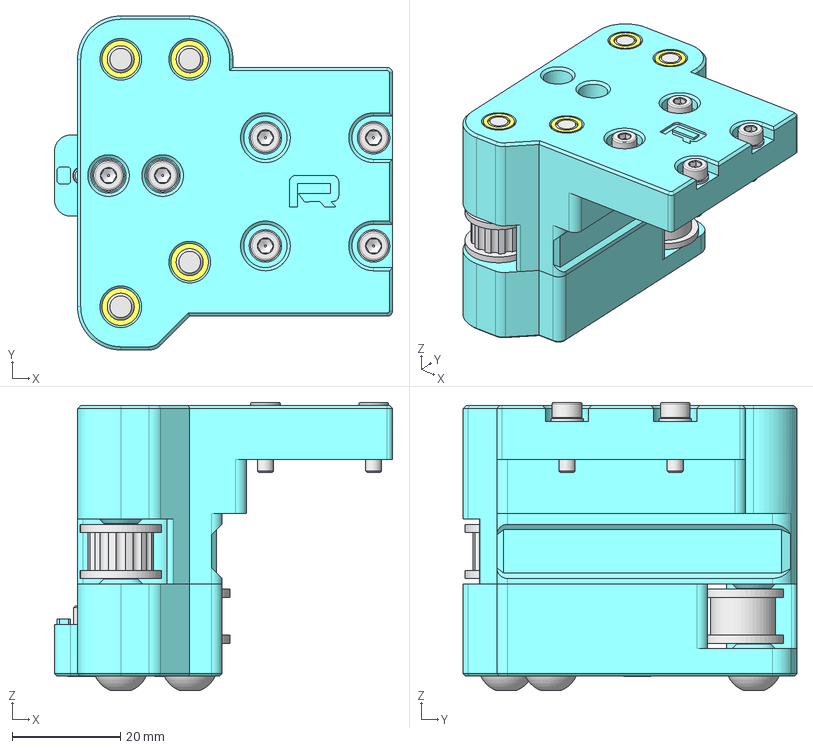
[picture p55: CAD file, 2021-12-01]
WIP/component-assembly/y-carrier-right-1515-assembly.FCStd
62.5 x 61.7 x 53.3 mm
20t-idler
smooth-idler-6mm
M5x50-Screw004
M5x50-Screw005
M5x50-Screw006
M5x50-Screw
M3x10-Screw
M3x10-Screw003
M3x10-Screw004
M3x10-Screw005
M3-Washer008
M3-Washer009
M3-Washer007
M3-Washer
y-carrier-bottom-right
y-carrier-top-right
M3-Washer021
M3x10-Screw011
M3-Washer023
M3x10-Screw012
M3-Washer022
M3x10-Screw013
M3-Washer015
M3x12-Screw001
M3x12-Screw
M3-Washer014
M5-HeatSet
M5-HeatSet001
M5-HeatSet002
M5-HeatSet003
