wandrewkeech/SnakeOil-XY/WIP/component-assembly/extruder-cable-end-assembly.FCStd

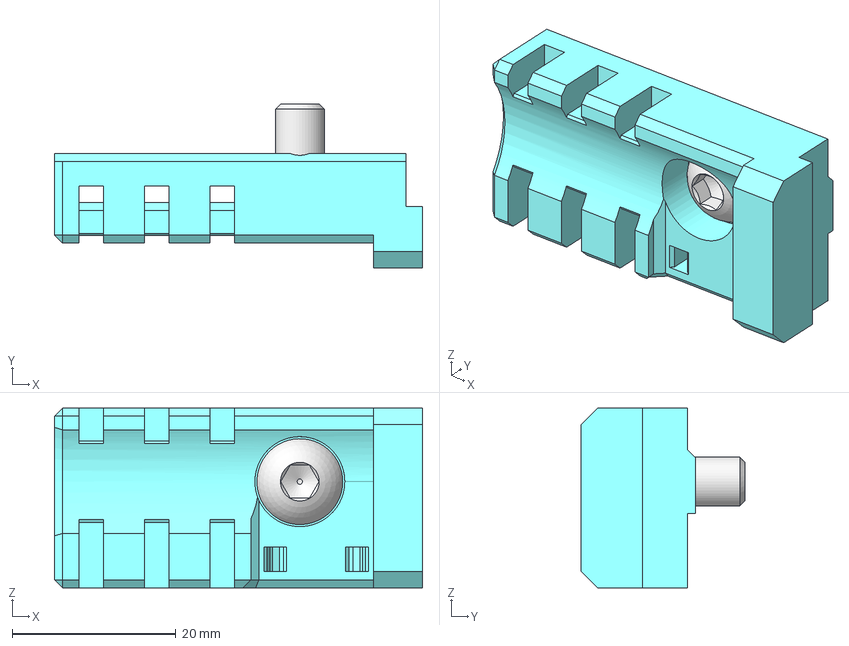
[picture p56: CAD file, 2021-12-01]
WIP/component-assembly/extruder-cable-end-assembly.FCStd
45.0 x 20.0 x 22.0 mm
M6x10-Screw
extruder-cable-end-mounter
