wandrewkeech/SnakeOil-XY/WIP/component-assembly/foot-single-assembly.FCStd

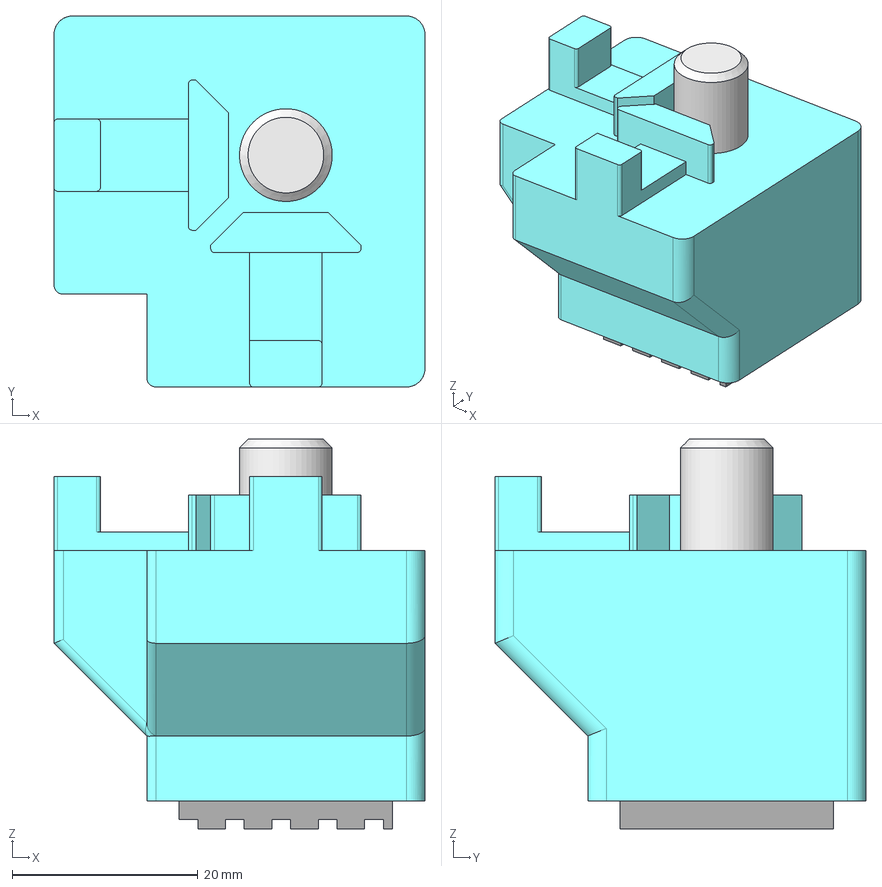
[picture p57: CAD file, 2021-12-01]
WIP/component-assembly/foot-single-assembly.FCStd
40.0 x 40.0 x 42.0 mm
foot-corner
subber
M10x25-Screw
