wandrewkeech/SnakeOil-XY/WIP/component-assembly/addon-chamber-temp-sensor-assembly.FCStd

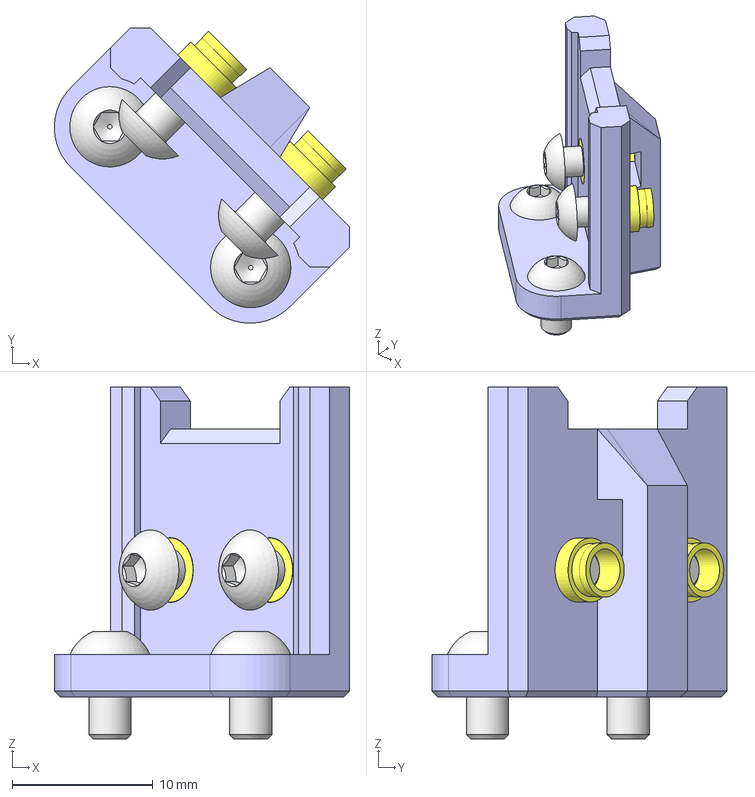
[picture p58: CAD file, 2021-12-01]
WIP/component-assembly/addon-chamber-temp-sensor-assembly.FCStd
21.0 x 21.0 x 25.0 mm
HTU21D-mounter
M3x3-HeatSet001
M3x3-HeatSet
M3x6-Screw
M3x6-Screw006
M3x6-Screw007
M3x6-Screw008
