wandrewkeech/SnakeOil-XY/WIP/component-assembly/addon-camera-assembly.FCStd

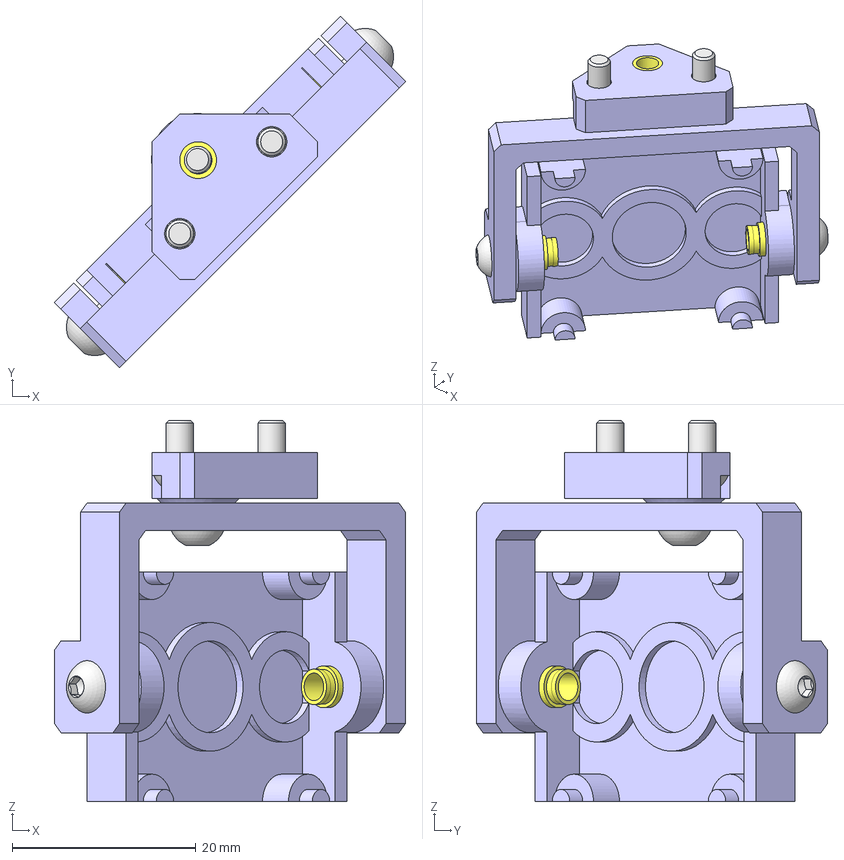
[picture p59: CAD file, 2021-12-01]
WIP/component-assembly/addon-camera-assembly.FCStd
38.2 x 38.2 x 41.5 mm
camera-back-plate
camera-axis
M3x3-HeatSet002
M3x3-HeatSet003
M3x3-HeatSet004
M3x6-Screw012
M3x6-Screw011
camera-arm
M3x6-Screw017
M3x6-Screw016
M3x6-Screw013
