wandrewkeech/SnakeOil-XY/WIP/component-assembly/y-endstop-assembly.FCStd

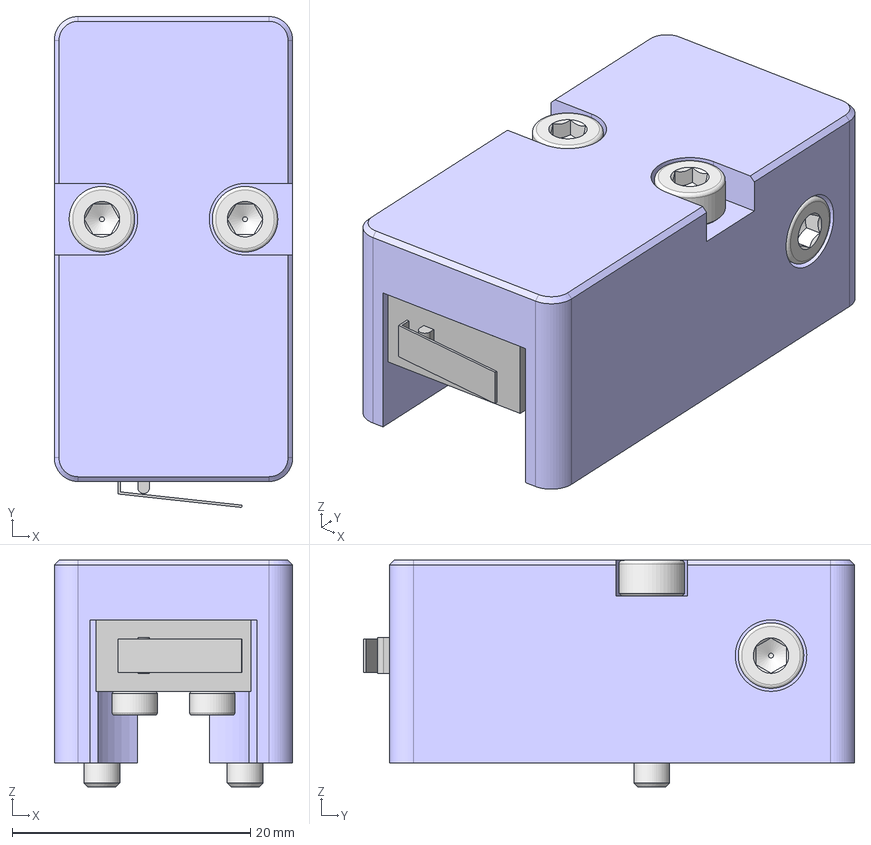
[picture p60: CAD file, 2021-12-01]
WIP/component-assembly/y-endstop-assembly.FCStd
20.0 x 41.2 x 19.0 mm
y-endstop-housing
y-endstop-wire-clamp
endstop-switch
M3x3-HeatSet
M3x16-Screw
M3x16-Screw001
M3x8-Screw
M2x10-self-tapping
M2x10-self-tapping001
