wandrewkeech/SnakeOil-XY/WIP/component-assembly/xy-belt-assembly.FCStd

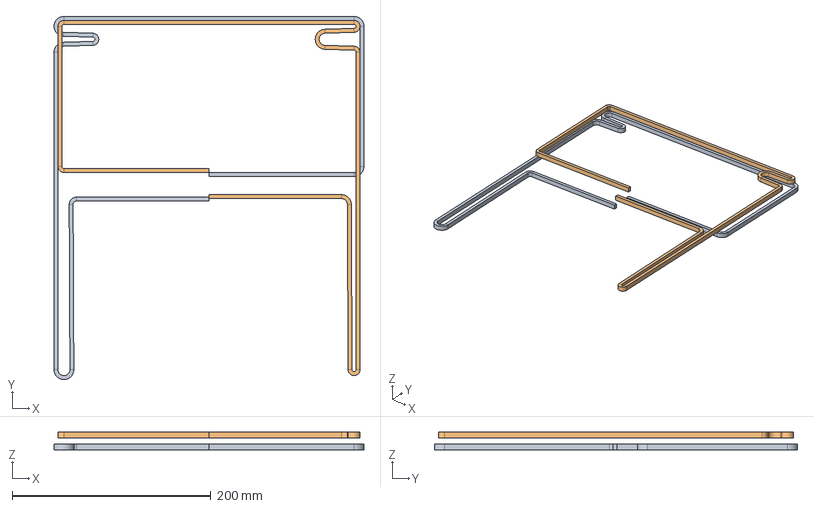
[picture p61: CAD file, 2021-12-01]
WIP/component-assembly/xy-belt-assembly.FCStd
312.0 x 365.5 x 18.0 mm
x-belt
y-belt
