wandrewkeech/SnakeOil-XY/WIP/component-assembly/spool-holder-assembly.FCStd

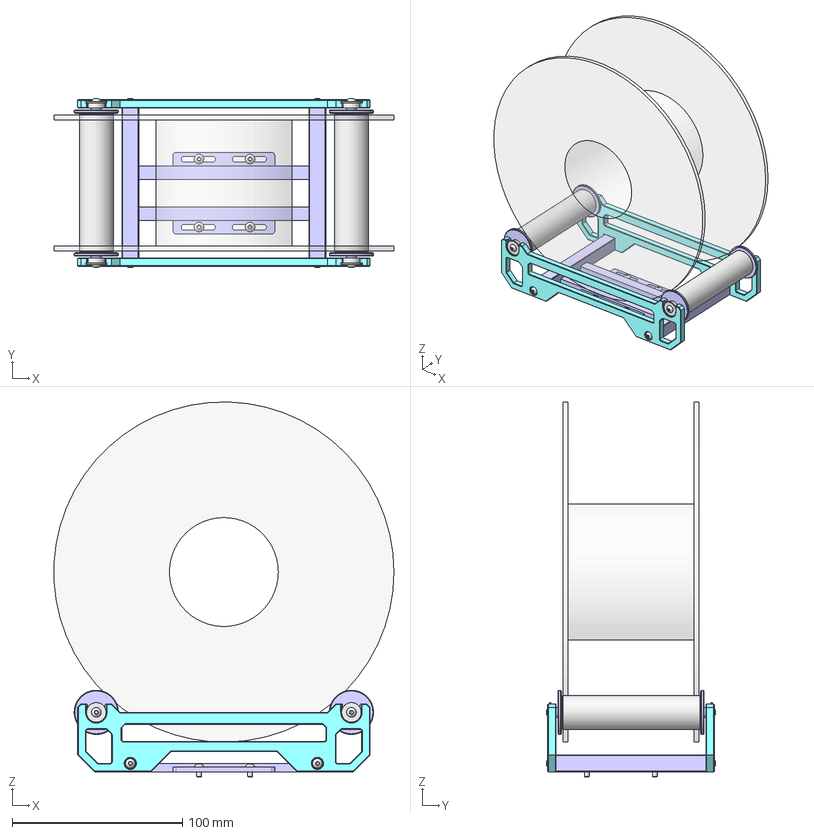
[picture p62: CAD file, 2021-12-01]
WIP/component-assembly/spool-holder-assembly.FCStd
199.8 x 99.3 x 220.5 mm
spool-holder-base
filament-spoll
M3x6-Screw101
M3x6-Screw103
M3x6-Screw100
M3x6-Screw102
M3x30-Screw
F623-bearing002
M3x10-Screw179
M3x10-Screw180
spool-holder-face
M3x10-Screw181
M3x10-Screw182
spool-holder-face001
M3x30-Screw001
F623-bearing003
M3x30-Screw002
F623-bearing004
M3x30-Screw003
F623-bearing005
spool-holder-spacer
spool-holder-spacer001
spool-holder-spacer002
spool-holder-spacer003
spool-holder-roller001
spool-holder-roller
M3x4-HeatSet
M3x4-HeatSet001
M3x4-HeatSet002
M3x4-HeatSet003
M3x4-HeatSet004
M3x4-HeatSet005
M3x4-HeatSet006
M3x4-HeatSet007
