wandrewkeech/SnakeOil-XY/WIP/component-assembly/linear-rail-assembly.FCStd

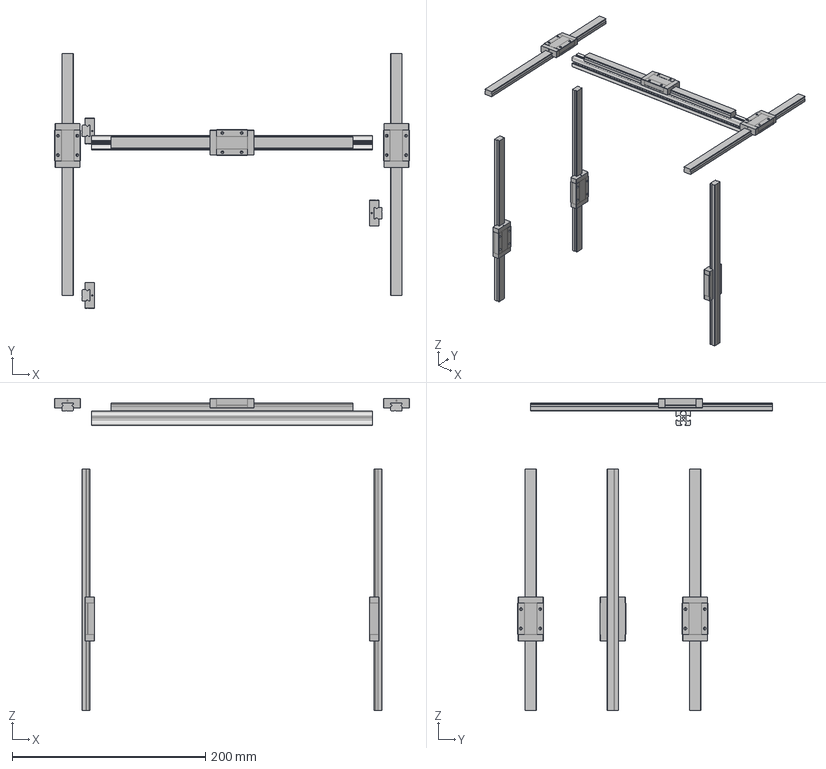
[picture p63: CAD file, 2021-12-01]
WIP/component-assembly/linear-rail-assembly.FCStd
367.0 x 263.5 x 323.0 mm
250mm-rail004
MGN!12H-block004
1515-290mm
250mm-rail005
MGN!12H-block005
MGN!12H-block006
250mm-rail006
MGN!12H-block002
MGN!12H-block001
250mm-rail002
MGN!12H-block003
250mm-rail001
250mm-rail003
