wandrewkeech/SnakeOil-XY/WIP/component-assembly/bottom-panel-250-assembly.FCStd

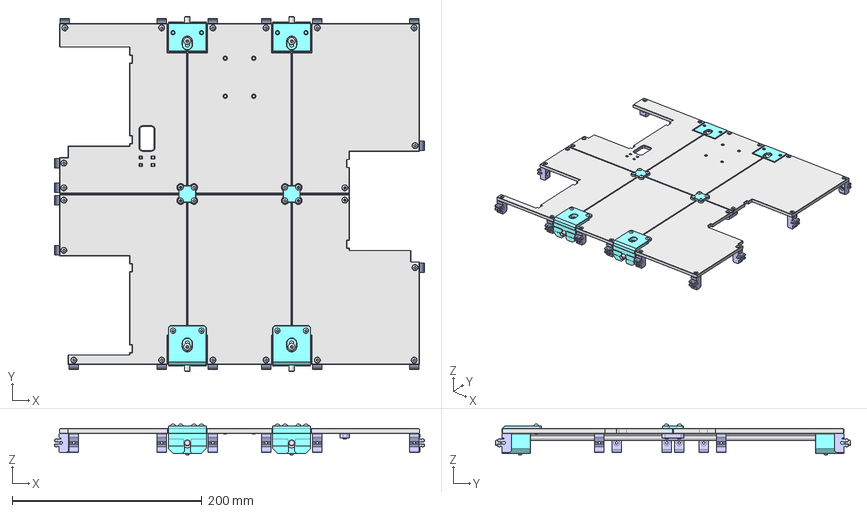
[picture p64: CAD file, 2021-12-01]
WIP/component-assembly/bottom-panel-250-assembly.FCStd
390.0 x 374.0 x 32.1 mm
din-rail-332mm002
din-rail-332mm001
front-din-cap
back-din-cap
back-din-cap001
front-din-cap001
bottom-din-holder
bottom-din-holder001
bottom-din-holder002
bottom-din-holder003
M6x12-Screw
M6x12-Screw004
M6x12-Screw005
M6x12-Screw006
M4-Nut
M4-Nut004
M4-Nut005
M4-Nut006
M4x25-Screw
M4x25-Screw001
M4x25-Screw002
M4x25-Screw003
M3x6-Screw
M3x6-Screw001
M3x6-Screw002
M3x6-Screw003
M3x4-HeatSet001
M3x4-HeatSet
M3x4-HeatSet002
M3x4-HeatSet046
M3x4-HeatSet029
M3x4-HeatSet030
M3x4-HeatSet031
M3x4-HeatSet032
M3x4-HeatSet033
M3x4-HeatSet034
M3x4-HeatSet035
M3x4-HeatSet036
M3x4-HeatSet037
M3x4-HeatSet038
M3x4-HeatSet039
M3x4-HeatSet040
M3x4-HeatSet041
M3x4-HeatSet042
M3x4-HeatSet043
M3x4-HeatSet044
M3x6-Screw029
M3x6-Screw030
M3x6-Screw031
M3x6-Screw032
M3x6-Screw033
M3x6-Screw034
M3x6-Screw035
M3x6-Screw036
M3x6-Screw042
M3x6-Screw043
M3x6-Screw044
M3x6-Screw045
M3x6-Screw040
M3x6-Screw041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
