wandrewkeech/SnakeOil-XY/WIP/component-assembly/LCD-assembly.FCStd

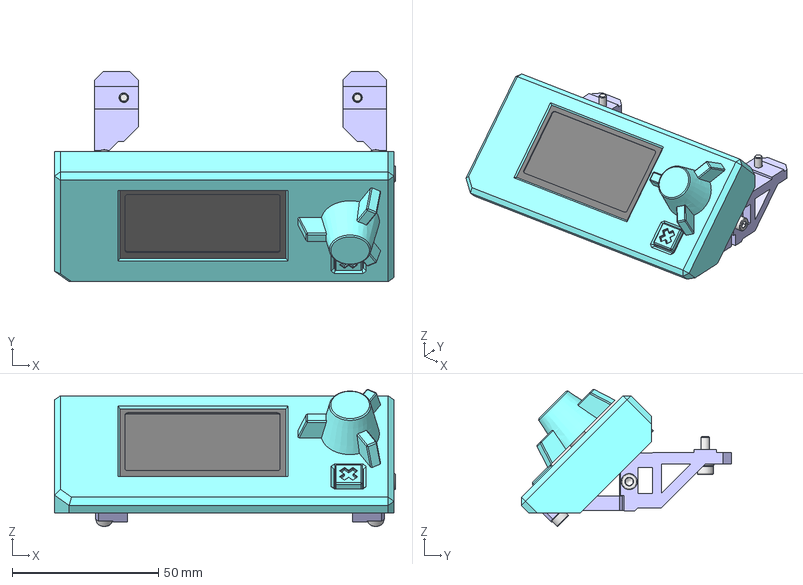
[picture p65: CAD file, 2021-12-01]
WIP/component-assembly/LCD-assembly.FCStd
116.5 x 71.8 x 46.8 mm
mount-arm-right
mount-arm-left
lcd-base
knob
reset-button
lcd-mounter-right
lcd-mounter-left
led-cover_use_dark_color_filament
M3x10-Screw
M3x10-Screw004
M3x8-Screw
M3x8-Screw001
M3x8-Screw002
M3x8-Screw003
M3-Washer
M3-Washer001
M3x10-Screw002
M3x10-Screw003
M3x4-HeatSet
M3x4-HeatSet001
M3x4-HeatSet002
M3x4-HeatSet003
M3x4-HeatSet004
M3x4-HeatSet005
Mini12864 Screen v1
Mini12864 Screen v002
Mini12864 Screen v003
Mini12864 Screen v006
