wandrewkeech/SnakeOil-XY/WIP/component-assembly/foot-assembly.FCStd

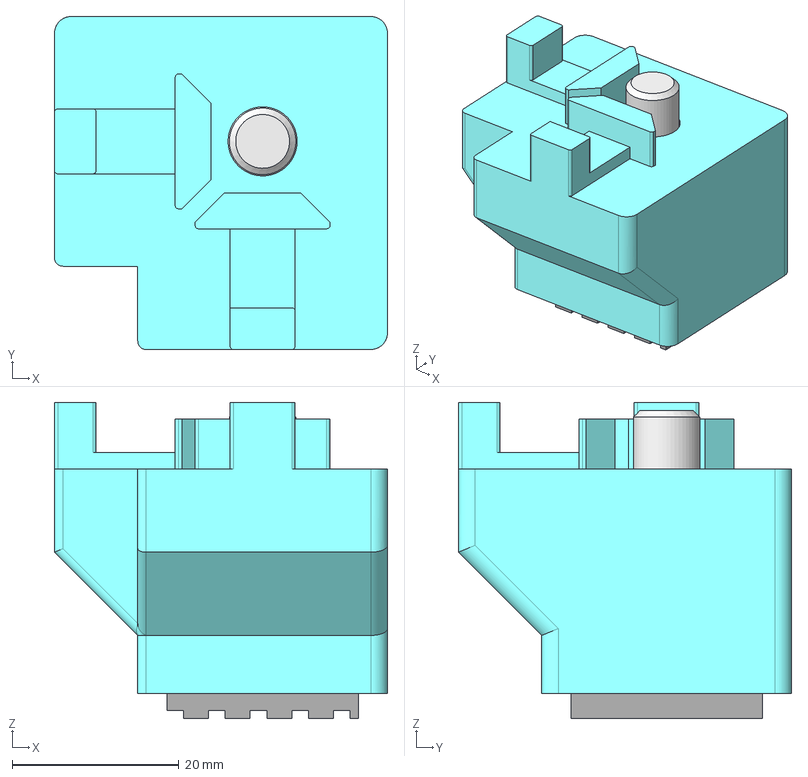
[picture p66: CAD file, 2021-12-01]
WIP/component-assembly/foot-assembly.FCStd
40.0 x 40.0 x 38.0 mm
foot-corner
rubber24x24x10
M8x20-Screw
