wandrewkeech/SnakeOil-XY/WIP/component-assembly/z-belt-assembly.FCStd

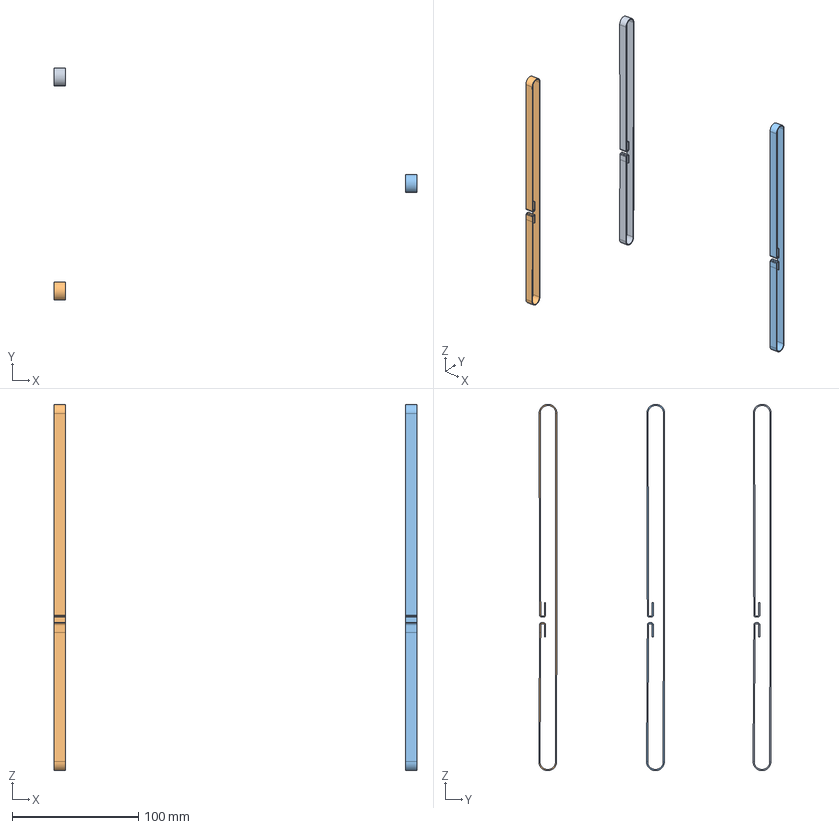
[picture p67: CAD file, 2021-12-01]
WIP/component-assembly/z-belt-assembly.FCStd
288.0 x 184.5 x 290.7 mm
z-belt-001
z-belt-002
z-belt-003
