wandrewkeech/SnakeOil-XY/BETA2_Release/STLs/E-axis/carrier-common/1515-carrier/1x_extruder-back-plate-wider.stl

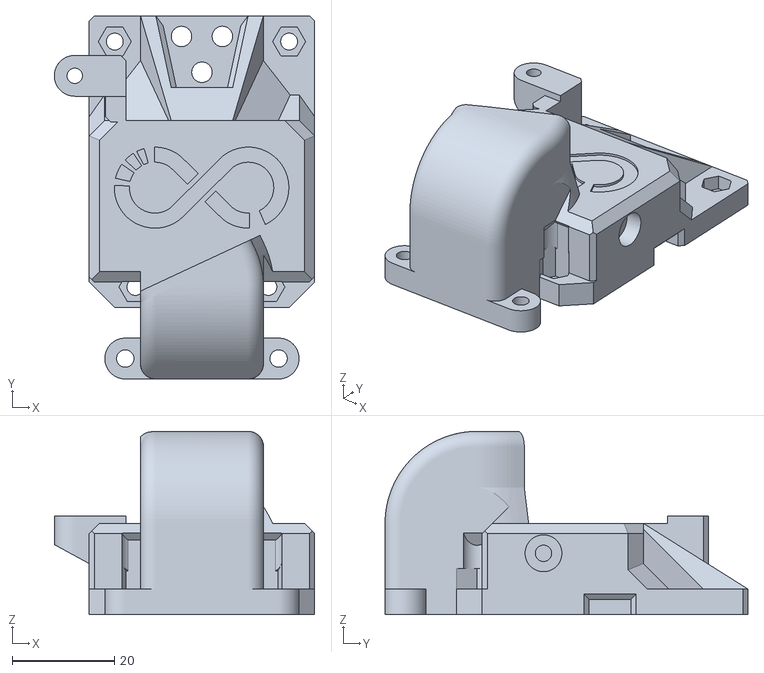
[picture p68: CAD file, 2021-12-01]
BETA2_Release/STLs/E-axis/carrier-common/1515-carrier/1x_extruder-back-plate-wider.stl
50.9 x 71.0 x 35.8
