wandrewkeech/SnakeOil-XY/BETA2_Release/STLs/Z-axis/patch/1x_right-cover.stl

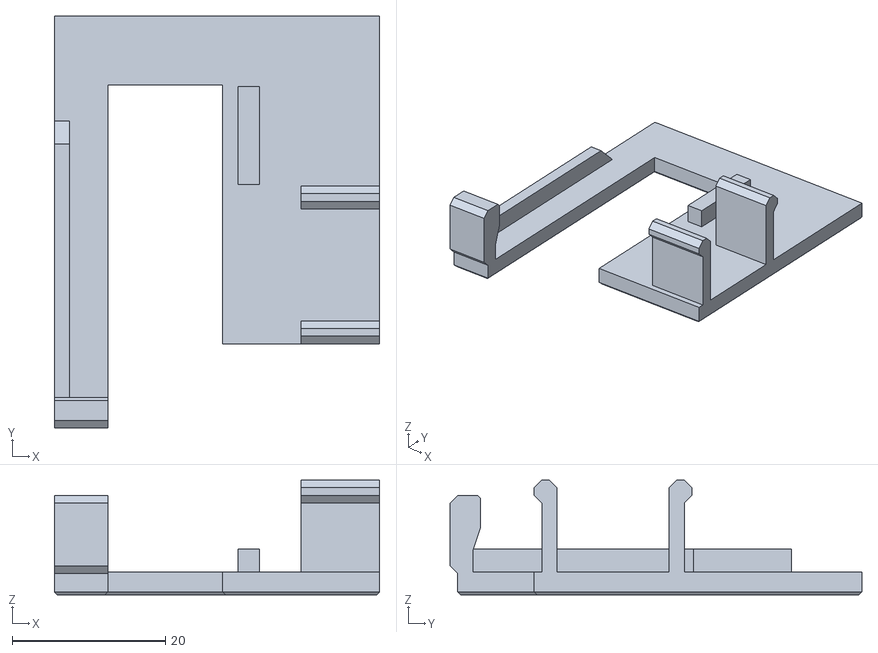
[picture p69: CAD file, 2021-12-27]
BETA2_Release/STLs/Z-axis/patch/1x_right-cover.stl
42.5 x 53.8 x 15.0
