wandrewkeech/SnakeOil-XY/BETA3_4PR_Release_STL/STLs/1515/M_1x_y-carrier-top-right.stl

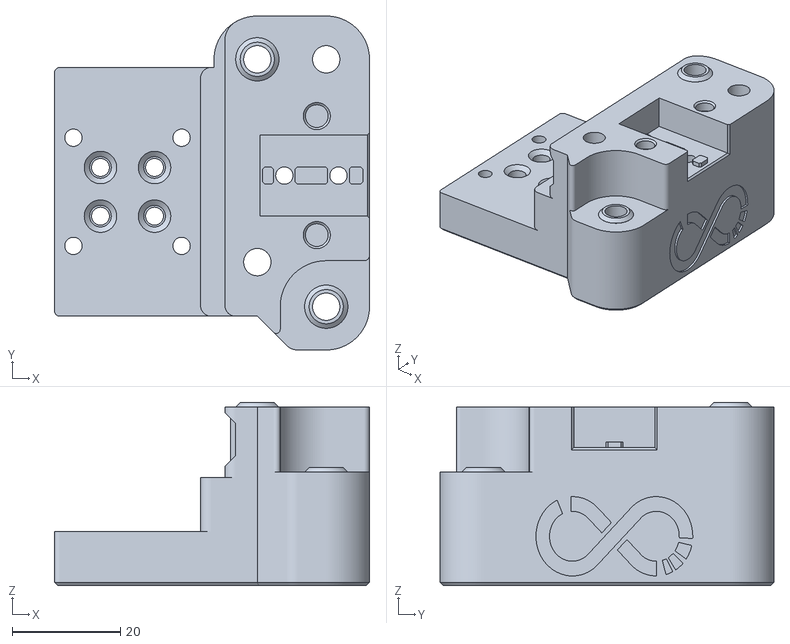
[picture p70: CAD file, 2023-02-25]
BETA3_4PR_Release_STL/STLs/1515/M_1x_y-carrier-top-right.stl
58.2 x 61.7 x 33.9
