wandrewkeech/SnakeOil-XY/BETA3_4PR_Release_STL/STLs/A_2x_c-tensioner-idler-housing.stl

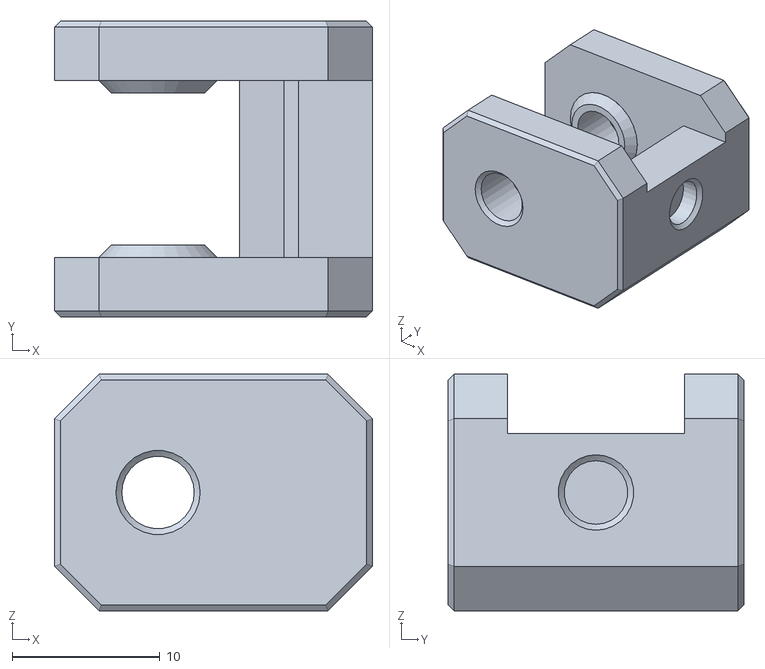
[picture p71: CAD file, 2023-02-25]
BETA3_4PR_Release_STL/STLs/A_2x_c-tensioner-idler-housing.stl
21.5 x 20.0 x 16.0
