wandrewkeech/SnakeOil-XY/BETA3_4PR_Release_STL/STLs/OPTIONAL-4z/2x_bed-arm-mount-mirror.stl

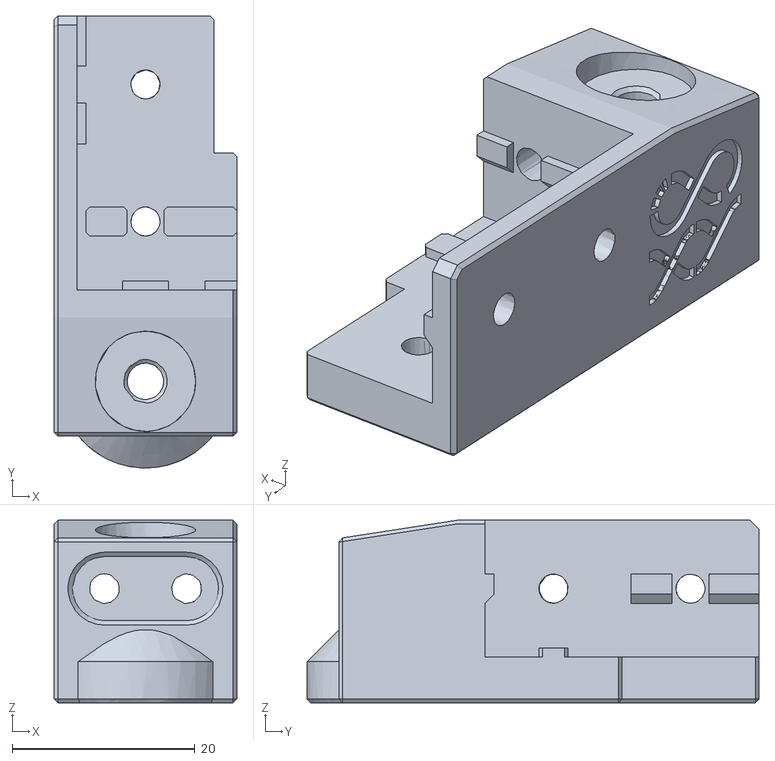
[picture p72: CAD file, 2023-02-25]
BETA3_4PR_Release_STL/STLs/OPTIONAL-4z/2x_bed-arm-mount-mirror.stl
20.0 x 49.5 x 20.0
