wandrewkeech/SnakeOil-XY/BETA3_IDEX_Release_STL/STLs/Add-on/Air-filter/1x_air-filter-mounter-right.stl

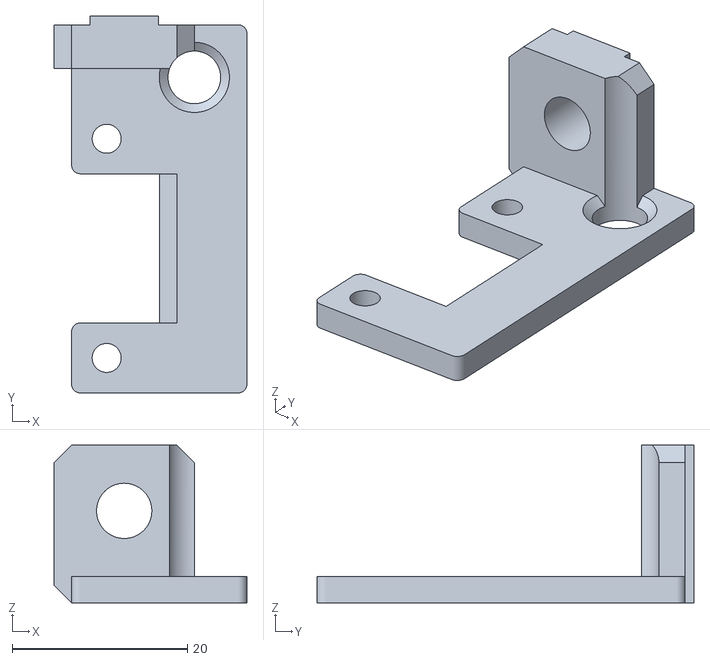
[picture p73: CAD file, 2021-12-01]
BETA3_IDEX_Release_STL/STLs/Add-on/Air-filter/1x_air-filter-mounter-right.stl
22.0 x 43.0 x 18.0
