wandrewkeech/SnakeOil-XY/BETA3_IDEX_Release_STL/STLs/Add-on/alt-idler-for-flat-nut/1x_left-idler-mid.stl

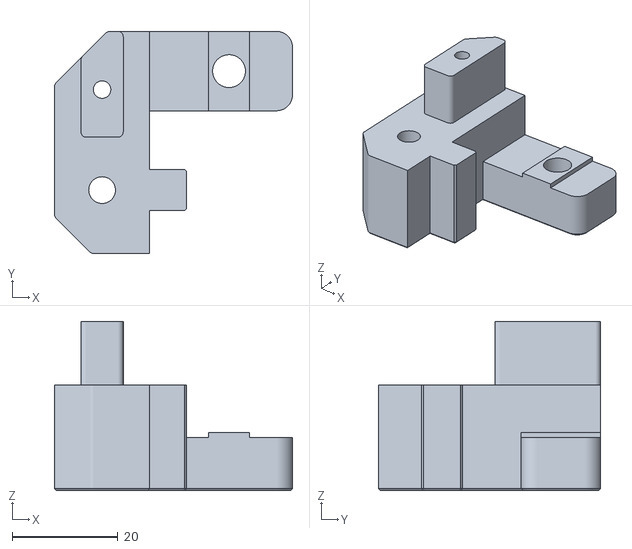
[picture p74: CAD file, 2022-03-22]
BETA3_IDEX_Release_STL/STLs/Add-on/alt-idler-for-flat-nut/1x_left-idler-mid.stl
45.0 x 42.0 x 32.0
