wandrewkeech/SnakeOil-XY/BETA3_IDEX_Release_STL/STLs/Add-on/Bear-filament-sensor/1x-fs-arm.stl

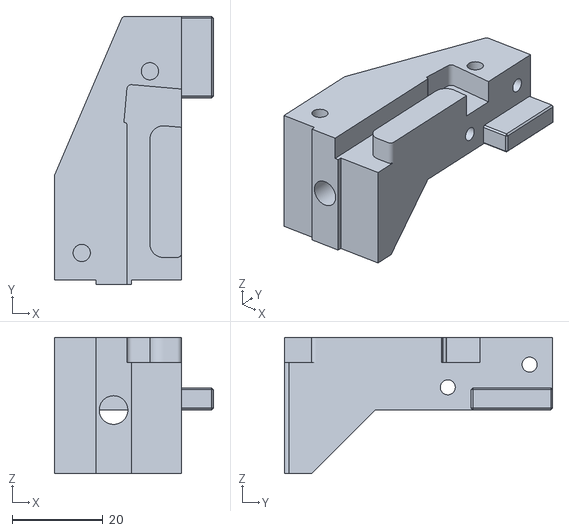
[picture p75: CAD file, 2023-02-25]
BETA3_IDEX_Release_STL/STLs/Add-on/Bear-filament-sensor/1x-fs-arm.stl
35.0 x 59.1 x 30.0
