wandrewkeech/SnakeOil-XY/BETA3_IDEX_Release_STL/STLs/Add-on/Cable-management/OPTIONAL_extrusion-channel-clip.stl

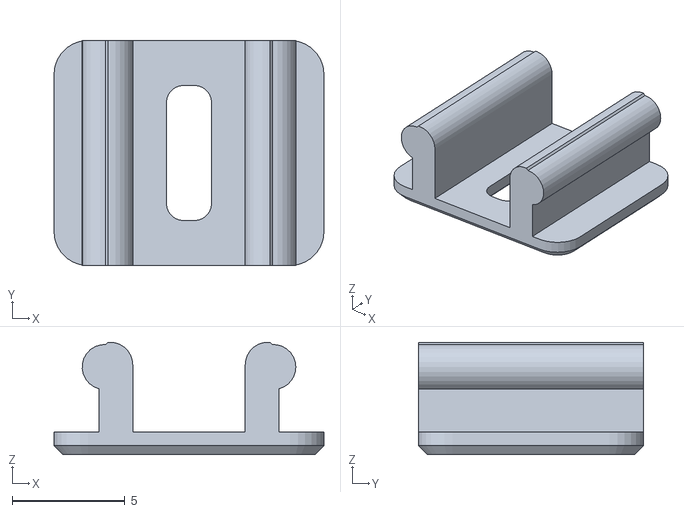
[picture p76: CAD file, 2022-03-22]
BETA3_IDEX_Release_STL/STLs/Add-on/Cable-management/OPTIONAL_extrusion-channel-clip.stl
12.0 x 10.0 x 5.00
