wandrewkeech/SnakeOil-XY/BETA3_IDEX_Release_STL/STLs/Add-on/Cherry-mx-button-mounter/1x_cherrymx-mounter.stl

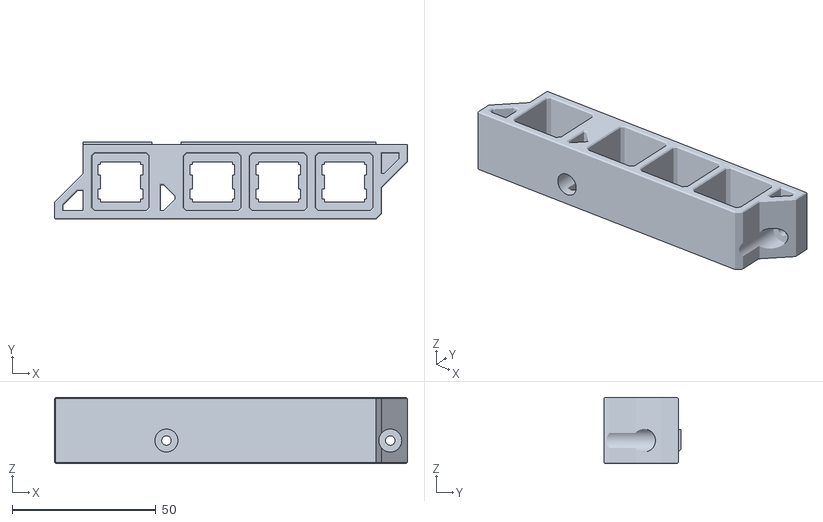
[picture p77: CAD file, 2022-01-15]
BETA3_IDEX_Release_STL/STLs/Add-on/Cherry-mx-button-mounter/1x_cherrymx-mounter.stl
123.0 x 27.0 x 23.0
