wandrewkeech/SnakeOil-XY/BETA3_IDEX_Release_STL/STLs/Add-on/dual-5015-mod/1x_bottom-plate-2020.stl

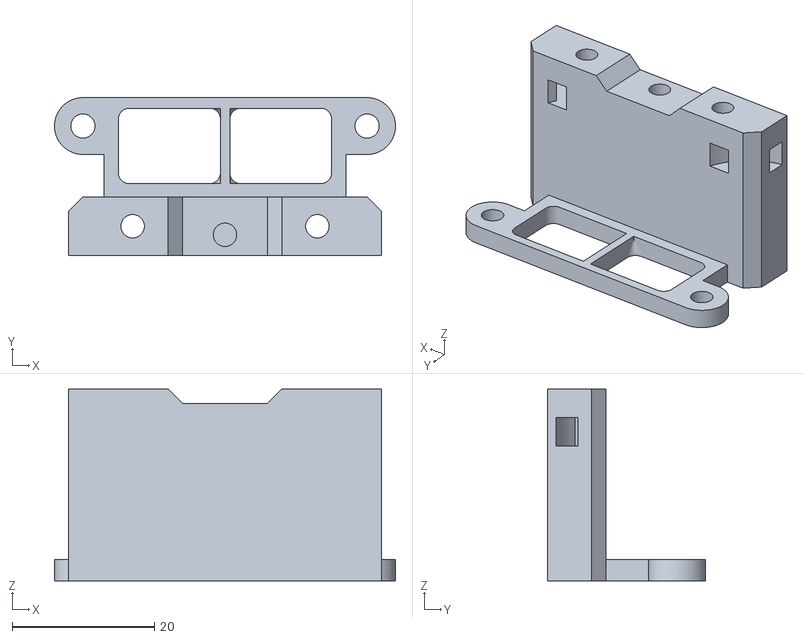
[picture p78: CAD file, 2021-12-27]
BETA3_IDEX_Release_STL/STLs/Add-on/dual-5015-mod/1x_bottom-plate-2020.stl
48.0 x 22.2 x 27.0
