wandrewkeech/SnakeOil-XY/BETA3_IDEX_Release_STL/STLs/Add-on/Filament-guide/1x_filament_guide_left.stl

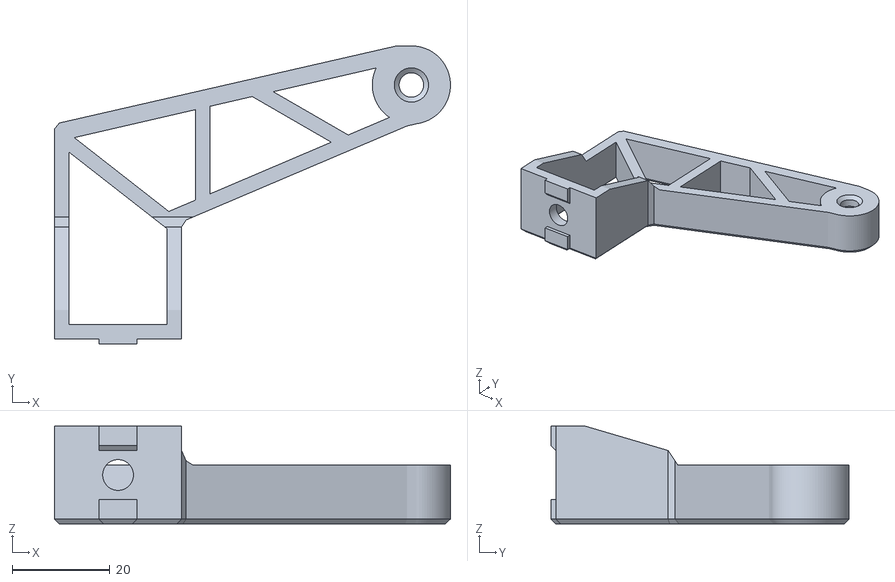
[picture p79: CAD file, 2023-02-25]
BETA3_IDEX_Release_STL/STLs/Add-on/Filament-guide/1x_filament_guide_left.stl
81.0 x 61.0 x 20.0
