wandrewkeech/SnakeOil-XY/BETA3_IDEX_Release_STL/STLs/Add-on/Generic-temp-sensor/sensor-mount-base.stl

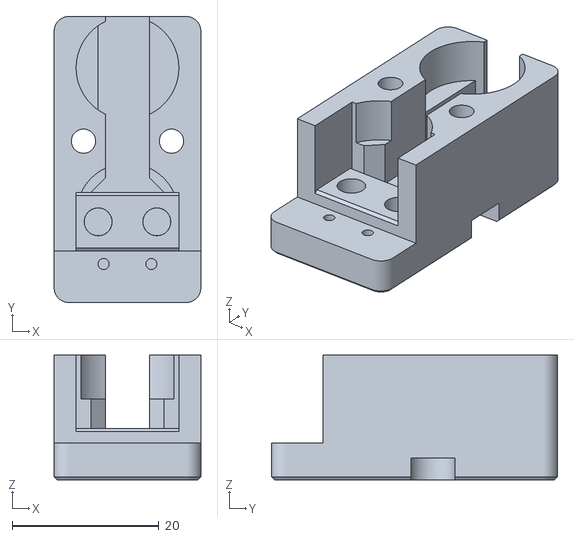
[picture p80: CAD file, 2021-12-01]
BETA3_IDEX_Release_STL/STLs/Add-on/Generic-temp-sensor/sensor-mount-base.stl
20.0 x 39.0 x 17.0
