wandrewkeech/SnakeOil-XY/BETA3_IDEX_Release_STL/STLs/Add-on/HTU21D-temp-sensor/HTU21D-mounter.stl

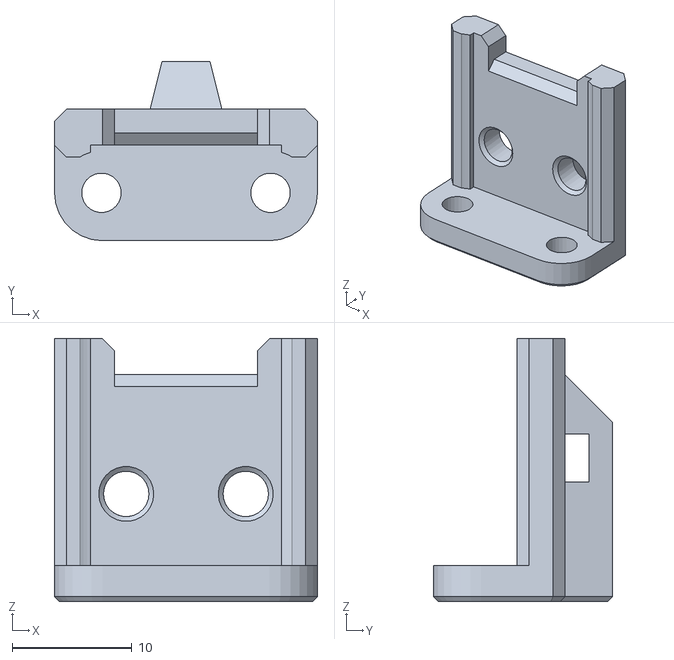
[picture p81: CAD file, 2023-02-25]
BETA3_IDEX_Release_STL/STLs/Add-on/HTU21D-temp-sensor/HTU21D-mounter.stl
22.0 x 15.0 x 22.0
