wandrewkeech/SnakeOil-XY/BETA3_IDEX_Release_STL/STLs/Add-on/Neopixel-mount/2x_neopixel-arm.stl

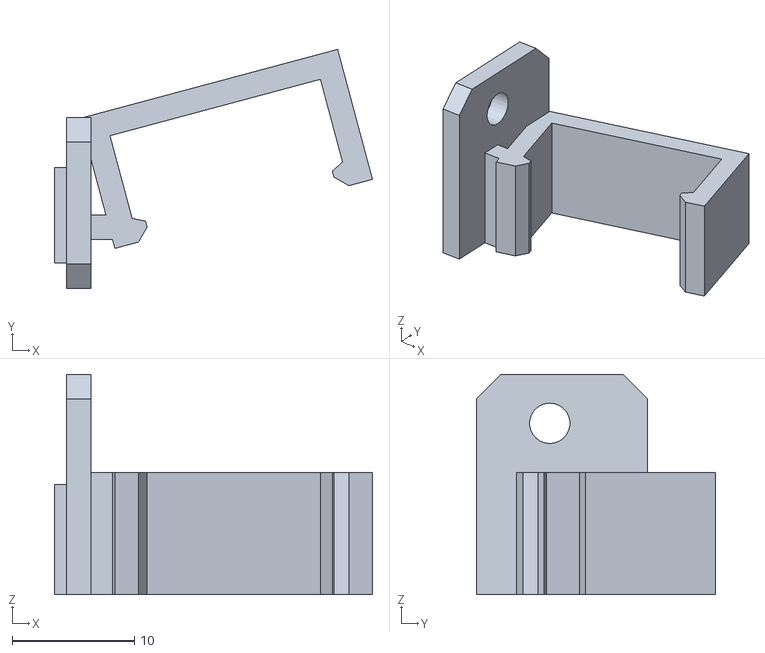
[picture p82: CAD file, 2022-03-22]
BETA3_IDEX_Release_STL/STLs/Add-on/Neopixel-mount/2x_neopixel-arm.stl
26.0 x 19.6 x 18.0
