wandrewkeech/SnakeOil-XY/BETA3_IDEX_Release_STL/STLs/Add-on/Ptfe-tube-guide/1x_ptfe-tube-guide-base.stl

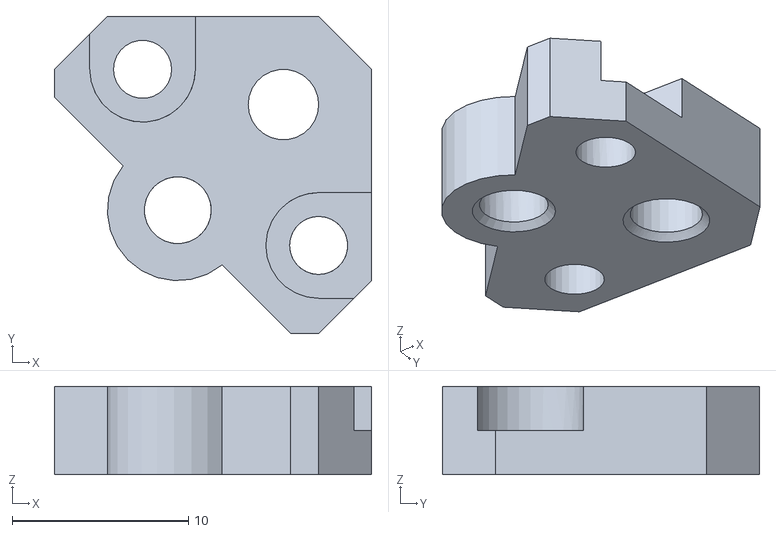
[picture p83: CAD file, 2022-03-22]
BETA3_IDEX_Release_STL/STLs/Add-on/Ptfe-tube-guide/1x_ptfe-tube-guide-base.stl
18.0 x 18.0 x 5.00
