wandrewkeech/SnakeOil-XY/BETA3_IDEX_Release_STL/STLs/Add-on/Retro-LCD/1x_lcd-arm-right.stl

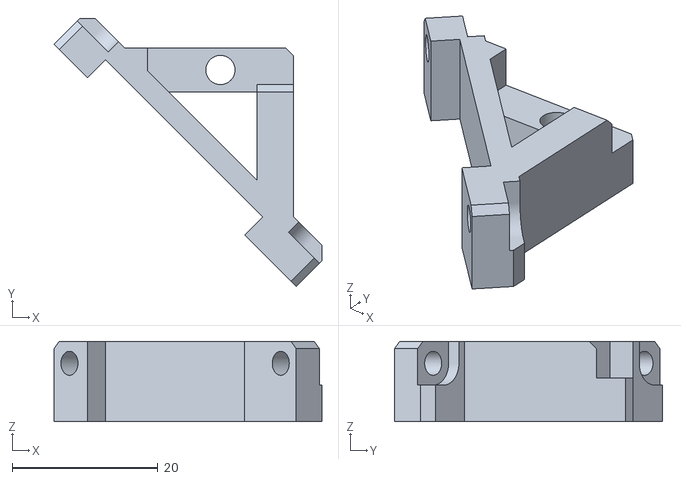
[picture p84: CAD file, 2023-02-25]
BETA3_IDEX_Release_STL/STLs/Add-on/Retro-LCD/1x_lcd-arm-right.stl
36.8 x 36.8 x 11.0
