wandrewkeech/SnakeOil-XY/BETA3_IDEX_Release_STL/STLs/Add-on/Spool-holder/2x_spool-holder-face.stl

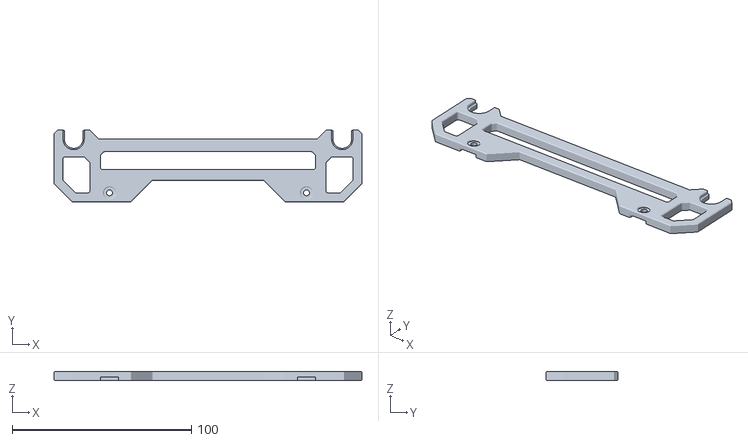
[picture p85: CAD file, 2023-02-25]
BETA3_IDEX_Release_STL/STLs/Add-on/Spool-holder/2x_spool-holder-face.stl
172.0 x 40.0 x 5.00
