wandrewkeech/SnakeOil-XY/BETA3_IDEX_Release_STL/STLs/E-axis/carrier-common/1x_idex_top_plate_EBB36_endstop_right.stl

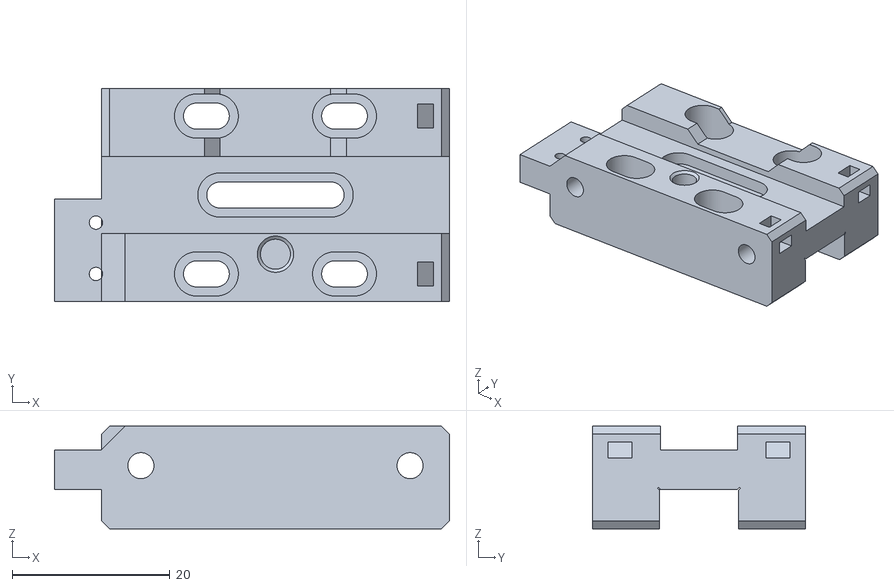
[picture p86: CAD file, 2023-02-25]
BETA3_IDEX_Release_STL/STLs/E-axis/carrier-common/1x_idex_top_plate_EBB36_endstop_right.stl
50.0 x 27.0 x 13.0
