wandrewkeech/SnakeOil-XY/BETA3_IDEX_Release_STL/STLs/E-axis/klicky-probe/1x_dock_Extension.stl

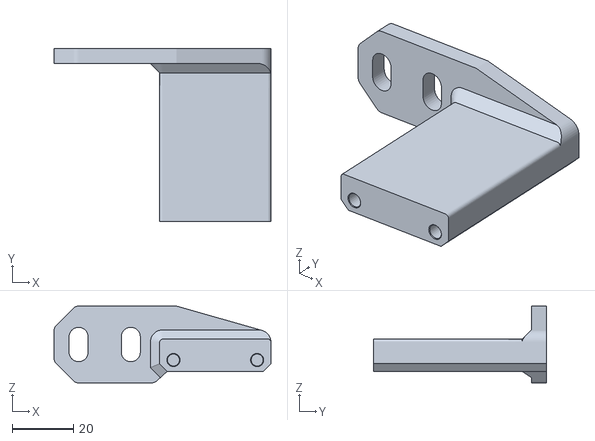
[picture p87: CAD file, 2023-02-25]
BETA3_IDEX_Release_STL/STLs/E-axis/klicky-probe/1x_dock_Extension.stl
70.6 x 56.4 x 25.0
