wandrewkeech/SnakeOil-XY/BETA3_IDEX_Release_STL/STLs/E-axis/strain-relief-toolhead.stl

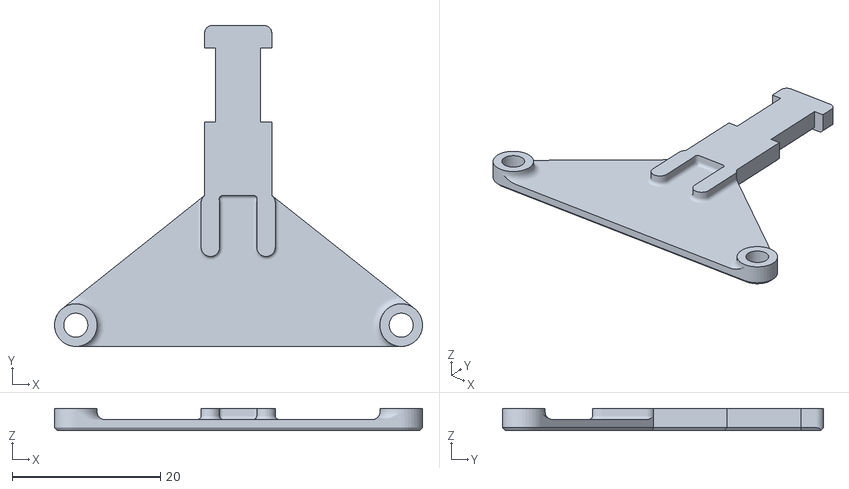
[picture p88: CAD file, 2023-02-25]
BETA3_IDEX_Release_STL/STLs/E-axis/strain-relief-toolhead.stl
49.6 x 43.3 x 3.00
