wandrewkeech/SnakeOil-XY/BETA3_IDEX_Release_STL/STLs/Panels/Bottom-panel-electronics-mounts/optional_din-ziptie.stl

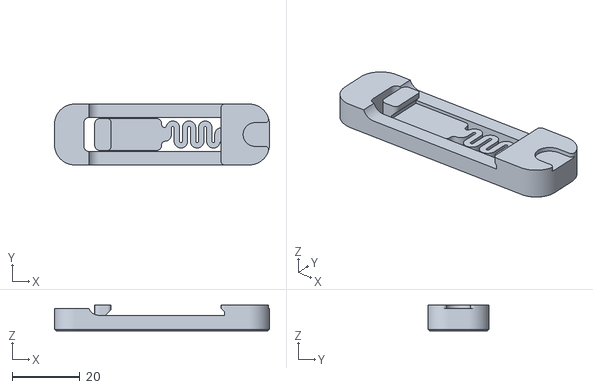
[picture p89: CAD file, 2022-03-22]
BETA3_IDEX_Release_STL/STLs/Panels/Bottom-panel-electronics-mounts/optional_din-ziptie.stl
63.6 x 18.0 x 7.60
