wandrewkeech/SnakeOil-XY/BETA3_IDEX_Release_STL/STLs/Panels/Bottom-panel-idex/1x_panel-BL.stl

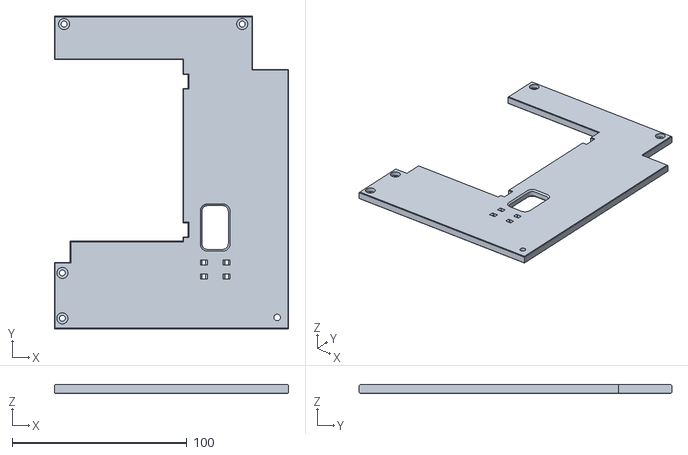
[picture p90: CAD file, 2023-02-25]
BETA3_IDEX_Release_STL/STLs/Panels/Bottom-panel-idex/1x_panel-BL.stl
134.0 x 179.0 x 5.00
