wandrewkeech/SnakeOil-XY/BETA3_IDEX_Release_STL/STLs/Panels/Front-panel/2x_latch.stl

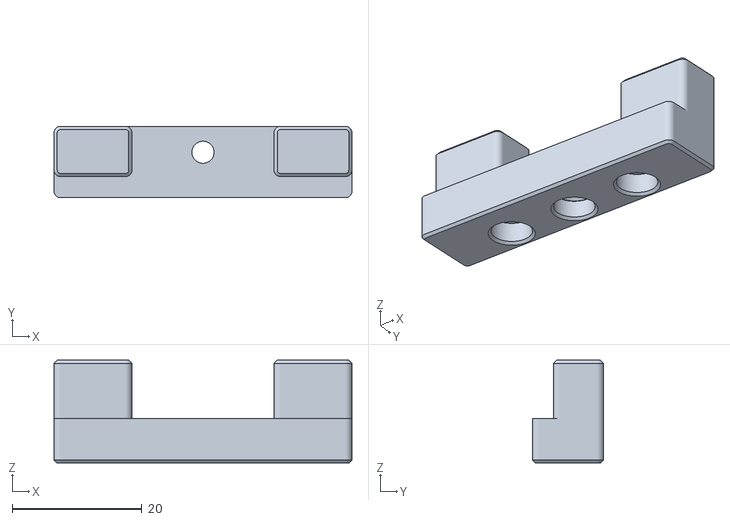
[picture p91: CAD file, 2023-02-25]
BETA3_IDEX_Release_STL/STLs/Panels/Front-panel/2x_latch.stl
45.9 x 11.0 x 15.8
