wandrewkeech/SnakeOil-XY/BETA3_IDEX_Release_STL/STLs/Tools/test-cube.stl

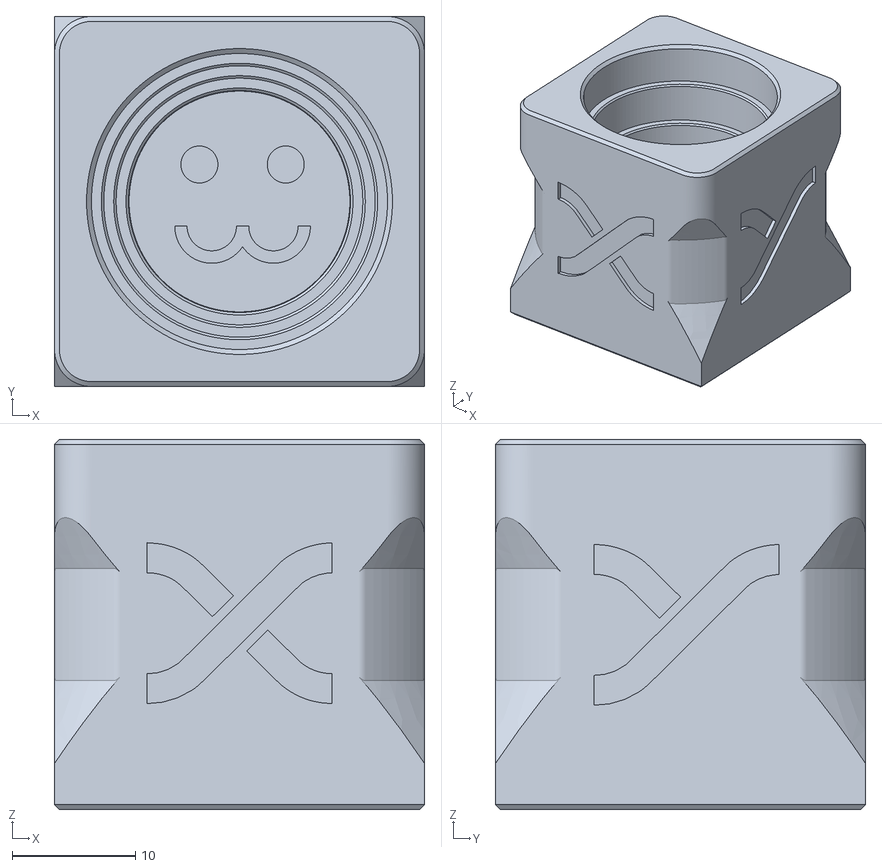
[picture p92: CAD file, 2023-02-25]
BETA3_IDEX_Release_STL/STLs/Tools/test-cube.stl
30.0 x 30.0 x 30.0
