wandrewkeech/SnakeOil-XY/BETA3_IDEX_Release_STL/STLs/XY-axis/x-axis/idex-x-endstops/1x_x_axis_flag_left.stl

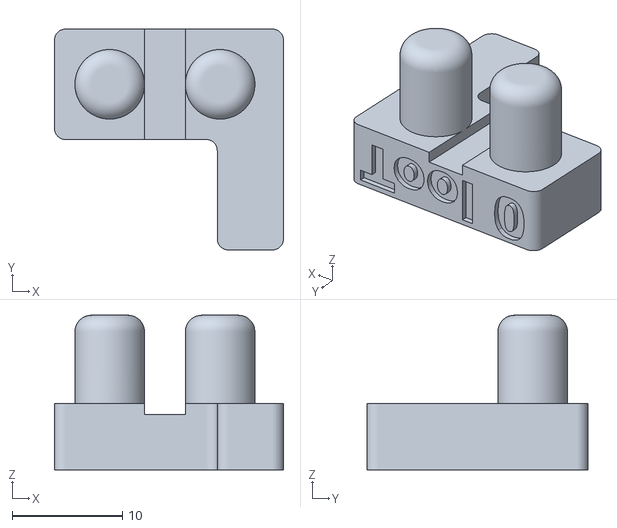
[picture p93: CAD file, 2023-02-25]
BETA3_IDEX_Release_STL/STLs/XY-axis/x-axis/idex-x-endstops/1x_x_axis_flag_left.stl
20.7 x 20.0 x 14.0
