wandrewkeech/SnakeOil-XY/BETA3_IDEX_Release_STL/STLs/XY-axis/x-axis/tensioning_x_idlers/2x_x_tensioning_idler_inner.stl

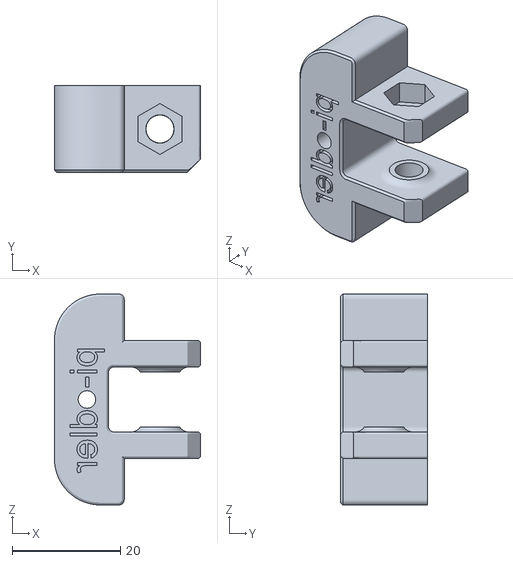
[picture p94: CAD file, 2023-02-25]
BETA3_IDEX_Release_STL/STLs/XY-axis/x-axis/tensioning_x_idlers/2x_x_tensioning_idler_inner.stl
27.0 x 16.0 x 39.0
