wandrewkeech/SnakeOil-XY/BETA3_IDEX_Release_STL/STLs/XY-axis/y-axis/idex_y_drives/1x_y_drive_left_top.stl

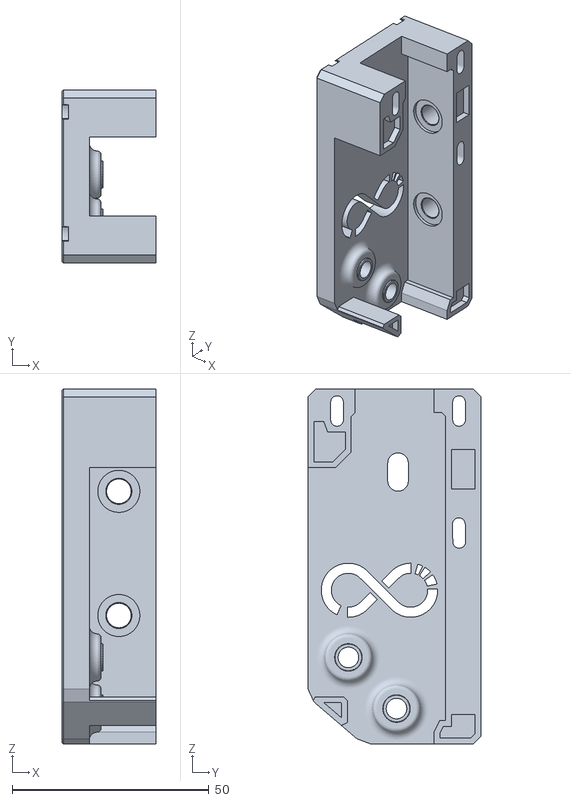
[picture p95: CAD file, 2023-02-25]
BETA3_IDEX_Release_STL/STLs/XY-axis/y-axis/idex_y_drives/1x_y_drive_left_top.stl
24.0 x 44.0 x 90.2
