wandrewkeech/SnakeOil-XY/BETA3_IDEX_Release_STL/STLs/XY-axis/y-axis/recommended-y-carrier-1515/1x_y-carrier-top-left.stl

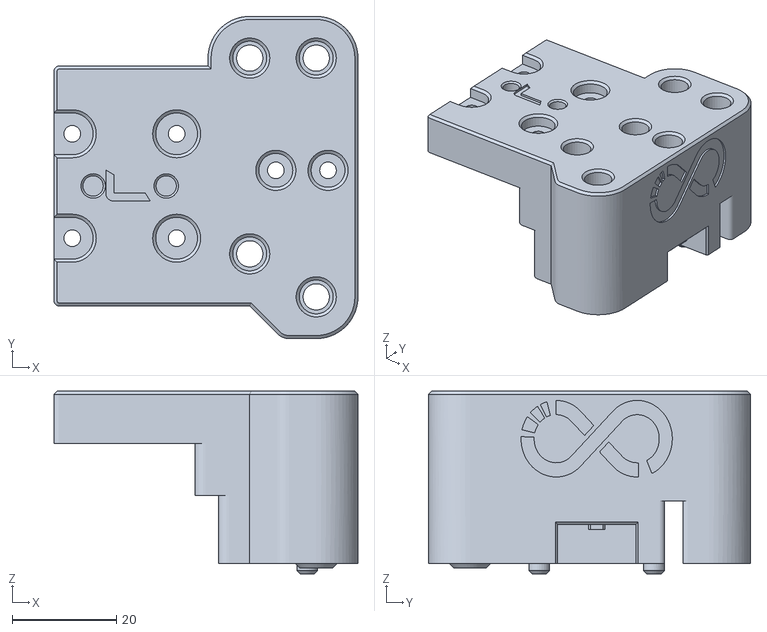
[picture p96: CAD file, 2023-02-25]
BETA3_IDEX_Release_STL/STLs/XY-axis/y-axis/recommended-y-carrier-1515/1x_y-carrier-top-left.stl
58.2 x 61.7 x 35.0
