wandrewkeech/SnakeOil-XY/BETA3_IDEX_Release_STL/STLs/Z-axis/2x_z-rail-block-mount-left-with-limiter.stl

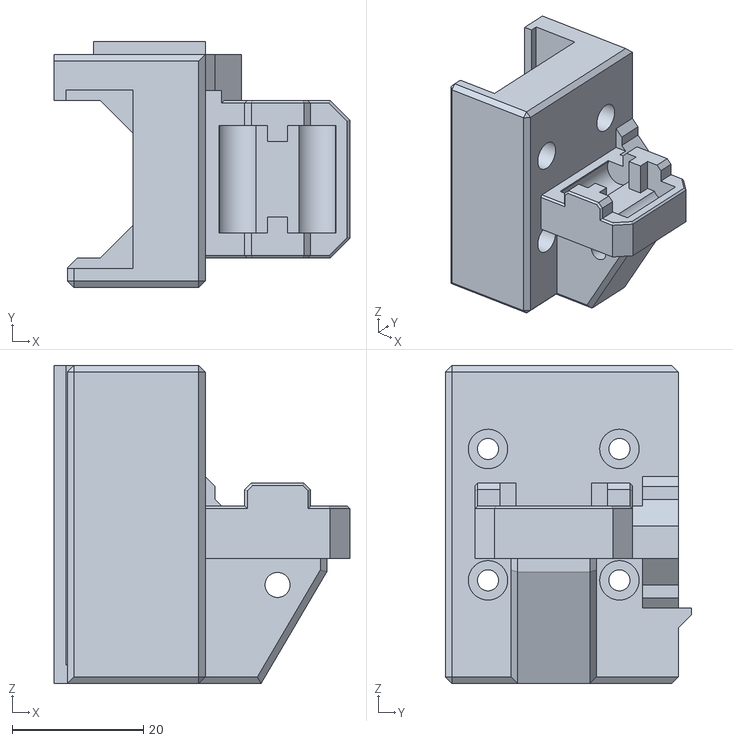
[picture p97: CAD file, 2022-01-15]
BETA3_IDEX_Release_STL/STLs/Z-axis/2x_z-rail-block-mount-left-with-limiter.stl
45.0 x 37.5 x 48.4
