wandrewkeech/SnakeOil-XY/BETA3_IDEX_Release_STL/STLs/Z-axis/bed-frame-2020/bed-arm-10x6x5-magnet-coupler/3x_bed-frame-top-arm-for-10x6x5-magnet.stl

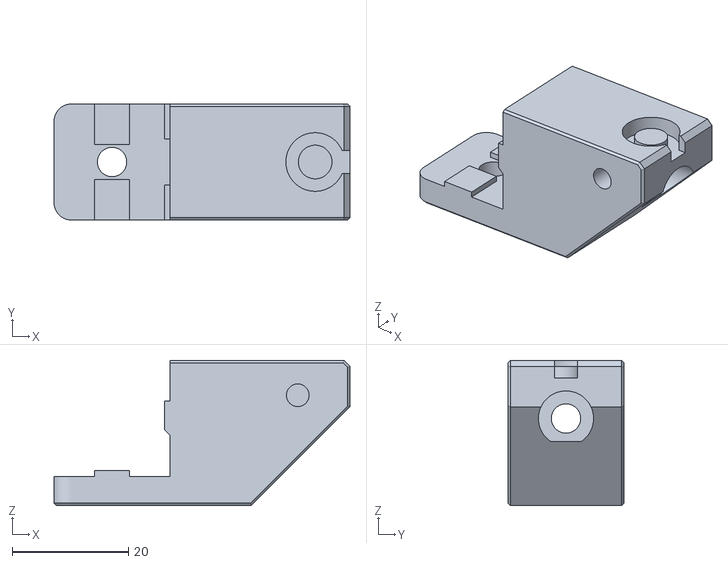
[picture p98: CAD file, 2023-02-25]
BETA3_IDEX_Release_STL/STLs/Z-axis/bed-frame-2020/bed-arm-10x6x5-magnet-coupler/3x_bed-frame-top-arm-for-10x6x5-magnet.stl
51.0 x 20.0 x 25.0
