wandrewkeech/SnakeOil-XY/BETA3_IDEX_Release_STL/STLs/Z-axis/recommended-bed-frame-1515/bed-arm-10x6x5-magnet-coupler/1x_front-left-arm.stl

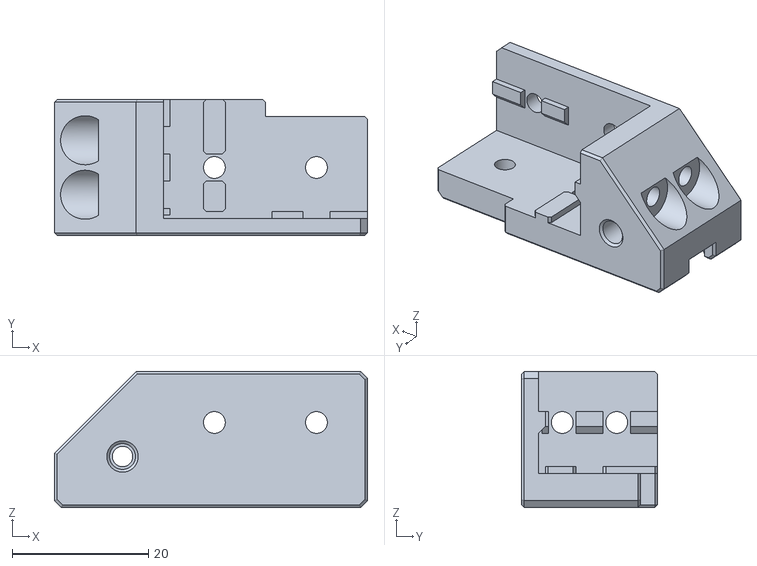
[picture p100: CAD file, 2022-03-22]
BETA3_IDEX_Release_STL/STLs/Z-axis/recommended-bed-frame-1515/bed-arm-10x6x5-magnet-coupler/1x_front-left-arm.stl
46.0 x 20.0 x 20.0
