wandrewkeech/SnakeOil-XY/BETA3_Standard_Release_STL/STLs/Add-on/Air-filter/1x_air-filter-body.stl

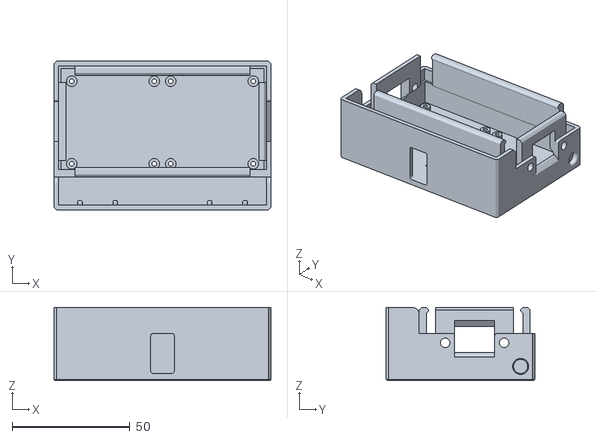
[picture p101: CAD file, 2021-12-01]
BETA3_Standard_Release_STL/STLs/Add-on/Air-filter/1x_air-filter-body.stl
92.0 x 63.0 x 31.0
