wandrewkeech/SnakeOil-XY/BETA3_Standard_Release_STL/STLs/Add-on/AUX-fan/1x_4028-fan-mounter.stl

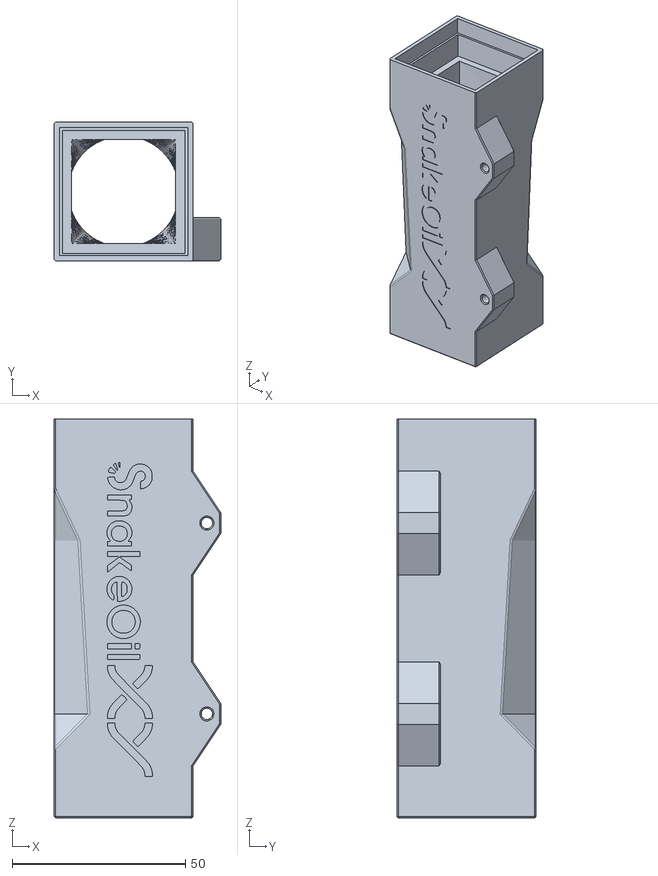
[picture p102: CAD file, 2023-02-25]
BETA3_Standard_Release_STL/STLs/Add-on/AUX-fan/1x_4028-fan-mounter.stl
48.0 x 40.0 x 115.0
