wandrewkeech/SnakeOil-XY/BETA3_Standard_Release_STL/STLs/Add-on/Bear-filament-sensor/1x_fs-arm-cap.stl

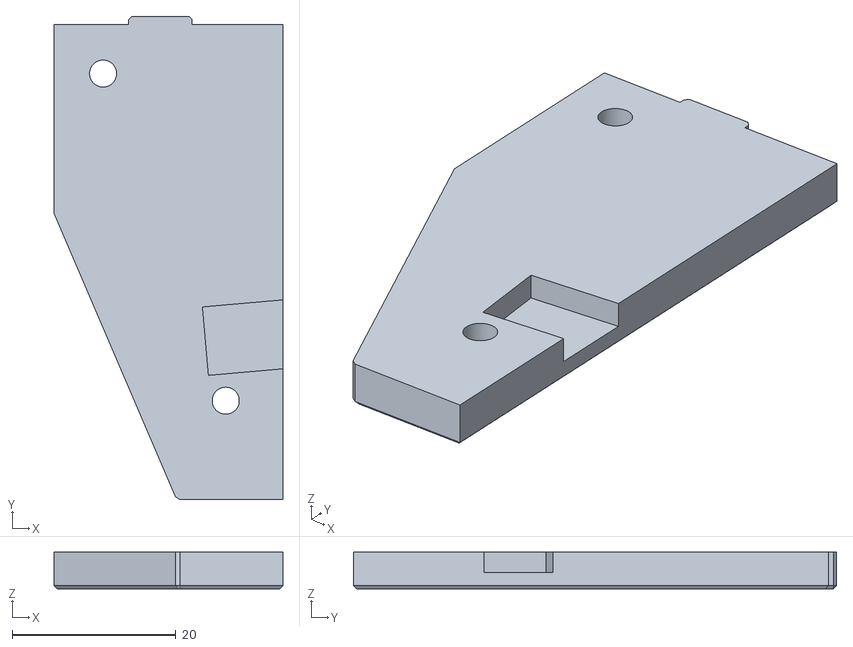
[picture p103: CAD file, 2023-02-25]
BETA3_Standard_Release_STL/STLs/Add-on/Bear-filament-sensor/1x_fs-arm-cap.stl
28.0 x 59.1 x 4.50
