wandrewkeech/SnakeOil-XY/BETA3_Standard_Release_STL/STLs/Add-on/Camera/1x_camera-back-plate.stl

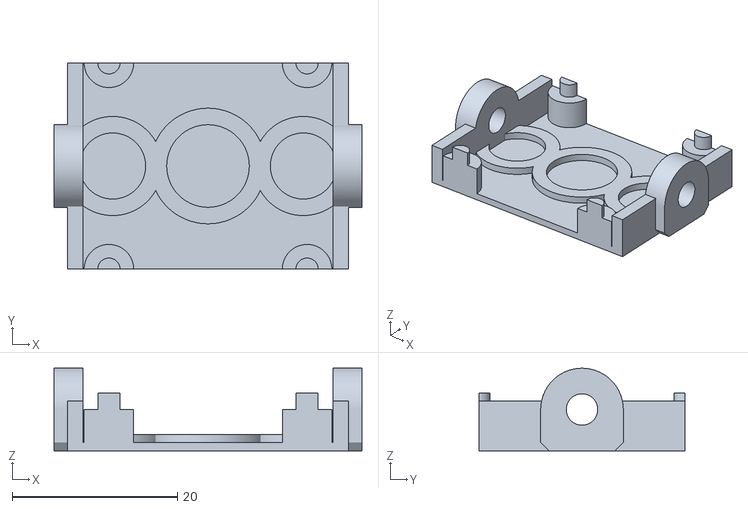
[picture p104: CAD file, 2023-02-25]
BETA3_Standard_Release_STL/STLs/Add-on/Camera/1x_camera-back-plate.stl
37.3 x 25.0 x 10.00
