wandrewkeech/SnakeOil-XY/BETA3_Standard_Release_STL/STLs/Add-on/Camera/corner-mount/1x_camera-axis.stl

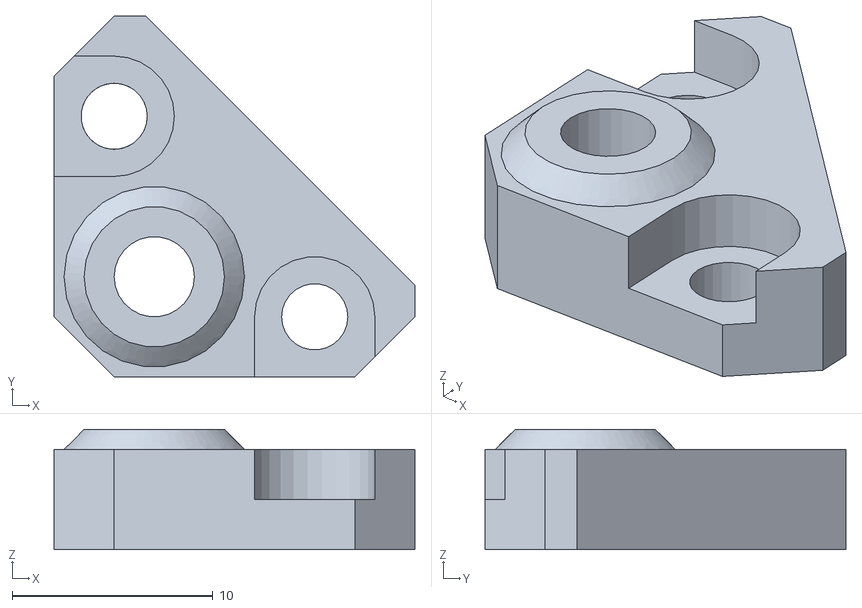
[picture p105: CAD file, 2022-03-22]
BETA3_Standard_Release_STL/STLs/Add-on/Camera/corner-mount/1x_camera-axis.stl
18.0 x 18.0 x 6.00
