wandrewkeech/SnakeOil-XY/BETA3_Standard_Release_STL/STLs/Add-on/Camera/extrusion-mount/1x_camera-arm-side-mount.stl

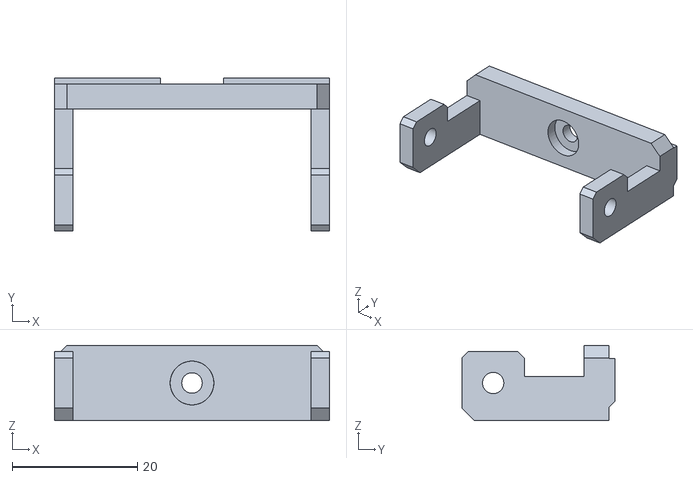
[picture p106: CAD file, 2022-03-22]
BETA3_Standard_Release_STL/STLs/Add-on/Camera/extrusion-mount/1x_camera-arm-side-mount.stl
44.0 x 24.5 x 12.0
