wandrewkeech/SnakeOil-XY/BETA3_Standard_Release_STL/STLs/Add-on/Spool-holder/1x_spool-holder-base.stl

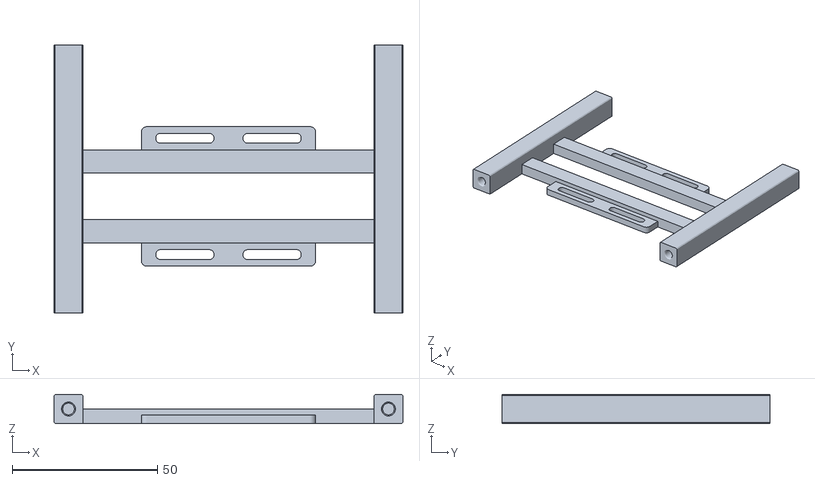
[picture p107: CAD file, 2023-02-25]
BETA3_Standard_Release_STL/STLs/Add-on/Spool-holder/1x_spool-holder-base.stl
120.0 x 92.0 x 10.0
