wandrewkeech/SnakeOil-XY/BETA3_Standard_Release_STL/STLs/E-axis/can-board/A_1x_can-pcb-mounter-cable-guide.stl

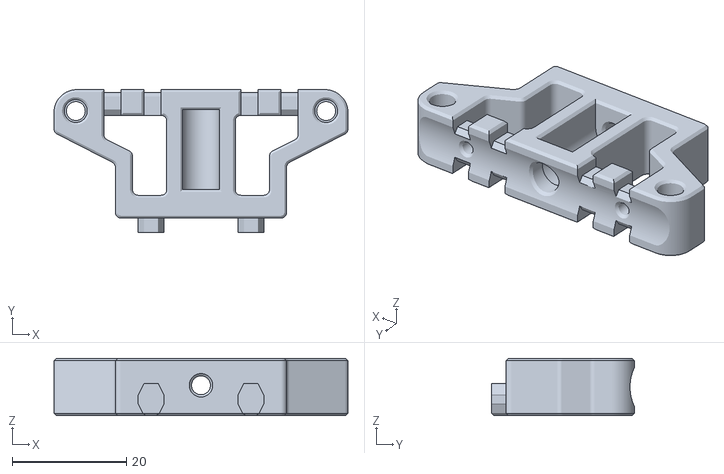
[picture p108: CAD file, 2023-02-25]
BETA3_Standard_Release_STL/STLs/E-axis/can-board/A_1x_can-pcb-mounter-cable-guide.stl
51.5 x 25.0 x 10.0
