wandrewkeech/SnakeOil-XY/BETA3_Standard_Release_STL/STLs/E-axis/carrier-common/A_2x_extruder-belt-tesioner.stl

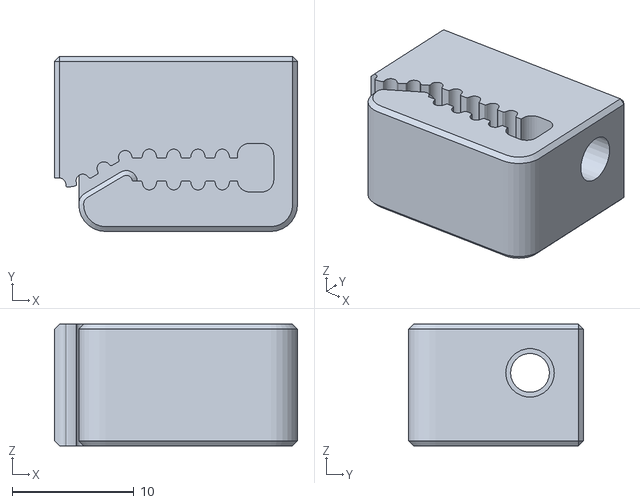
[picture p109: CAD file, 2023-02-25]
BETA3_Standard_Release_STL/STLs/E-axis/carrier-common/A_2x_extruder-belt-tesioner.stl
20.0 x 14.4 x 10.0
