wandrewkeech/SnakeOil-XY/BETA3_Standard_Release_STL/STLs/E-axis/hotend-mount-for-sherpa-mini/A_1x_top-plate-with-endstop-2020.stl

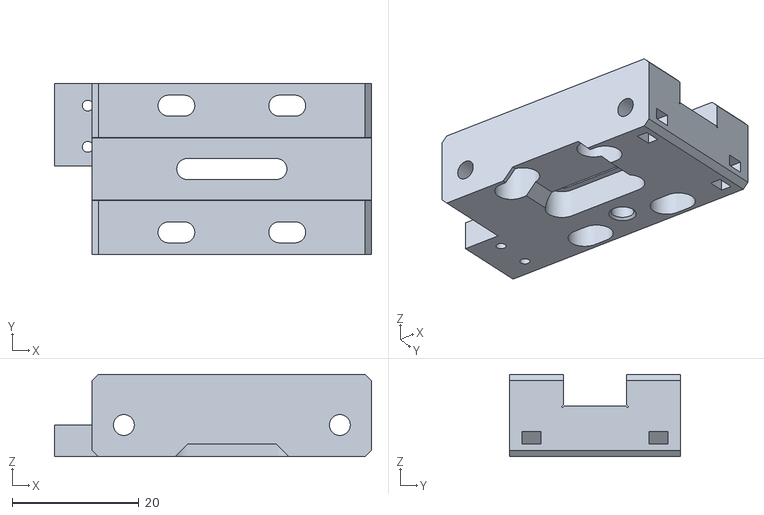
[picture p110: CAD file, 2023-02-25]
BETA3_Standard_Release_STL/STLs/E-axis/hotend-mount-for-sherpa-mini/A_1x_top-plate-with-endstop-2020.stl
50.0 x 27.0 x 13.0
