wandrewkeech/SnakeOil-XY/BETA3_Standard_Release_STL/STLs/E-axis/hotend-mount-for-sherpa-mini/cooper-head/C_1x_copper-head-support-b.stl

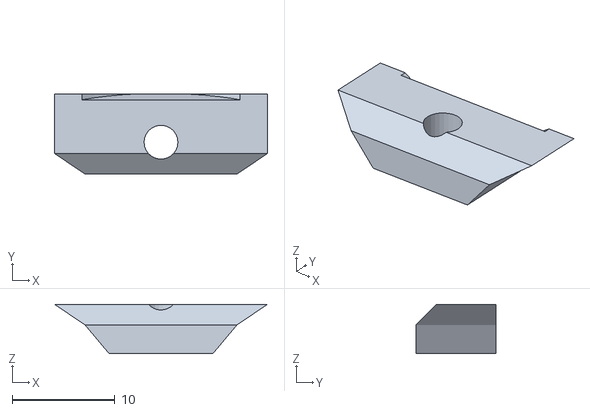
[picture p111: CAD file, 2022-03-22]
BETA3_Standard_Release_STL/STLs/E-axis/hotend-mount-for-sherpa-mini/cooper-head/C_1x_copper-head-support-b.stl
20.8 x 7.80 x 4.81
