wandrewkeech/SnakeOil-XY/BETA3_Standard_Release_STL/STLs/E-axis/hotend-mount-for-sherpa-mini/dragon/A_1x_dragon-mount-mod.stl

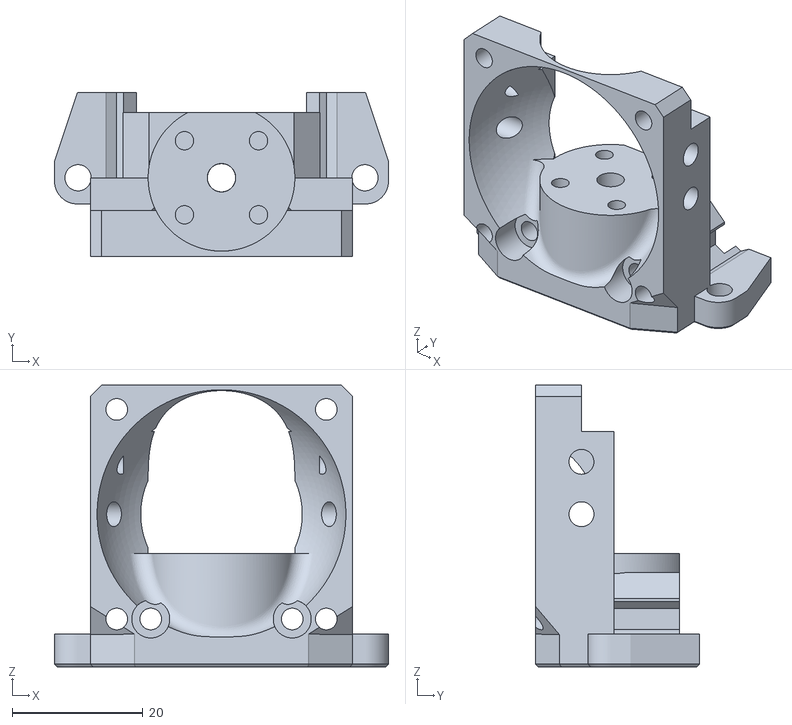
[picture p112: CAD file, 2022-03-22]
BETA3_Standard_Release_STL/STLs/E-axis/hotend-mount-for-sherpa-mini/dragon/A_1x_dragon-mount-mod.stl
51.0 x 25.0 x 43.0
