wandrewkeech/SnakeOil-XY/BETA3_Standard_Release_STL/STLs/E-axis/hotend-mount-for-sherpa-mini/mosquito/C_1x_mosquito-support.stl

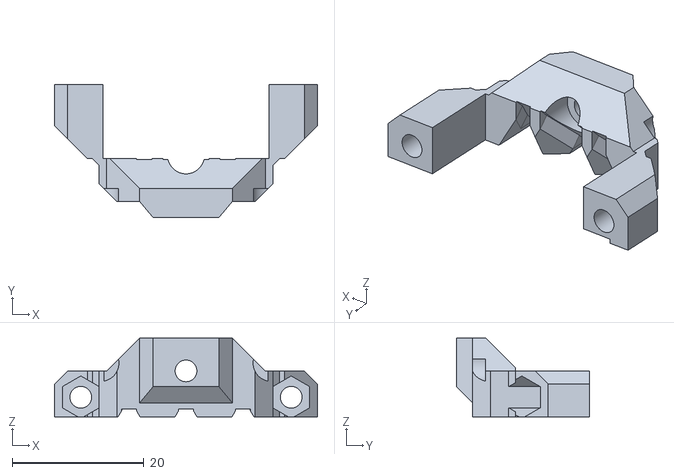
[picture p113: CAD file, 2022-03-22]
BETA3_Standard_Release_STL/STLs/E-axis/hotend-mount-for-sherpa-mini/mosquito/C_1x_mosquito-support.stl
40.0 x 20.2 x 12.0
