wandrewkeech/SnakeOil-XY/BETA3_Standard_Release_STL/STLs/E-axis/hotend-mount-for-sherpa-mini/nova/A_1x_nova-mount-mod.stl

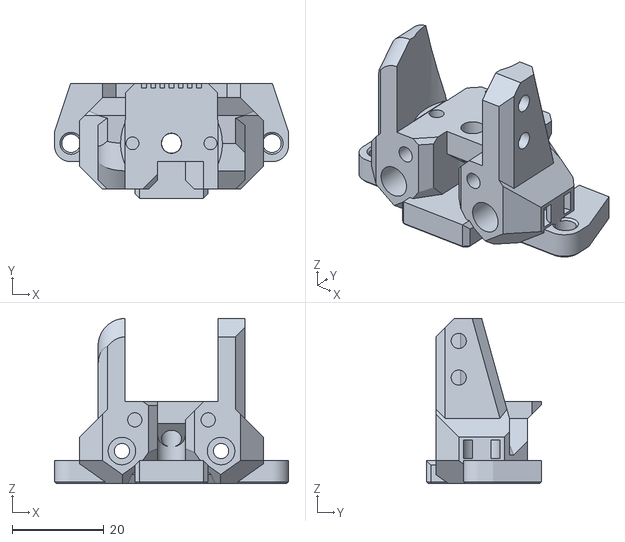
[picture p114: CAD file, 2021-12-27]
BETA3_Standard_Release_STL/STLs/E-axis/hotend-mount-for-sherpa-mini/nova/A_1x_nova-mount-mod.stl
51.0 x 25.0 x 36.0
