wandrewkeech/SnakeOil-XY/BETA3_Standard_Release_STL/STLs/E-axis/sherpa-mini-extruder/C_back-body.stl

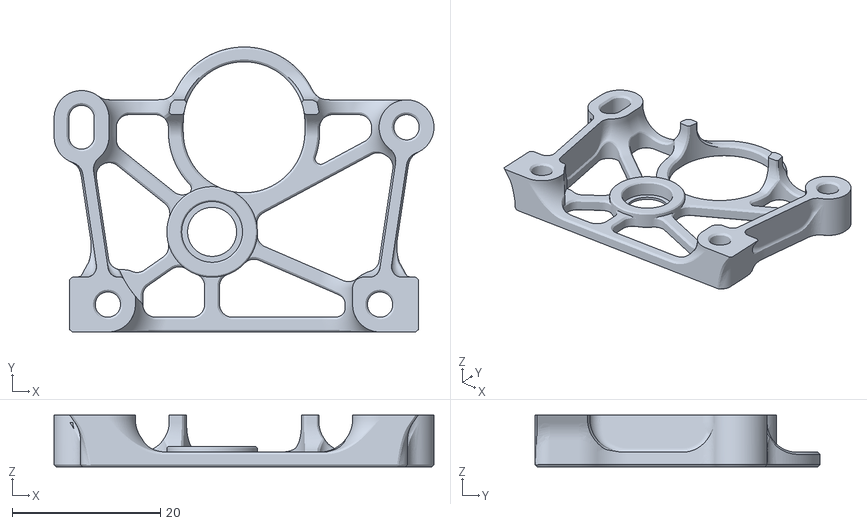
[picture p115: CAD file, 2021-12-01]
BETA3_Standard_Release_STL/STLs/E-axis/sherpa-mini-extruder/C_back-body.stl
51.2 x 38.4 x 7.00
