wandrewkeech/SnakeOil-XY/BETA3_Standard_Release_STL/STLs/E-axis/toolhead-pcb/A_pcb-spacer.stl

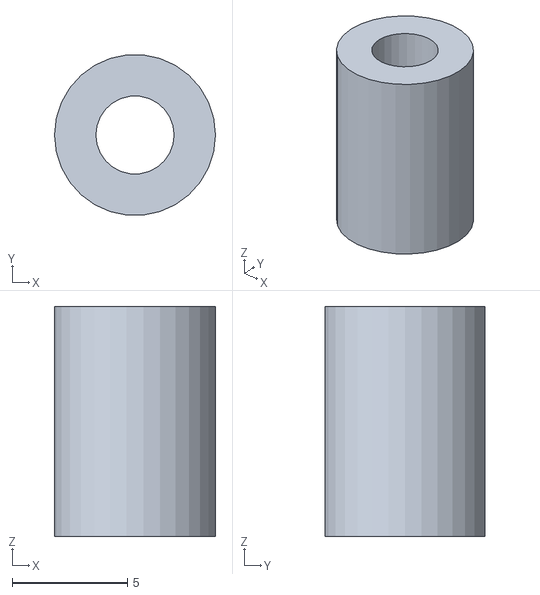
[picture p116: CAD file, 2023-02-25]
BETA3_Standard_Release_STL/STLs/E-axis/toolhead-pcb/A_pcb-spacer.stl
7.00 x 6.96 x 10.0
