wandrewkeech/SnakeOil-XY/BETA3_Standard_Release_STL/STLs/Panels/Back-panel/Bottom/OPTIONAL_1x_U2C-CAN-mounter.stl

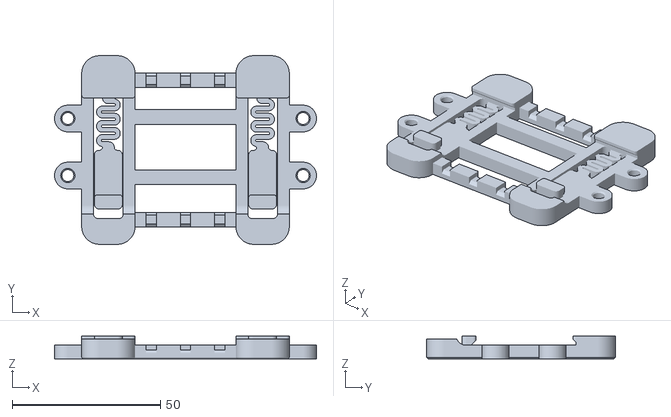
[picture p117: CAD file, 2023-05-15]
BETA3_Standard_Release_STL/STLs/Panels/Back-panel/Bottom/OPTIONAL_1x_U2C-CAN-mounter.stl
88.3 x 63.6 x 7.60
