wandrewkeech/SnakeOil-XY/BETA3_Standard_Release_STL/STLs/Panels/Back-panel/Top/M_1x_bottom-right-corner-mount.stl

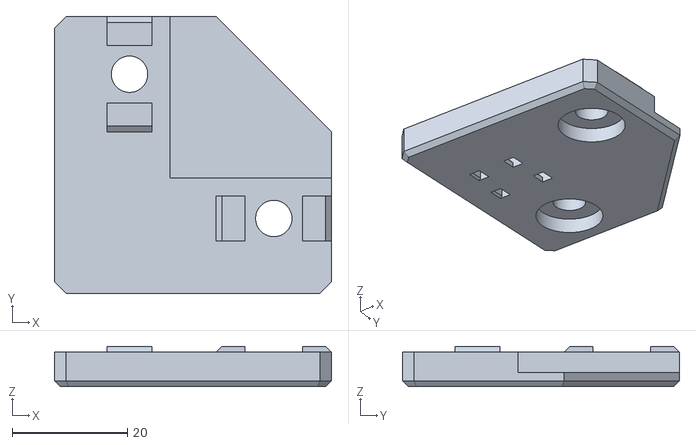
[picture p118: CAD file, 2022-01-15]
BETA3_Standard_Release_STL/STLs/Panels/Back-panel/Top/M_1x_bottom-right-corner-mount.stl
48.0 x 48.0 x 7.00
