wandrewkeech/SnakeOil-XY/BETA3_Standard_Release_STL/STLs/Panels/Bottom-panel-base-250/M_4x_bottom-din-holder.stl

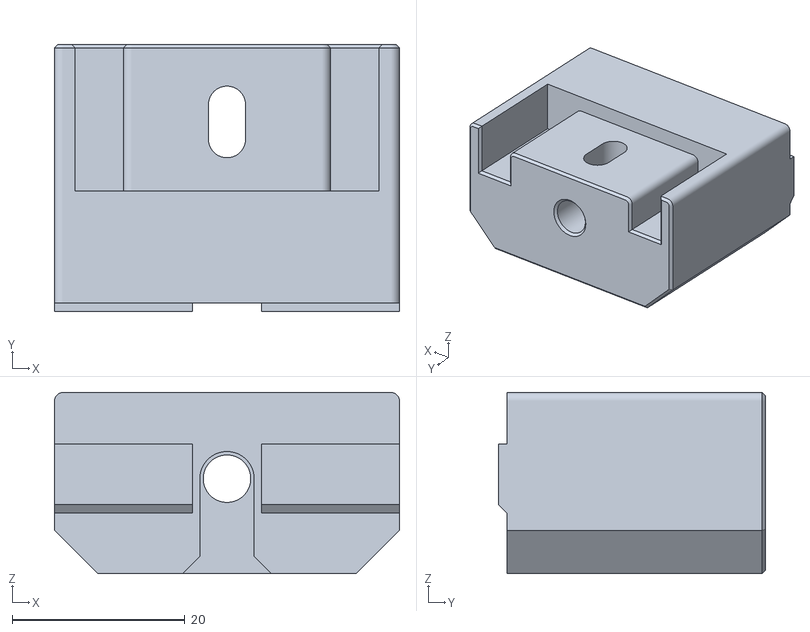
[picture p119: CAD file, 2021-12-01]
BETA3_Standard_Release_STL/STLs/Panels/Bottom-panel-base-250/M_4x_bottom-din-holder.stl
40.0 x 31.0 x 21.0
