wandrewkeech/SnakeOil-XY/BETA3_Standard_Release_STL/STLs/Panels/Bottom-panel/OPTIONAL_1x_fused-ac-inlet-with-switch.stl

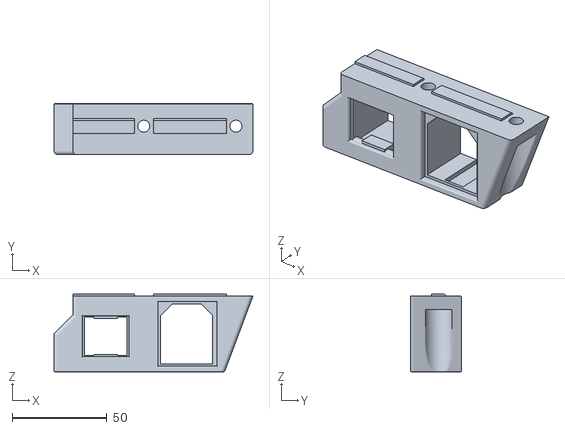
[picture p120: CAD file, 2023-02-25]
BETA3_Standard_Release_STL/STLs/Panels/Bottom-panel/OPTIONAL_1x_fused-ac-inlet-with-switch.stl
105.0 x 27.0 x 41.0
