wandrewkeech/SnakeOil-XY/BETA3_Standard_Release_STL/STLs/Panels/Front-panel/M_2x_side-hinge.stl

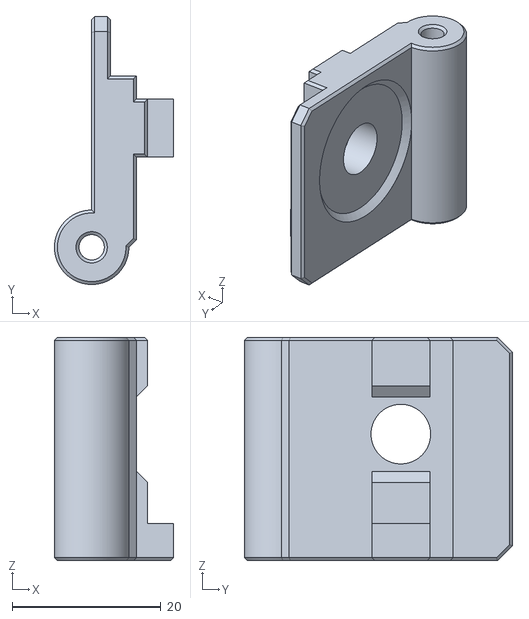
[picture p121: CAD file, 2022-03-22]
BETA3_Standard_Release_STL/STLs/Panels/Front-panel/M_2x_side-hinge.stl
16.0 x 36.0 x 30.0
