wandrewkeech/SnakeOil-XY/BETA3_Standard_Release_STL/STLs/Panels/Side-panel/OPTIONAL_24x_mounter-inner-more-clearance.stl

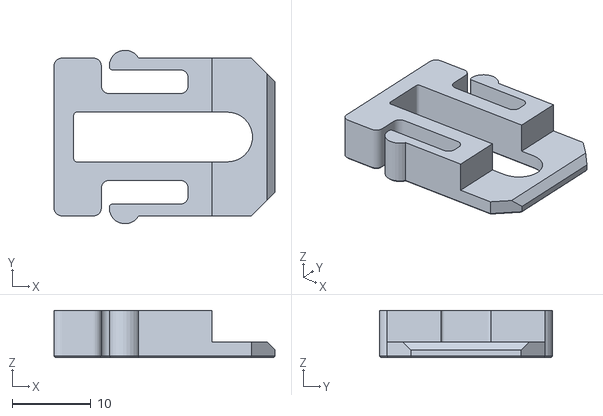
[picture p122: CAD file, 2023-02-25]
BETA3_Standard_Release_STL/STLs/Panels/Side-panel/OPTIONAL_24x_mounter-inner-more-clearance.stl
28.0 x 22.0 x 6.00
