wandrewkeech/SnakeOil-XY/BETA3_Standard_Release_STL/STLs/Panels/Top-lid/A_1x_lid-left-top-hinge.stl

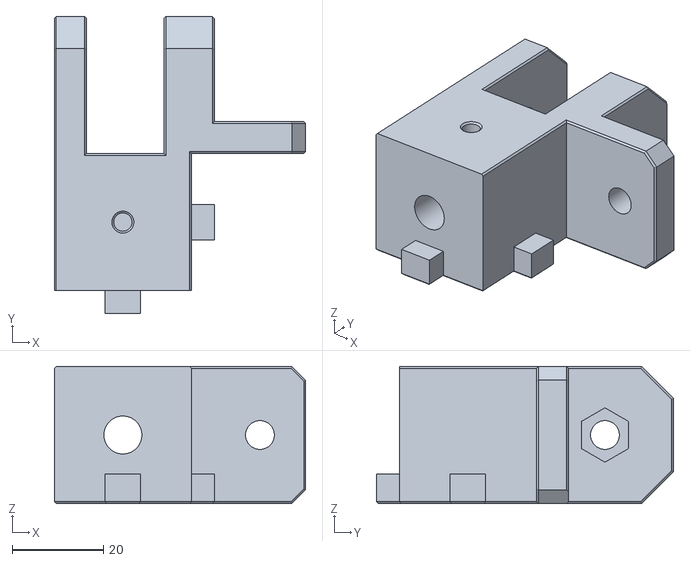
[picture p123: CAD file, 2021-12-01]
BETA3_Standard_Release_STL/STLs/Panels/Top-lid/A_1x_lid-left-top-hinge.stl
55.0 x 65.0 x 30.0
