wandrewkeech/SnakeOil-XY/BETA3_Standard_Release_STL/STLs/Tools/3030-rail-aligner.stl

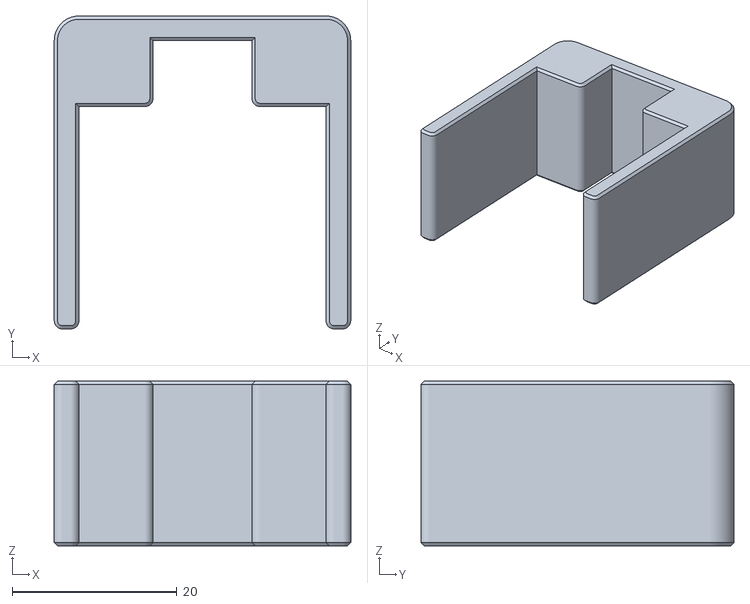
[picture p124: CAD file, 2023-02-25]
BETA3_Standard_Release_STL/STLs/Tools/3030-rail-aligner.stl
36.0 x 38.0 x 20.0
