wandrewkeech/SnakeOil-XY/BETA3_Standard_Release_STL/STLs/XY-axis/generic-x-endstop/A_1x_x-endstop-base.stl

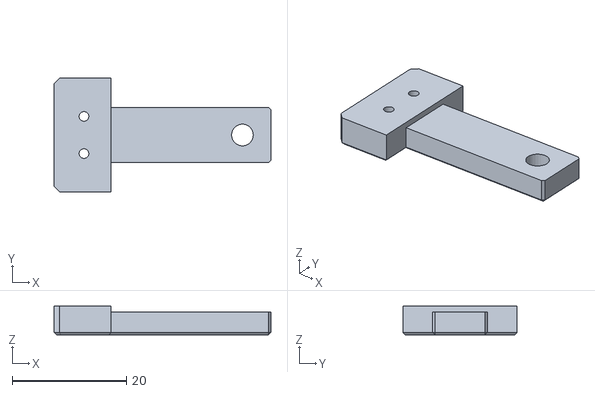
[picture p125: CAD file, 2023-02-25]
BETA3_Standard_Release_STL/STLs/XY-axis/generic-x-endstop/A_1x_x-endstop-base.stl
38.0 x 20.0 x 5.00
