wandrewkeech/SnakeOil-XY/BETA3_Standard_Release_STL/STLs/XY-axis/M_1x_ab-motor-top-right.stl

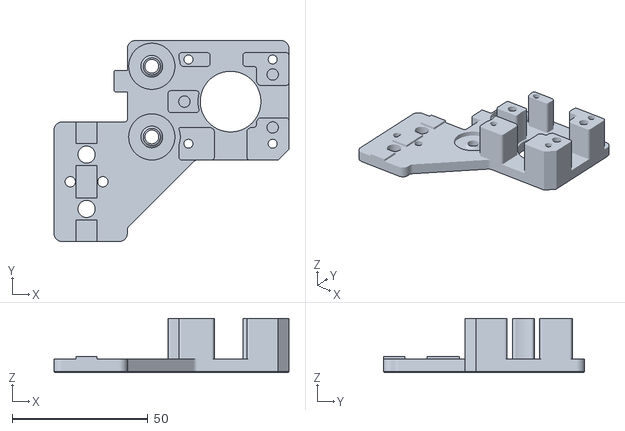
[picture p126: CAD file, 2023-02-25]
BETA3_Standard_Release_STL/STLs/XY-axis/M_1x_ab-motor-top-right.stl
86.5 x 74.0 x 20.0
