wandrewkeech/SnakeOil-XY/BETA3_Standard_Release_STL/STLs/XY-axis/recommended-y-carrier-1515/M_1x_y-carrier-bottom-left.stl

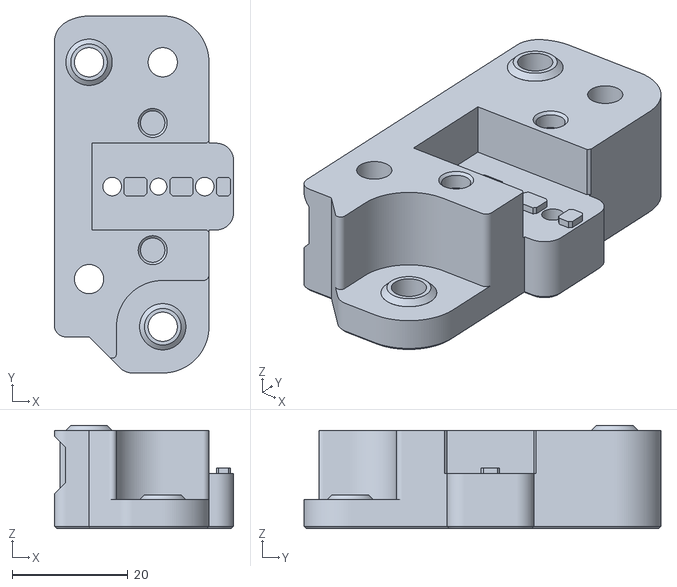
[picture p127: CAD file, 2022-03-22]
BETA3_Standard_Release_STL/STLs/XY-axis/recommended-y-carrier-1515/M_1x_y-carrier-bottom-left.stl
31.0 x 61.7 x 17.9
