wandrewkeech/SnakeOil-XY/BETA3_Standard_Release_STL/STLs/XY-axis/y-carrier-2020/M_1x_y-carrier-bottom-left.stl

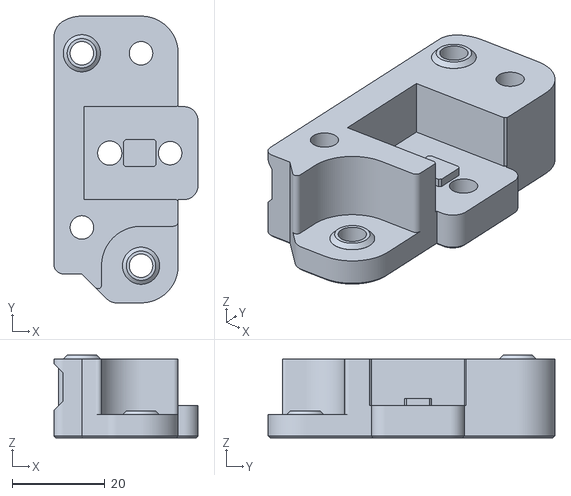
[picture p128: CAD file, 2023-02-25]
BETA3_Standard_Release_STL/STLs/XY-axis/y-carrier-2020/M_1x_y-carrier-bottom-left.stl
31.0 x 61.7 x 17.9
