wandrewkeech/SnakeOil-XY/BETA3_Standard_Release_STL/STLs/XY-axis/y-carrier-makerbeamxl/M_1x_y-carrier-bottom-right.stl

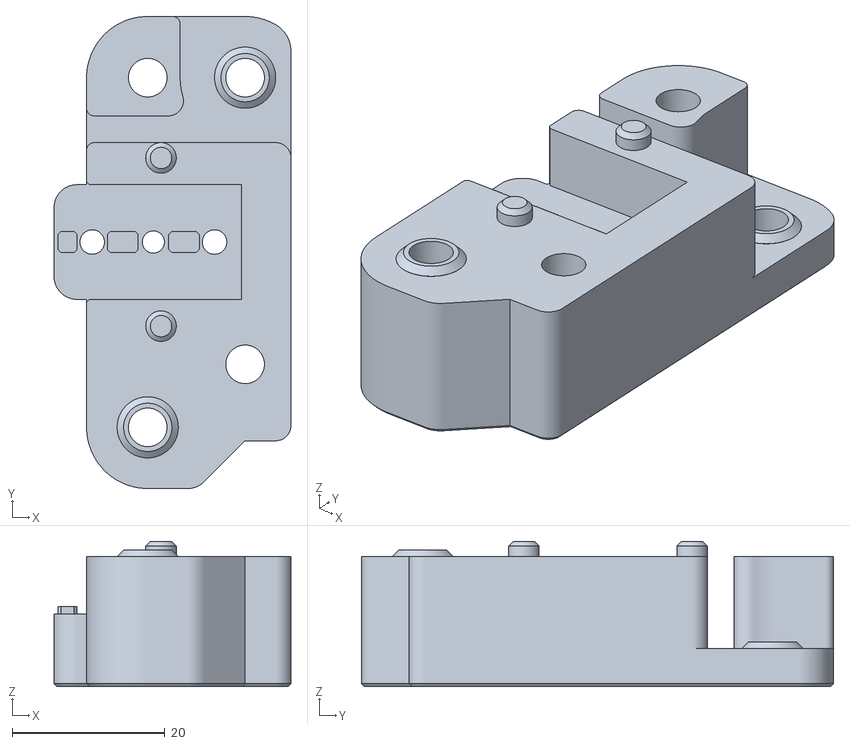
[picture p129: CAD file, 2023-02-25]
BETA3_Standard_Release_STL/STLs/XY-axis/y-carrier-makerbeamxl/M_1x_y-carrier-bottom-right.stl
31.0 x 61.7 x 19.0
