wandrewkeech/SnakeOil-XY/BETA3_Standard_Release_STL/STLs/Z-axis/A_3x_z-belt-block-mount.stl

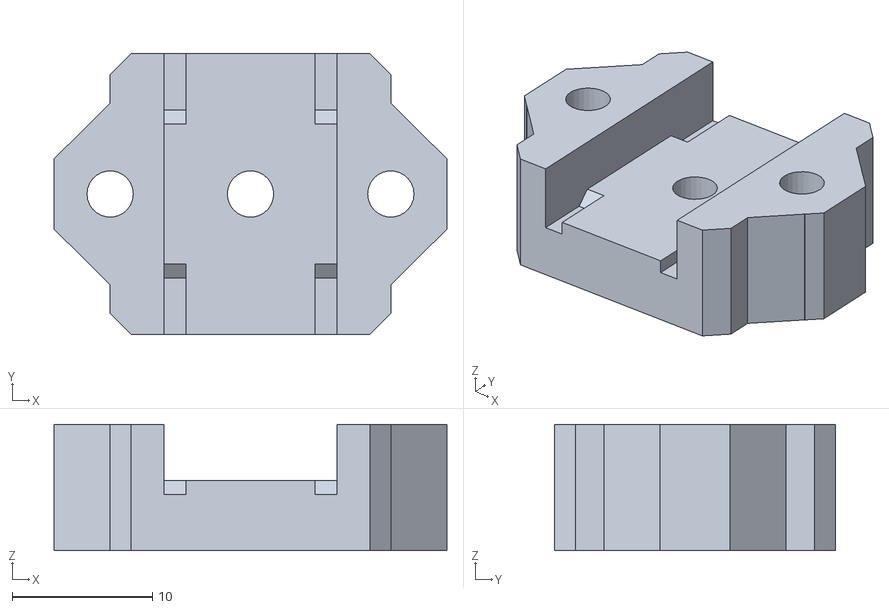
[picture p130: CAD file, 2023-02-25]
BETA3_Standard_Release_STL/STLs/Z-axis/A_3x_z-belt-block-mount.stl
28.0 x 20.0 x 9.00
