wandrewkeech/SnakeOil-XY/BETA3_Standard_Release_STL/STLs/Z-axis/bed-frame-2020/bed-arm-silicon-coupler(default-in-beta-3)/M_1x_front-left-arm.stl

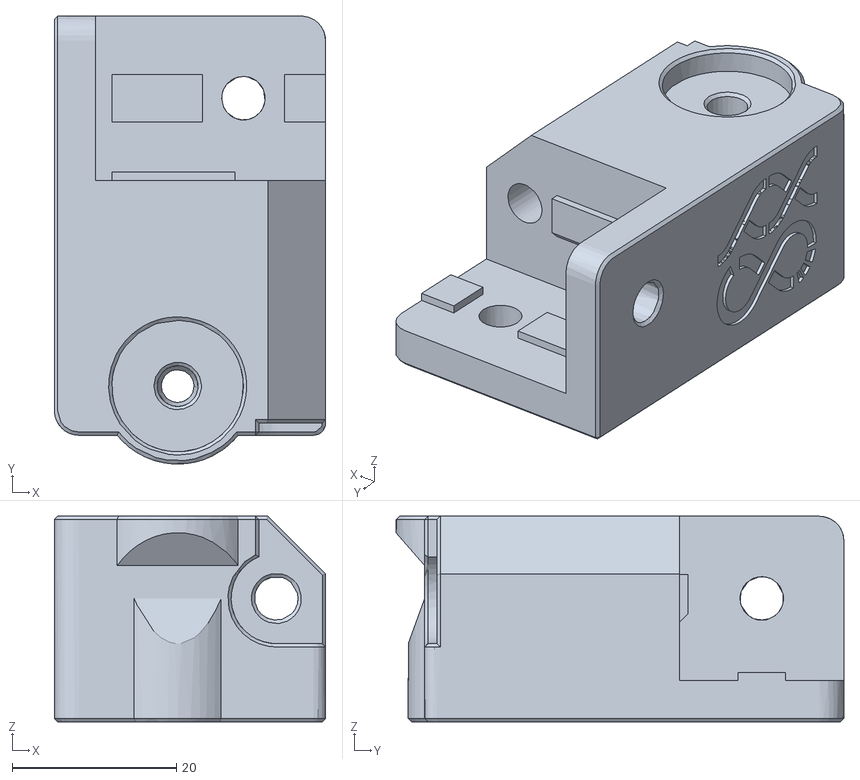
[picture p131: CAD file, 2023-02-25]
BETA3_Standard_Release_STL/STLs/Z-axis/bed-frame-2020/bed-arm-silicon-coupler(default-in-beta-3)/M_1x_front-left-arm.stl
33.0 x 54.5 x 25.0
