wandrewkeech/SnakeOil-XY/BETA3_Standard_Release_STL/STLs/Z-axis/bed-frame-2020/bed-arm-threaded-ball-coupler(default-in-beta-2)/A_3x_spacer.stl

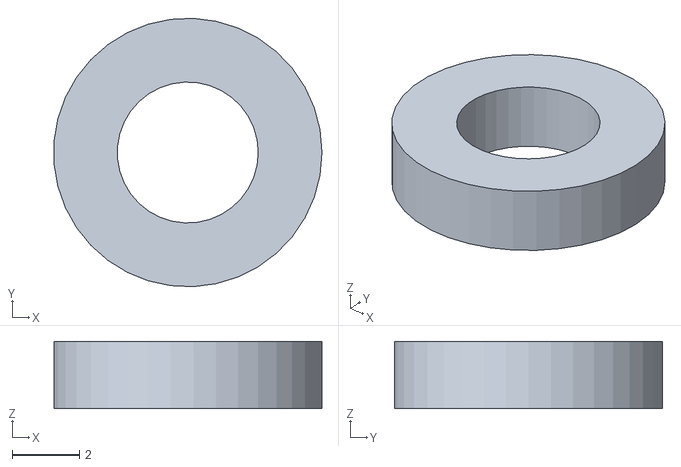
[picture p132: CAD file, 2022-03-22]
BETA3_Standard_Release_STL/STLs/Z-axis/bed-frame-2020/bed-arm-threaded-ball-coupler(default-in-beta-2)/A_3x_spacer.stl
7.99 x 7.99 x 2.00
