wandrewkeech/SnakeOil-XY/BETA3_Standard_Release_STL/STLs/Z-axis/bed-frame-2020/M_2x_120mm-fan-mounter-_for-250-machine.stl

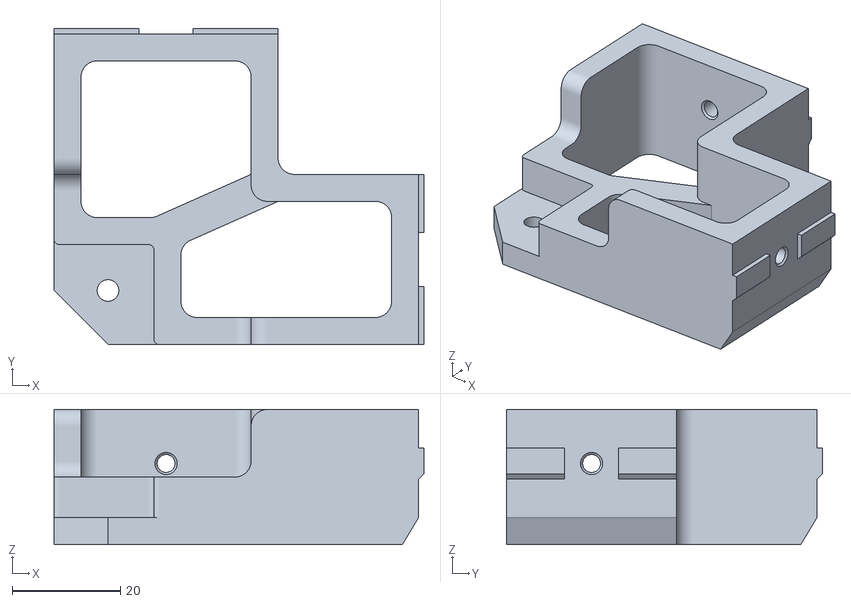
[picture p133: CAD file, 2023-02-25]
BETA3_Standard_Release_STL/STLs/Z-axis/bed-frame-2020/M_2x_120mm-fan-mounter-_for-250-machine.stl
68.5 x 58.5 x 25.0
