wandrewkeech/SnakeOil-XY/BETA3_Standard_Release_STL/STLs/Z-axis/bed-frame-makerbeamxl/bed-arm-threaded-ball-coupler/M_1x_middle-right-arm.stl

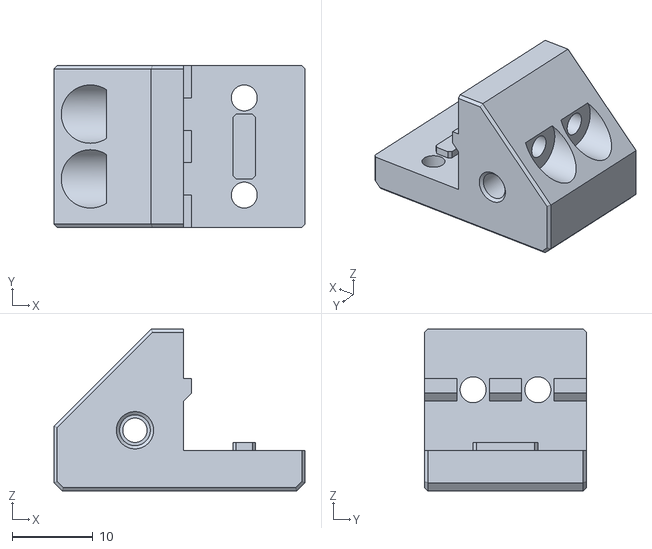
[picture p134: CAD file, 2023-02-25]
BETA3_Standard_Release_STL/STLs/Z-axis/bed-frame-makerbeamxl/bed-arm-threaded-ball-coupler/M_1x_middle-right-arm.stl
31.0 x 20.0 x 20.0
