wandrewkeech/SnakeOil-XY/BETA3_Standard_Release_STL/STLs/Z-axis/bed-frame-makerbeamxl/M_2x_extrusion-connector.stl

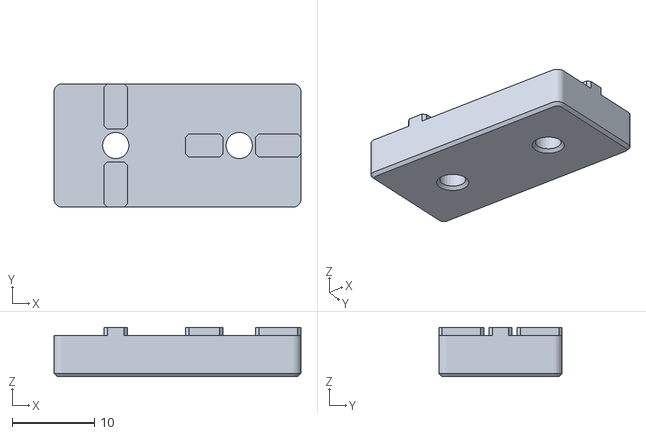
[picture p135: CAD file, 2023-02-25]
BETA3_Standard_Release_STL/STLs/Z-axis/bed-frame-makerbeamxl/M_2x_extrusion-connector.stl
30.0 x 15.0 x 6.00
