wandrewkeech/SnakeOil-XY/BETA3_Standard_Release_STL/STLs/Z-axis/recommended-bed-frame-1515/bed-arm-silicon-coupler(default-in-beta-3)/M_1x_middle-right-arm.stl

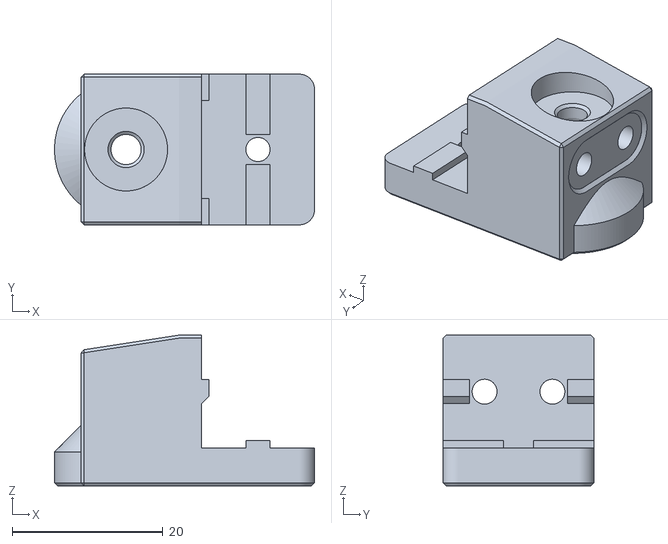
[picture p136: CAD file, 2023-02-25]
BETA3_Standard_Release_STL/STLs/Z-axis/recommended-bed-frame-1515/bed-arm-silicon-coupler(default-in-beta-3)/M_1x_middle-right-arm.stl
34.5 x 20.0 x 20.0
