wandrewkeech/SnakeOil-XY/BETA3_Standard_Release_STL/STLs/Z-axis/recommended-bed-frame-1515/OPTIONAL_1x_wago-mounter-2x4.stl

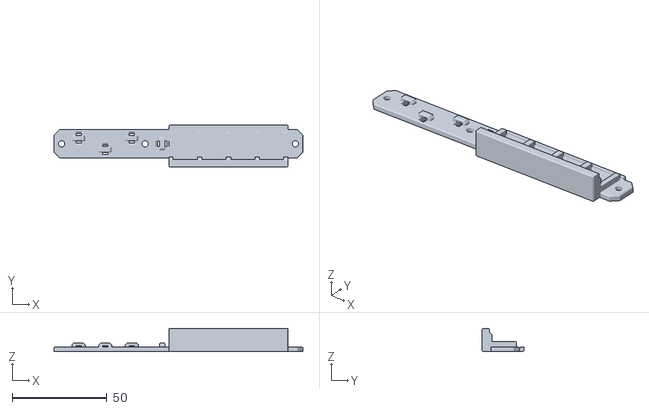
[picture p137: CAD file, 2023-02-25]
BETA3_Standard_Release_STL/STLs/Z-axis/recommended-bed-frame-1515/OPTIONAL_1x_wago-mounter-2x4.stl
131.2 x 22.3 x 12.2
