wandrewkeech/SnakeOil-XY/BETA3_Standard_Release_STL/STLs/Z-axis/z-counter-weight/M_1x_z-rail-block-mount-right.stl

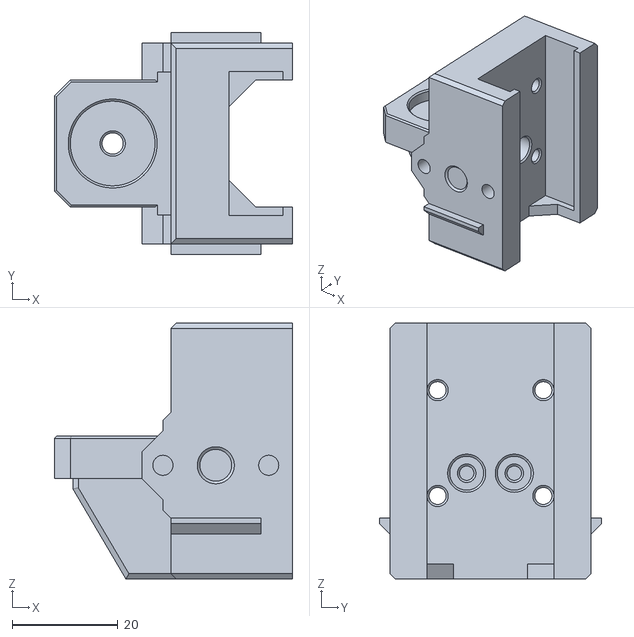
[picture p138: CAD file, 2023-02-25]
BETA3_Standard_Release_STL/STLs/Z-axis/z-counter-weight/M_1x_z-rail-block-mount-right.stl
45.0 x 42.0 x 48.4
