wandrewkeech/SnakeOil-XY/Doc/Manual/bottom_panel_180.dxf

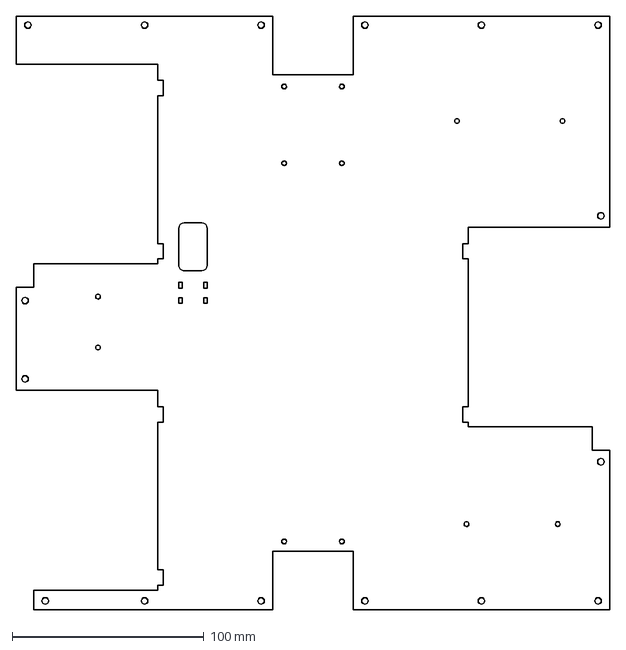
[picture p139: CAD file, 2021-12-01]
Doc/Manual/bottom_panel_180.dxf
309.0 x 309.0 mm
