wandrewkeech/SnakeOil-XY/Doc/Manual/Panels/DXF-180/side-panel.dxf

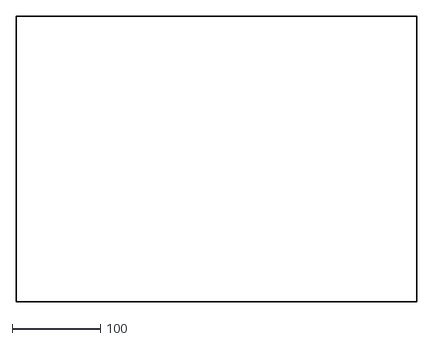
[picture p140: CAD file, 2022-03-22]
Doc/Manual/Panels/DXF-180/side-panel.dxf
454.0 x 324.0
