wandrewkeech/SnakeOil-XY/Doc/Manual/Panels/DXF-250/rear-top-panel.dxf

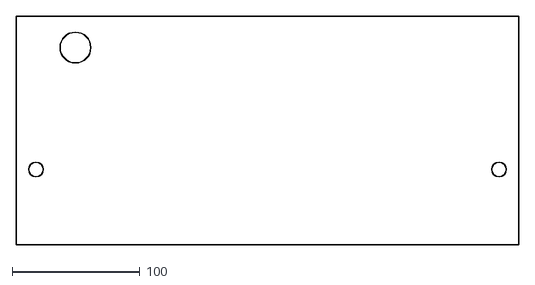
[picture p141: CAD file, 2022-03-22]
Doc/Manual/Panels/DXF-250/rear-top-panel.dxf
394.0 x 179.0
