wandrewkeech/SnakeOil-XY/(list of files, cad)

Other CAD files:
CAD/v1-180-assembly.FCStd
WIP/component-assembly/ab-y-motor-assembly.FCStd
WIP/component-assembly/y-carrier-left-2020-assembly.FCStd
WIP/component-assembly/z-motor-right-assembly.FCStd
WIP/component-assembly/z-idler-left-assembly.FCStd
WIP/component-assembly/front-left-idler-assembly.FCStd
WIP/component-assembly/y-carrier-left-1515-assembly.FCStd
BETA2_Release/STLs/E-axis/carrier-common/2020-carrier/1x_extruder-back-plate-wider.stl
BETA3_4PR_Release_STL/STLs/2020/M_1x_y-carrier-top-right.stl
BETA3_4PR_Release_STL/STLs/makerbeam-xl/M_1x_y-carrier-top-right.stl
BETA3_IDEX_Release_STL/STLs/XY-axis/y-axis/y-carrier-makerbeamxl/1x_y-carrier-top-right.stl
BETA3_Standard_Release_STL/STLs/Add-on/Filament-guide/1x_filament-guide-e3d-collet.stl
BETA3_Standard_Release_STL/STLs/Add-on/Neopixel-mount/2x_neopixel-arm-rev.stl
BETA3_Standard_Release_STL/STLs/Add-on/Retro-LCD/1x_lcd-arm-left.stl
BETA3_Standard_Release_STL/STLs/XY-axis/y-carrier-CF/M_1x_y-carrier-bottom-right.stl
BETA3_Standard_Release_STL/STLs/Z-axis/recommended-bed-frame-1515/bed-arm-threaded-ball-coupler(default-in-beta-2)/M_1x_front-left-arm.stl
BETA2_Release/STLs/Z-axis/patch/2x_left-cover.stl
BETA3_4PR_Release_STL/STLs/1515/M_1x_y-carrier-top-left.stl
BETA3_4PR_Release_STL/STLs/2020/M_1x_y-carrier-top-left.stl
BETA3_4PR_Release_STL/STLs/A_2x_c-belt-mounter-bottom.stl
BETA3_4PR_Release_STL/STLs/A_2x_c-motor-shaft-spacer.stl
BETA3_4PR_Release_STL/STLs/A_2x_c-tesioner-cap.stl
BETA3_4PR_Release_STL/STLs/M_1x_c-left-idler-mounter.stl
BETA3_4PR_Release_STL/STLs/M_1x_c-right-idler-mounter.stl
BETA3_4PR_Release_STL/STLs/M_1x_left-c-motor-mount-inner.stl
BETA3_4PR_Release_STL/STLs/M_1x_left-c-motor-mount-outer.stl
BETA3_4PR_Release_STL/STLs/M_1x_right-c-motor-mount-inner.stl
BETA3_4PR_Release_STL/STLs/M_1x_right-c-motor-mount-outer.stl
BETA3_4PR_Release_STL/STLs/M_2x_c-belt-mounter-top.stl
BETA3_4PR_Release_STL/STLs/OPTIONAL-4z/2x_bed-arm-mount.stl
BETA3_4PR_Release_STL/STLs/OPTIONAL_2x_c-tesioner-cap-m4-thread-insert.stl
BETA3_4PR_Release_STL/STLs/makerbeam-xl/M_1x_y-carrier-top-left.stl
BETA3_IDEX_Release_STL/STLs/Add-on/Air-filter/1x_air-filter-eject-level.stl
BETA3_IDEX_Release_STL/STLs/Add-on/Air-filter/1x_air-filter-front-cover.stl
BETA3_IDEX_Release_STL/STLs/Add-on/Air-filter/1x_air-filter-mounter-left.stl
BETA3_IDEX_Release_STL/STLs/Add-on/Bear-filament-sensor/1x_fs-level.stl
BETA3_IDEX_Release_STL/STLs/Add-on/Cherry-mx-button-mounter/button_cap_template.stl
BETA3_IDEX_Release_STL/STLs/Add-on/Filament-guide/1x_filament-guide-e3d-collet.stl
BETA3_IDEX_Release_STL/STLs/Add-on/Generic-temp-sensor/sensor-mount-clamp.stl
BETA3_IDEX_Release_STL/STLs/Add-on/Neopixel-mount/2x_neopixel-arm-rev.stl
BETA3_IDEX_Release_STL/STLs/Add-on/Ptfe-tube-guide/1x_ptfe-tube-guide-arm-angle.stl
BETA3_IDEX_Release_STL/STLs/Add-on/Ptfe-tube-guide/1x_ptfe-tube-guide-arm-straight.stl
BETA3_IDEX_Release_STL/STLs/Add-on/Retro-LCD/1x_lcd-arm-left.stl
BETA3_IDEX_Release_STL/STLs/Add-on/Retro-LCD/1x_lcd-button.stl
BETA3_IDEX_Release_STL/STLs/Add-on/Retro-LCD/1x_lcd-face.stl
BETA3_IDEX_Release_STL/STLs/Add-on/Retro-LCD/1x_lcd-knob.stl
BETA3_IDEX_Release_STL/STLs/Add-on/Retro-LCD/1x_lcd-mounter-left.stl
BETA3_IDEX_Release_STL/STLs/Add-on/Retro-LCD/1x_lcd-mounter-right.stl
BETA3_IDEX_Release_STL/STLs/Add-on/Retro-LCD/1x_led-cover_use_dark_color_filament.stl
BETA3_IDEX_Release_STL/STLs/Add-on/Spool-holder/2x_spool-holder-roller.stl
BETA3_IDEX_Release_STL/STLs/Add-on/Spool-holder/4x-spool-holder-spacer.stl
BETA3_IDEX_Release_STL/STLs/Add-on/alt-idler-for-flat-nut/1x_left-idler-bottom.stl
BETA3_IDEX_Release_STL/STLs/Add-on/alt-idler-for-flat-nut/1x_left-idler-top.stl
BETA3_IDEX_Release_STL/STLs/Add-on/alt-idler-for-flat-nut/1x_right-idler-bottom.stl
BETA3_IDEX_Release_STL/STLs/Add-on/alt-idler-for-flat-nut/1x_right-idler-mid.stl
BETA3_IDEX_Release_STL/STLs/Add-on/alt-idler-for-flat-nut/1x_right-idler-top.stl
BETA3_IDEX_Release_STL/STLs/Add-on/dual-5015-mod/1x_bottom-plate-1515-sensor-mount.stl
BETA3_IDEX_Release_STL/STLs/Add-on/dual-5015-mod/1x_extruder-cable-support.stl
BETA3_IDEX_Release_STL/STLs/Add-on/dual-5015-mod/1x_y-endstop-17mm-extended.stl
BETA3_IDEX_Release_STL/STLs/E-axis/carrier-common/1x_idex_back_plate_left.stl
BETA3_IDEX_Release_STL/STLs/E-axis/carrier-common/1x_idex_back_plate_right.stl
BETA3_IDEX_Release_STL/STLs/E-axis/carrier-common/1x_idex_front_plate_left.stl
BETA3_IDEX_Release_STL/STLs/E-axis/carrier-common/1x_idex_front_plate_right.stl
BETA3_IDEX_Release_STL/STLs/E-axis/carrier-common/1x_idex_top_plate_EBB36_endstop_left.stl
BETA3_IDEX_Release_STL/STLs/E-axis/carrier-common/2x_extruder_bottom_plate.stl
BETA3_IDEX_Release_STL/STLs/E-axis/carrier-common/2x_top-plate-spacer-for-1515-gantry.stl
BETA3_IDEX_Release_STL/STLs/E-axis/carrier-common/2x_triduct_Long_WIDE.stl
BETA3_IDEX_Release_STL/STLs/E-axis/carrier-common/2x_triduct_Short_NARROW.stl
BETA3_IDEX_Release_STL/STLs/E-axis/carrier-common/2x_triduct_Short_WIDE.stl
BETA3_IDEX_Release_STL/STLs/E-axis/klicky-probe/1x_probe.stl
BETA3_IDEX_Release_STL/STLs/E-axis/klicky-probe/1x_probe_dock.stl
BETA3_IDEX_Release_STL/STLs/E-axis/klicky-probe/2x_triduct_Long_WIDE.stl
BETA3_IDEX_Release_STL/STLs/E-axis/klicky-probe/2x_triduct_Short_NARROW.stl
BETA3_IDEX_Release_STL/STLs/E-axis/klicky-probe/2x_triduct_Short_WIDE.stl
BETA3_IDEX_Release_STL/STLs/E-axis/umbilical-splitter.stl
BETA3_IDEX_Release_STL/STLs/E-axis/z-bed-probe.stl
BETA3_IDEX_Release_STL/STLs/Panels/Bottom-panel-electronics-mounts/OPTIONAL_wago-5x1.stl
BETA3_IDEX_Release_STL/STLs/Panels/Bottom-panel-electronics-mounts/alt/1x_LRS_xx_200-psu-mounter-off-center-mirror.stl
BETA3_IDEX_Release_STL/STLs/Panels/Bottom-panel-electronics-mounts/alt/1x_LRS_xx_200-psu-mounter-off-center.stl
BETA3_IDEX_Release_STL/STLs/Panels/Bottom-panel-electronics-mounts/alt/1x_RS-25-5-PSU-mounter.stl
BETA3_IDEX_Release_STL/STLs/Panels/Bottom-panel-electronics-mounts/alt/2x_24v-150w-psu-din-mount-supporter.stl
BETA3_IDEX_Release_STL/STLs/Panels/Bottom-panel-electronics-mounts/alt/2x_24v-150w-psu-din-mount.stl
BETA3_IDEX_Release_STL/STLs/Panels/Bottom-panel-electronics-mounts/alt/OPTIONAL_RS-25-5-PSU-mounter-rotated.stl
BETA3_IDEX_Release_STL/STLs/Panels/Bottom-panel-electronics-mounts/alt/OPTIONAL_din-SONOFF-casing.stl
BETA3_IDEX_Release_STL/STLs/Panels/Bottom-panel-electronics-mounts/alt/OPTIONAL_din-SONOFF-mounter.stl
BETA3_IDEX_Release_STL/STLs/Panels/Bottom-panel-electronics-mounts/alt/OPTIONAL_din-SSR-mounter.stl
BETA3_IDEX_Release_STL/STLs/Panels/Bottom-panel-electronics-mounts/alt/OPTIONAL_din-buck-converter-mounter.stl
BETA3_IDEX_Release_STL/STLs/Panels/Bottom-panel-electronics-mounts/alt/OPTIONAL_din-cable-mounter-8mm-spacer.stl
BETA3_IDEX_Release_STL/STLs/Panels/Bottom-panel-electronics-mounts/alt/OPTIONAL_din-cable-mounter.stl
BETA3_IDEX_Release_STL/STLs/Panels/Bottom-panel-electronics-mounts/alt/OPTIONAL_din-wago-3-plus-5-mounter.stl
BETA3_IDEX_Release_STL/STLs/Panels/Bottom-panel-idex/1x_panel-BC1.stl
BETA3_IDEX_Release_STL/STLs/Panels/Bottom-panel-idex/1x_panel-BC2.stl
BETA3_IDEX_Release_STL/STLs/Panels/Bottom-panel-idex/1x_panel-BR.stl
BETA3_IDEX_Release_STL/STLs/Panels/Bottom-panel-idex/1x_panel-FC1.stl
BETA3_IDEX_Release_STL/STLs/Panels/Bottom-panel-idex/1x_panel-FC2.stl
BETA3_IDEX_Release_STL/STLs/Panels/Bottom-panel-idex/1x_panel-FL.stl
BETA3_IDEX_Release_STL/STLs/Panels/Bottom-panel-idex/1x_panel-FR.stl
BETA3_IDEX_Release_STL/STLs/Panels/Bottom-panel-idex/1x_right_center_connector.stl
BETA3_IDEX_Release_STL/STLs/Panels/Front-panel/2x_handle1.stl
BETA3_IDEX_Release_STL/STLs/Panels/Front-panel/2x_handle2.stl
BETA3_IDEX_Release_STL/STLs/Tools/2020-rail-aligner.stl
BETA3_IDEX_Release_STL/STLs/Tools/2gt-strap-inner.stl
BETA3_IDEX_Release_STL/STLs/Tools/2gt-strap-outer.stl
BETA3_IDEX_Release_STL/STLs/Tools/3060-rail-aligner.stl
BETA3_IDEX_Release_STL/STLs/Tools/belt-tesioner-gauge-6mm.stl
BETA3_IDEX_Release_STL/STLs/Tools/belt-tesioner-gauge-9mm.stl.stl
BETA3_IDEX_Release_STL/STLs/Tools/din-rail-cutter.stl
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
