wandrewkeech/SnakeOil-XY/Doc/Manual/README.md

# Manual

- [Bed and extrusion drilling](./bed-extrusion.md)
- [How to print the parts](./printing.md)
- [Build log/assembly manual](./build-log.md)
- [EVA2 toolhead system "compatible"](./eva2.md)
- [tuning](./tuning.md)
