wandrewkeech/SnakeOil-XY/Doc/Manual/bed-extrusion.md

# Aluminum bed plate and extrusion drilling location

## Aluminum bed plate

- The hole diameter for m3 bolt hand bolt head need to be at least the same or slightly bigger than the size in the drawing (except the d2.6mm holes that need to be tapped). Those hole side are calculated to encounter thermal expansions of the bed plate.

### 180mm machine



### 250mm machine



## Extrusion

- The hole diameter for 450/500/550mm extrusion is about 6.5~7.5mm (for m8 allen key access)
- The hole diameter for 280/330mm extrusion is about 6.5~7.5mm (for m6 allen key access)
- All extrusions will need to be M8 tapped.
- There are printable drilling jig and taping guide STLs in BETA2_Release/STLs/Tools/ directory.
