wandrewkeech/SnakeOil-XY/Doc/Manual/eva2.md

# EVA2.4 toolhead system "compatible"

- The printer designed to able to use most of extruders and hotends in EVA 2 eco system. Titan aero and Hemera are not supported due the head heavy and wide design will reduce the useable area of the bed.

## Common parts for extruder available at [E-axis stl](https://github.com/ChipCE/SnakeOil-XY/tree/master/BETA2_Release/STLs/E-axis/carrier-common)

- 1x_extruder-back-plate.stl
- 1x_extruder-front-plate.stl
- 1x_extruder-bottom-plate.stl
- 1x_duct-tri-horn.stl
- 1x_extruder-cable-support.stl
- 2x_extruder-belt-mounter.stl
- 2x_extruder-belt-clamp.stl
- 1x_bltouch-mount.stl
- 1x_extruder-cable-end-mounter.stl

## Compact Sherpa mini mount

- The Sherpa mini mounter of SnakeOilXY have about 16mm shorter filament path compare to standard EVA2 mount.
- The default extruder option modified version of [Annex Engineering's Sherpa mini](https://github.com/Annex-Engineering/Sherpa_Mini-Extruder). Extruder parts available at [sherpa-mini-extruder-mod Stl](https://github.com/ChipCE/SnakeOil-XY/tree/master/BETA2_Release/STLs/E-axis/sherpa-mini-extruder-mod) and require 1 [E3D collet clip](https://e3d-online.com/products/collet-clips-pack-of-2)
- This version of sherpa mini mounter only support 4 hotends. Copperhead, Mosquito, Dragon, Dragonfly BMO(use the same mounter as Dragon hotend) and Nova(Not tested). For v6 and other hotends, use [P-C-R's Sherpa Mini Mount](https://github.com/EVA-3D/contrib-extras/blob/main/docs/extruders/pcr-sherpa-mini.md) or [Official Eva2 Sherpa mini mount](https://main.eva-3d.page/drives/sherpa_mini/) instead.

## Other hotends, extruders, fan ducts support

- Other extruders, hotend specified mounters and fan ducts can be found at [EVA 2 page](https://main.eva-3d.page/)
