wandrewkeech/SnakeOil-XY/Electronics/toolhead-board/toolhead-board.kicad_pcb

## KiCad design Electronics/toolhead-board/toolhead-board.kicad_pcb (2023-02-25)

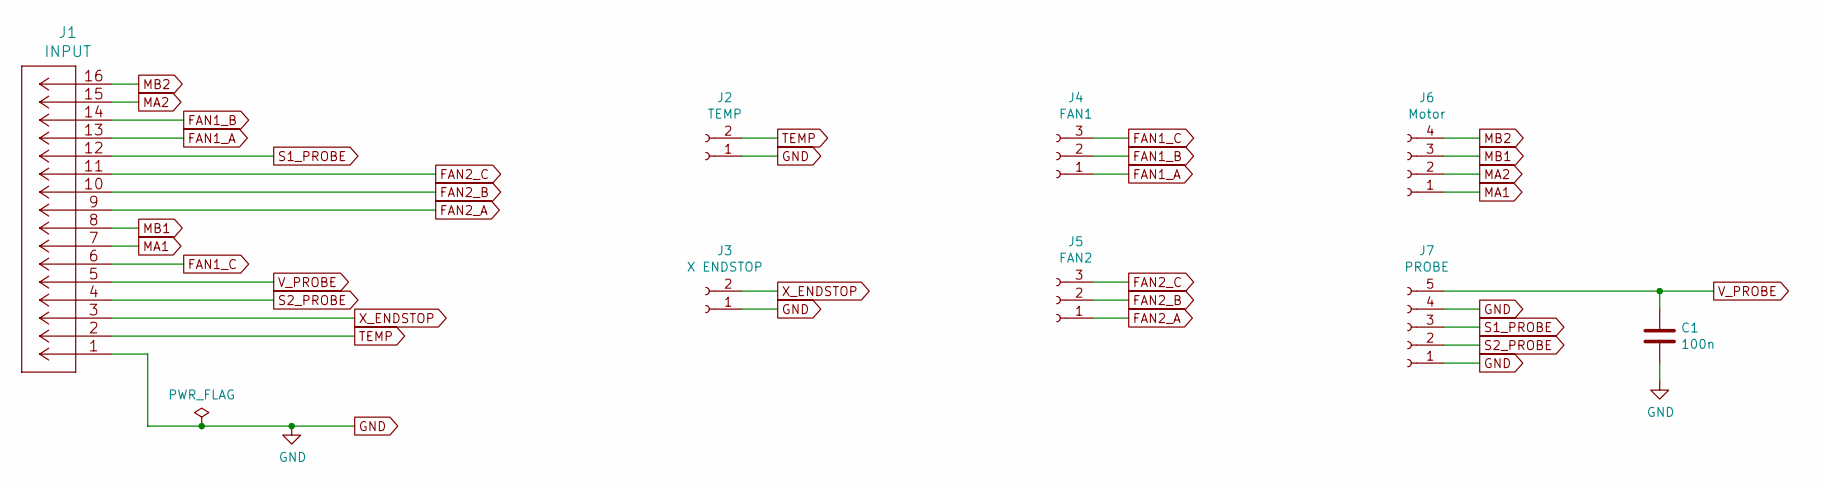
[picture p150: schematic toolhead-board.sch]

Parts:
C1: 100n; C_0805_2012Metric_Pad1.15x1.40mm_HandSolder
J1: INPUT; microfit-16
J2: TEMP; JST_XH_B02B-XH-A_1x02_P2.50mm_Vertical
J3: X ENDSTOP; JST_XH_B02B-XH-A_1x02_P2.50mm_Vertical
J4: FAN1; JST_XH_B03B-XH-A_1x03_P2.50mm_Vertical
J5: FAN2; JST_XH_B03B-XH-A_1x03_P2.50mm_Vertical
J6: Motor; JST_XH_B04B-XH-A_1x04_P2.50mm_Vertical
J7: PROBE; JST_XH_B05B-XH-A_1x05_P2.50mm_Vertical

Connections:
FAN1_A: J1.13, J4.1
FAN1_B: J1.14, J4.2
FAN1_C: J1.6, J4.3
FAN2_A: J1.9, J5.1
FAN2_B: J1.10, J5.2
FAN2_C: J1.11, J5.3
GND: C1.2, J1.1, J2.1, J3.1, J7.1, J7.4
MA1: J1.7, J6.1
MA2: J1.15, J6.2
MB1: J1.8, J6.3
MB2: J1.16, J6.4
S1_PROBE: J1.12, J7.3
S2_PROBE: J1.4, J7.2
TEMP: J1.2, J2.2
V_PROBE: C1.1, J1.5, J7.5
X_ENDSTOP: J1.3, J3.2

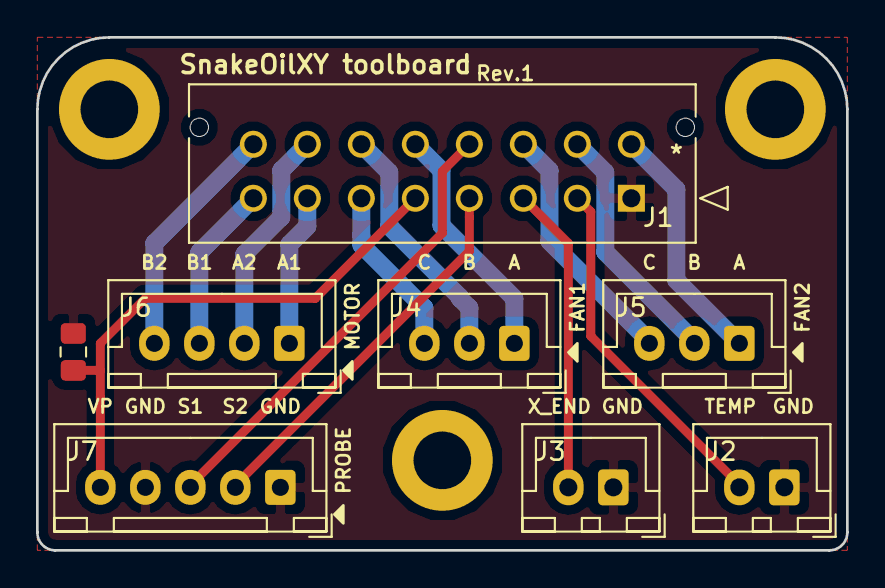
[picture p151: board toolhead-board.kicad_pcb from above]

Board: 2 copper layers, 45.0 x 28.5 mm, 8 parts (0 on the bottom side), 16 nets.
